mkinderwater/mk-timeclock/tools/acceptance/README.md

# Acceptance coverage

Run `python3 tests/run_current.py` from the package root. The obsolete per-employee-tab workbook fixture is replaced by the current two-tab, employee-block, precision and note-limit fixtures in the manifest. `WALKTHROUGH_CONTRACT.md` remains a broader acceptance plan, not a claim that physical-device workflows have been completed.
