mkinderwater/mk-timeclock/Timeclock-Wall-Mounting-Template.pdf

Timeclock wall mounting template | Case v8.34 · full size

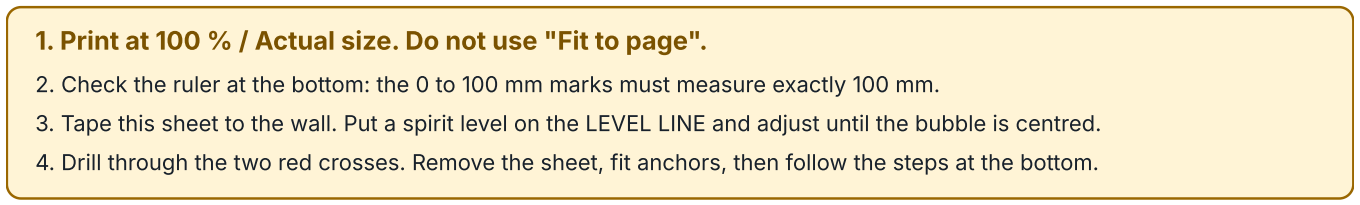
[picture p15: figure]

1. Print at 100 % / Actual size. Do not use "Fit to page".
2. Check the ruler at the bottom: the 0 to 100 mm marks must measure exactly 100 mm.
3. Tape this sheet to the wall. Put a spirit level on the LEVEL LINE and adjust until the bubble is centred.
4. Drill through the two red crosses. Remove the sheet, fit anchors, then follow the steps at the bottom.
LEVEL LINE | LEVEL LINE

Top edge of the clock

Power cable exits here

Centre

DRILL | DRILL

80 mm between screws

51 m

m

Grey shapes: keyholes on the back of the clock. The screw heads enter the round part, then the clock slides down 9 mm.

After drilling

1. Fit wall anchors in the two holes (use anchors that suit your wall).
2. Screw in two pan-head screws (head up to 8 mm wide, shank up to 4.3 mm). Leave the heads about 3 mm out from the wall.
3. Place the clock so the screw heads go into the round part
of the keyholes, then slide it down until it stops.
4. Plug in the power cable from below.

Dashed line: outline of the clock (128 × 140 mm) as it will hang

Scale check: 0 to 100 mm must measure exactly 100 mm

0 | 10 | 20 | 30 | 40 | 50 | 60 | 70 | 80 | 90 | 100
tape | tape
tape | tape

Mount away from direct sunlight and large metal surfaces, near a power socket, at a height staff can reach easily.

iCube Development (Calgary) Ltd. · mk-timeclock Lite
