mkinderwater/mk-timeclock/assembled.stl

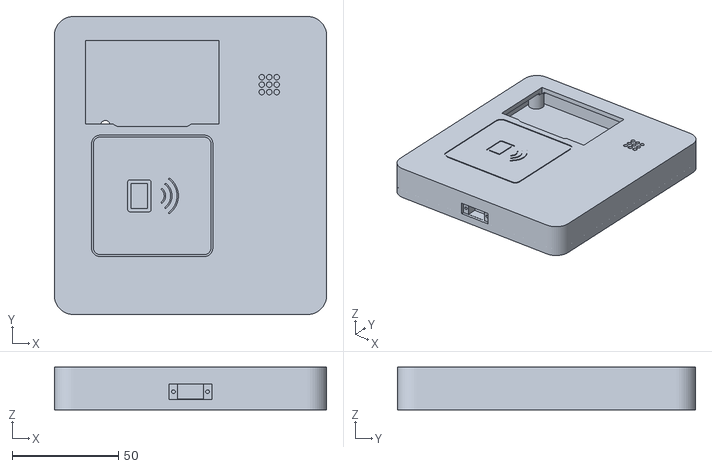
[picture p16: CAD file, 2026-10-24]
assembled.stl
128.0 x 140.0 x 20.0
