mkinderwater/mk-timeclock/front-wifi.stl

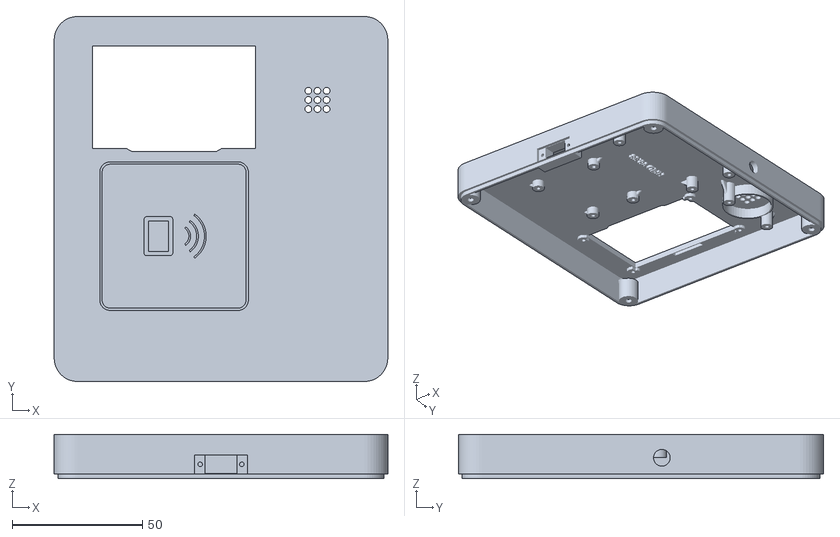
[picture p17: CAD file, 2026-10-25]
front-wifi.stl
128.0 x 140.0 x 17.0
