mkinderwater/mk-timeclock/back.stl

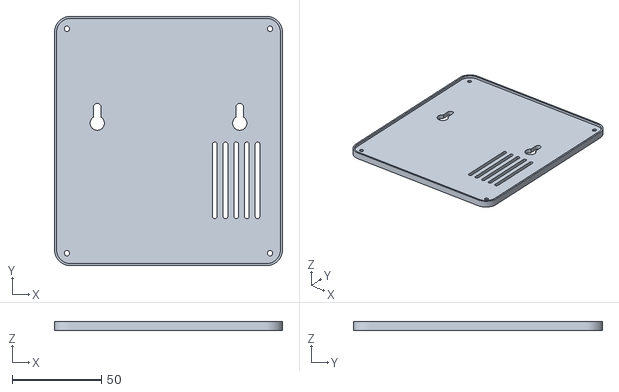
[picture p18: CAD file, 2026-10-24]
back.stl
128.0 x 140.0 x 4.80
