mkinderwater/mk-timeclock/(list of files, cad)

Other CAD files:
front.stl
