mkinderwater/mk-timeclock/validation/RC5.23-build.txt

PASS make ui all lint and Python compilation.
Six targeted checks passed. Actual setup handlers and configure function exercised with isolated files, simulated Primary API and systemctl outcomes. Source fallback and installed CSS checked. All three service failure points leave no marker. Saved credentials finish setup without re-poll after in-memory state reset. Slow Primary response leaves GET responsive and rejects concurrent setup actions. Desktop/mobile and dark/light setup checks pass. No full application suite repeated; no hardware deployment performed.
