mkinderwater/mk-timeclock/Timeclock-Employee-Guide.pdf

# Timeclock Employee Guide

I C U B E D E V E L O P M E N T ( C A L G A R Y ) LT D .

### How to tap in and out, explain a late start or early departure, check

your timesheet and request vacation.

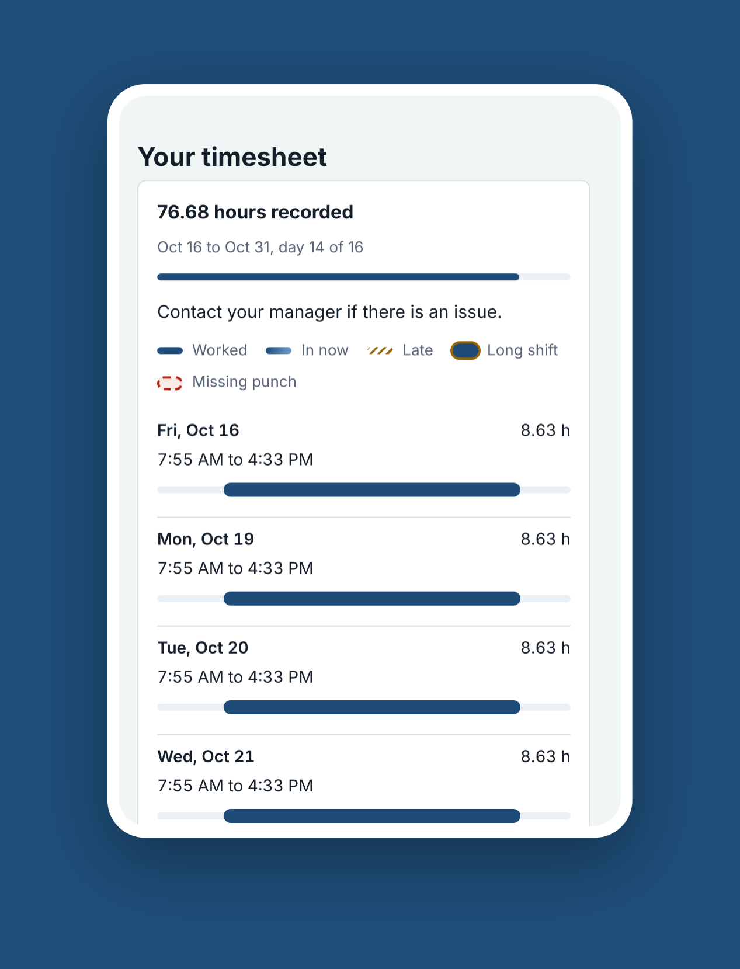
[picture p42: figure]
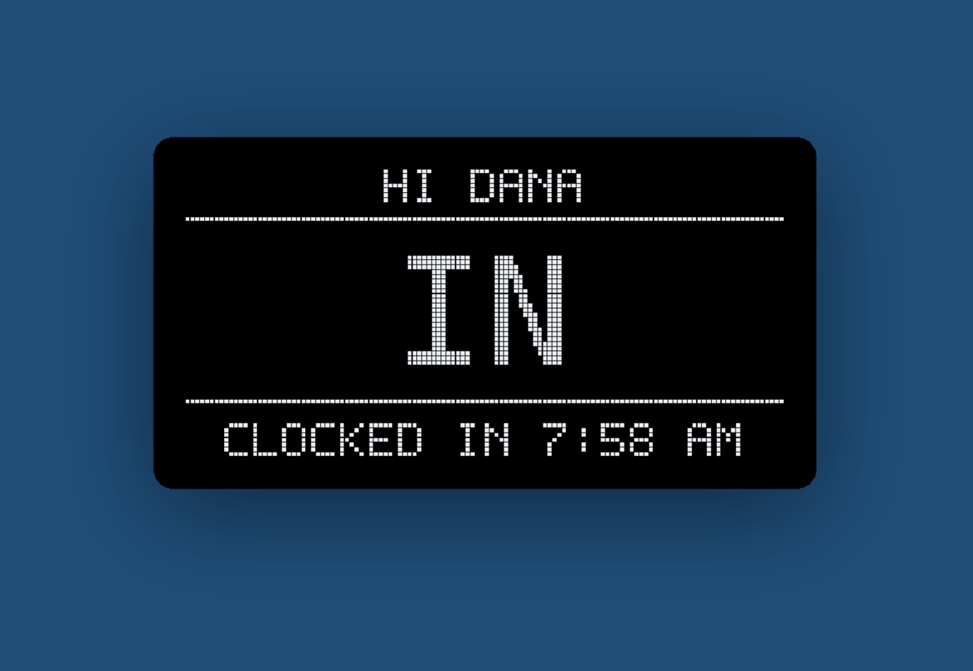
[picture p43: figure]

mk-timeclock Lite 1.9.5 | -RC6.1 | For employees

STA RT H ERE

# What you will use

You don't need a password or an account. You need your timeclock card and your work email.

ITEM | WHAT IT IS FOR
Your timeclock card | Tap it on the clock when you arrive and when you leave. The card is yours alone. Never tap for anyone else, and don't lend your card.
The clock screen | Confirms every tap. The big word tells you what was recorded.
Your work email | The clock emails you about late starts, early departures, missed punches, your timesheet and vacation. Most emails contain a private link.
Private links | Open your timesheet, your late-arrival or early-departure reason, or your vacation page. Each link belongs to you only and stops working after a set time. Don't forward them.
Your manager | Fixes anything the clock got wrong and records sick days and other time away. Only your manager can change a punch time.

### In this guide

1
Tapping in and
out
| What each clock screen means

4 Checking your
timesheet
| Your hours for each pay period

2 Emails from the
timeclock
| Which messages you can receive and what to do

5 Requesting
vacation
| Vacation requests and your vacation history

3 Late arrivals and
early departures
| When a tap is flagged, and adding a reason

6 Problems and quick
answers
| Expired links and common situations

New in this version
Your timesheet is view only. There's no Approve button and no "Something is wrong" button any more. If anything looks wrong, contact your manager (Chapter 4).
Daily attendance email. If your company turns it on, you get one email at the end of each day you work, with your taps and hours (Chapter 2).
Offline screen. When a clock can't reach the main clock, it says OFFLINE and counts the taps it's holding (Chapter 1).

It records when you tapped in and out. It doesn't calculate your pay, breaks or overtime. If something about

The screenshots come from the actual timeclock software running on sample data. The names and addresses (Dana Morales, Sam Patel, Jordan Lee, Riley Chen, timeclock.example.com) are made up. Your own screens will show your name, your company's web address and your own hours.

mk-timeclock Lite 1.9.5-RC6.1 | Timeclock Employee Guide | 2

C H A PTER 1

# Tapping in and out

When nobody is using the clock, it shows the date, the time and TAP YOUR CARD. The bars in the top corner show Wi-Fi signal strength.

You don't choose IN or OUT. The clock decides from your previous tap: your first tap starts your shift (IN) and your next tap ends it (OUT).

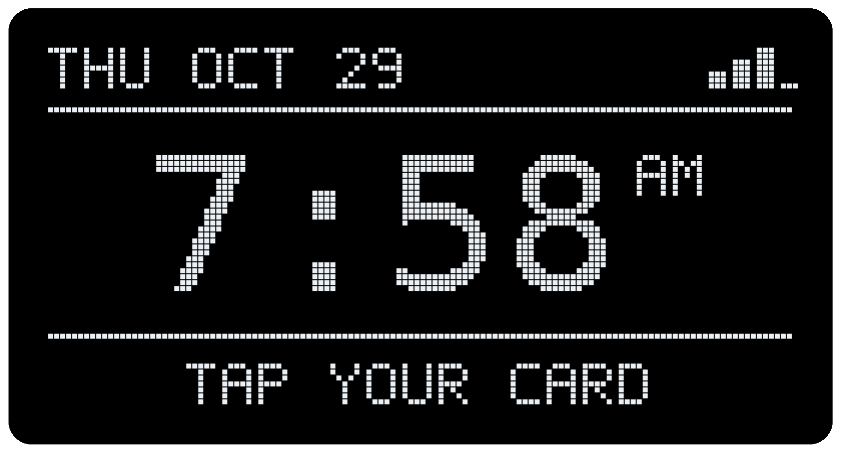
[picture p44: figure]

Waiting for a card

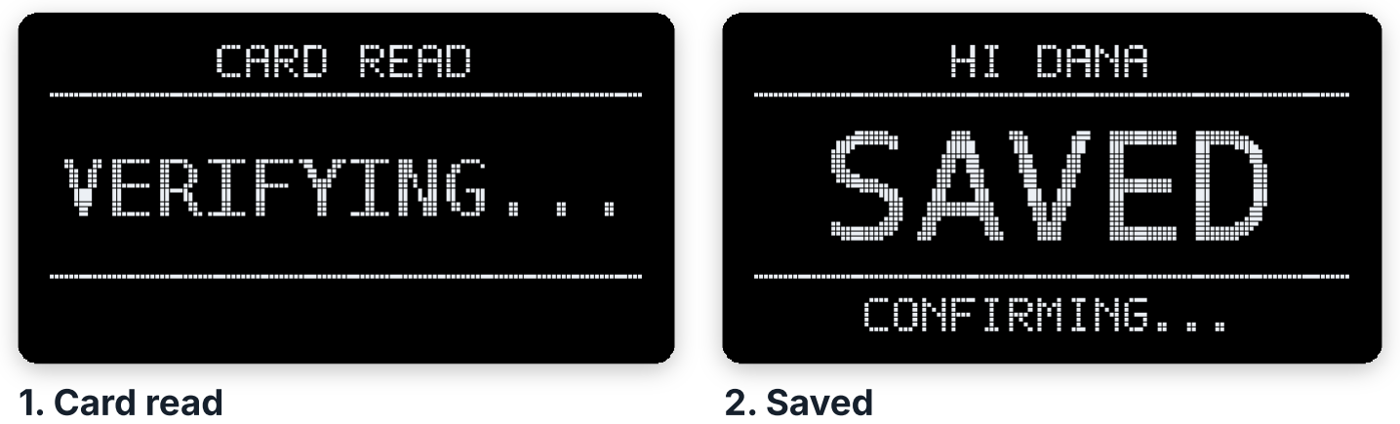
[picture p45: figure]
1. Card read; 2. Saved

The clock is checking your card.

Your tap is stored and being confirmed.
3. The result

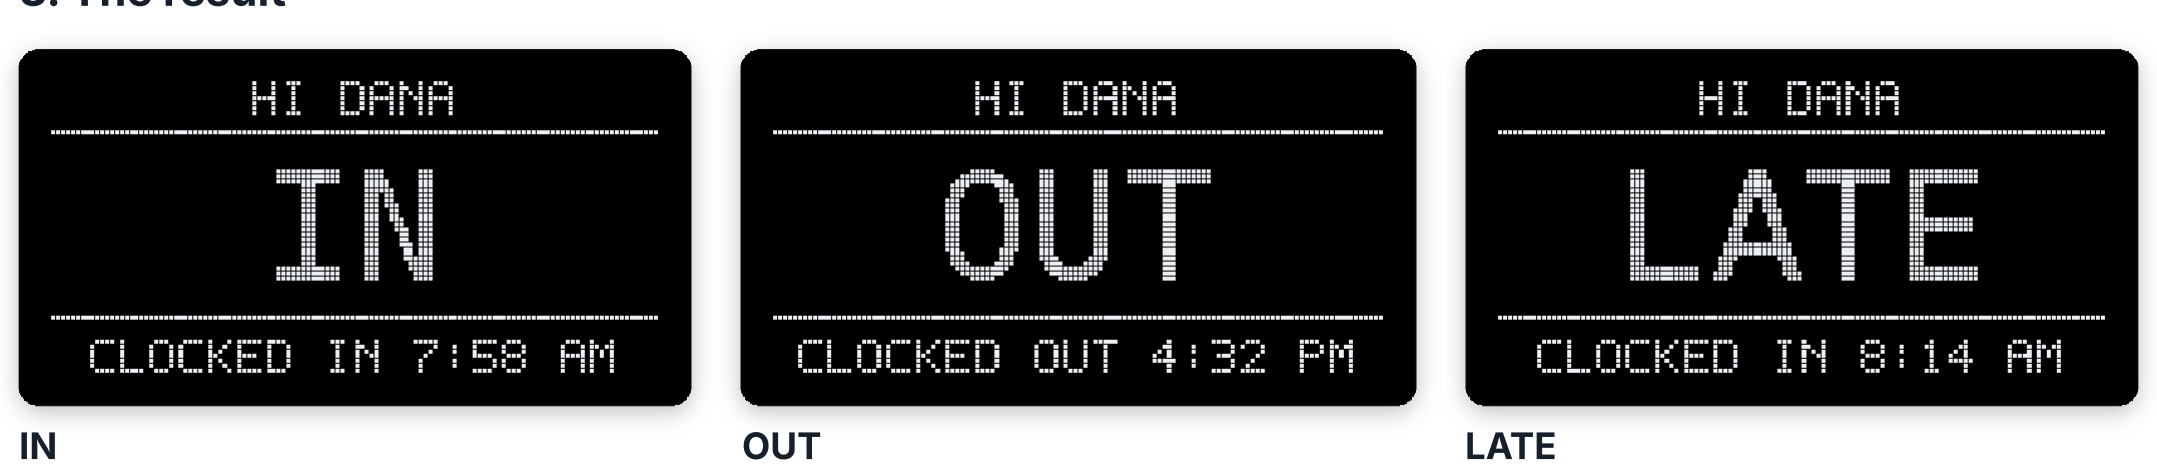
[picture p46: figure]
OUT; LATE

Your shift has started. The bottom line

Your shift has ended. Tap out every

You're clocked in, but later than your

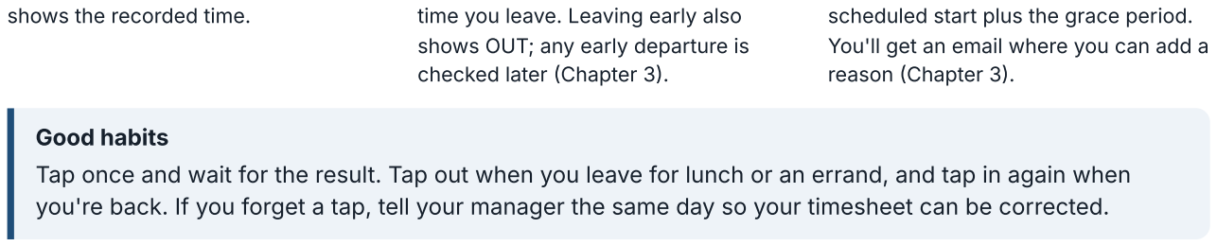
[picture p47: figure]
shows the recorded time.; time you leave. Leaving early also shows OUT; any early departure is checked later (Chapter 3).; scheduled start plus the grace period. You'll get an email where you can add a reason (Chapter 3).; Good habits

Tap once and wait for the result. Tap out when you leave for lunch or an errand, and tap in again when you're back. If you forget a tap, tell your manager the same day so your timesheet can be corrected.

1 Hold your card flat against the reader until the screen changes. The clock shows CARD READ / VERIFYING... and then SAVED / CONFIRMING.... Keep your card away from the reader while it does this.

2

Within a few seconds, a big IN, OUT or LATE appears, with your name at the top and the recorded time at the bottom. You'll also hear a short beep pattern.

3

C H A PTER 1 , C O N TI N U E D

# Other clock messages

Some taps produce a different screen. Here is what each one means and what to do.

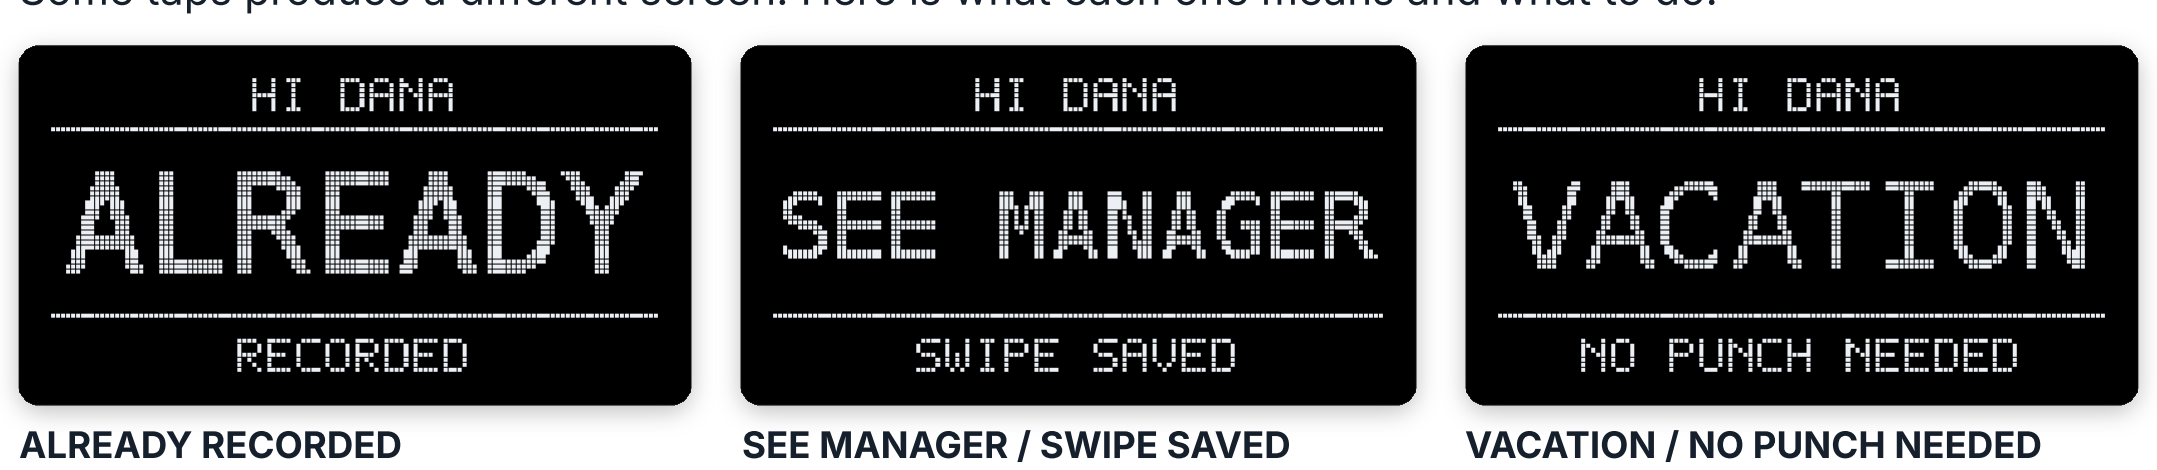
[picture p48: figure]
ALREADY RECORDED; SEE MANAGER / SWIPE SAVED; VACATION / NO PUNCH NEEDED

You tapped again right after a tap that was already counted. Nothing new is recorded. No action needed.

Your tap was saved, but it needs a manager to look at it. Let your manager know.

Your account is set up to track vacation only, so you don't need to tap in or out. Nothing is recorded.

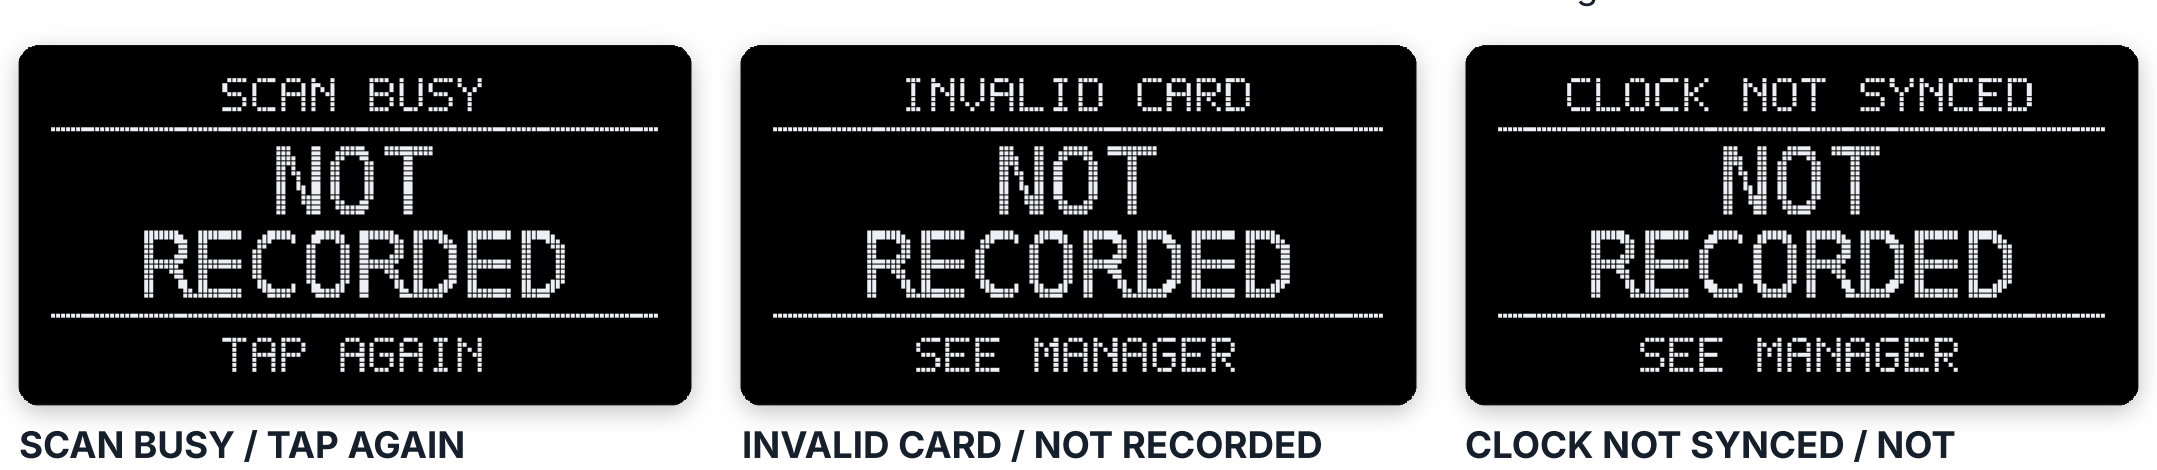
[picture p49: figure]
SCAN BUSY / TAP AGAIN; INVALID CARD / NOT RECORDED; CLOCK NOT SYNCED / NOT
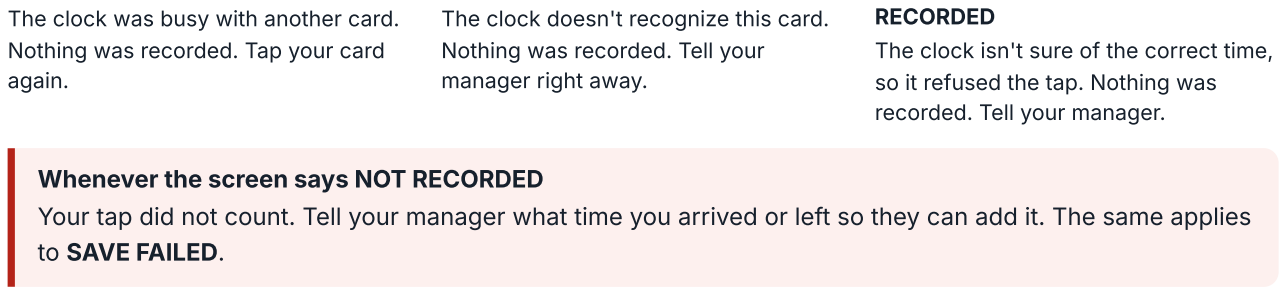
[picture p50: figure]
Nothing was recorded. Tap your card again.; Nothing was recorded. Tell your manager right away.; RECORDED; so it refused the tap. Nothing was recorded. Tell your manager.; Whenever the screen says NOT RECORDED; to SAVE FAILED.

The clock was busy with another card.

The clock doesn't recognize this card. The clock isn't sure of the correct time,

Your tap did not count. Tell your manager what time you arrived or left so they can add it. The same applies

### When the clock is offline

If a clock loses its connection, it keeps working for cards it already knows. Your tap is saved on the clock and you'll see SAVED / CONFIRMING... instead of IN or OUT. The idle screen says OFFLINE at the top and counts the waiting taps, for example 3 SWIPES SAVED. You may also hear a short chirp every few minutes. When the connection returns, it shows SENDING 2 SWIPES while it catches up. Saved taps keep their original time, so you don't need to tap again. A new card can't be used until the clock is back online.

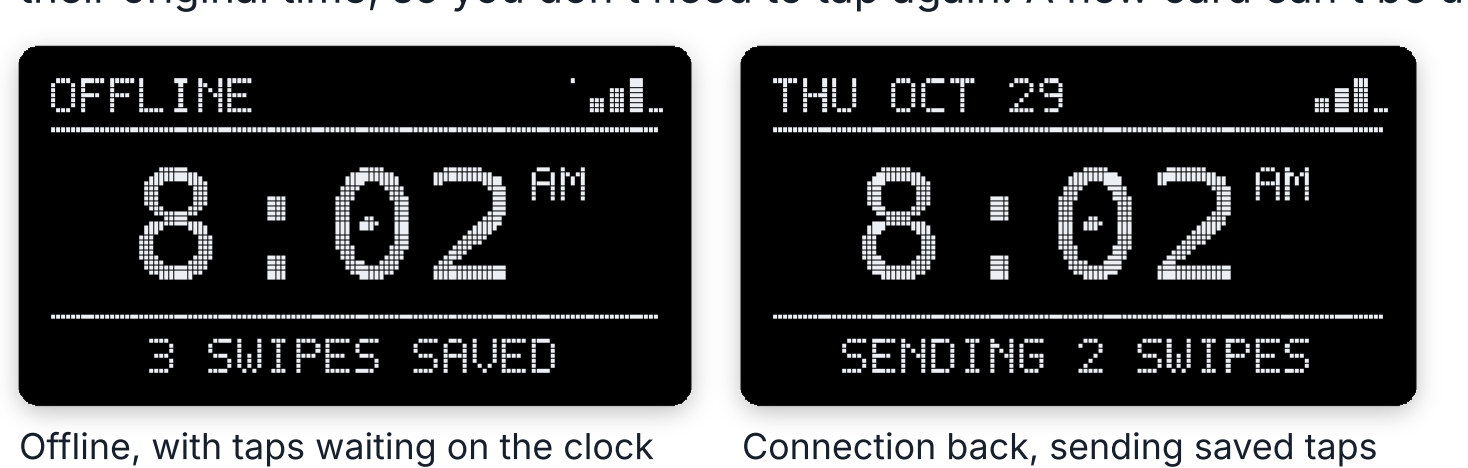
[picture p51: figure]

Offline, with taps waiting on the clock Connection back, sending saved taps

# Emails from the timeclock

Emails come from your company's timeclock address. Your company decides which ones are turned on, so you might not receive all of them.

EMAIL | WHEN IT COMES | WHAT TO DO
Welcome to the timeclock | When your manager sets you up on
the timeclock

Keep it. It contains your link for requesting vacation.

Late arrival on (date) | When you tap in later than your
scheduled start plus the grace period

Optional: add a reason with the link (Chapter 3).

Early departure on (date) Shortly after your scheduled finish, if your last tap out was earlier than the finish minus the grace period

Optional: add a reason with the link (Chapter 3).

No IN punch / No OUT punch for (date)

A few minutes after your scheduled start or finish, if you haven't tapped

Tell your manager the time you started or left. If you already tapped, or you're still working, ignore it.

Your attendance for (date)

NEW

At the end of each day you tapped, if your company turns it on

Check your taps for the day. Tell your manager if one is missing or wrong.

Your timesheet for (dates) At the end of each pay period, or when your manager sends you the link

Open the link and check your hours (Chapter 4).

Your recorded hours were
corrected

When your manager adds or changes one of your punches

Open your latest timesheet link and check the change.

Your vacation request link When you ask for one on the

Use it within 24 hours (Chapter 5).

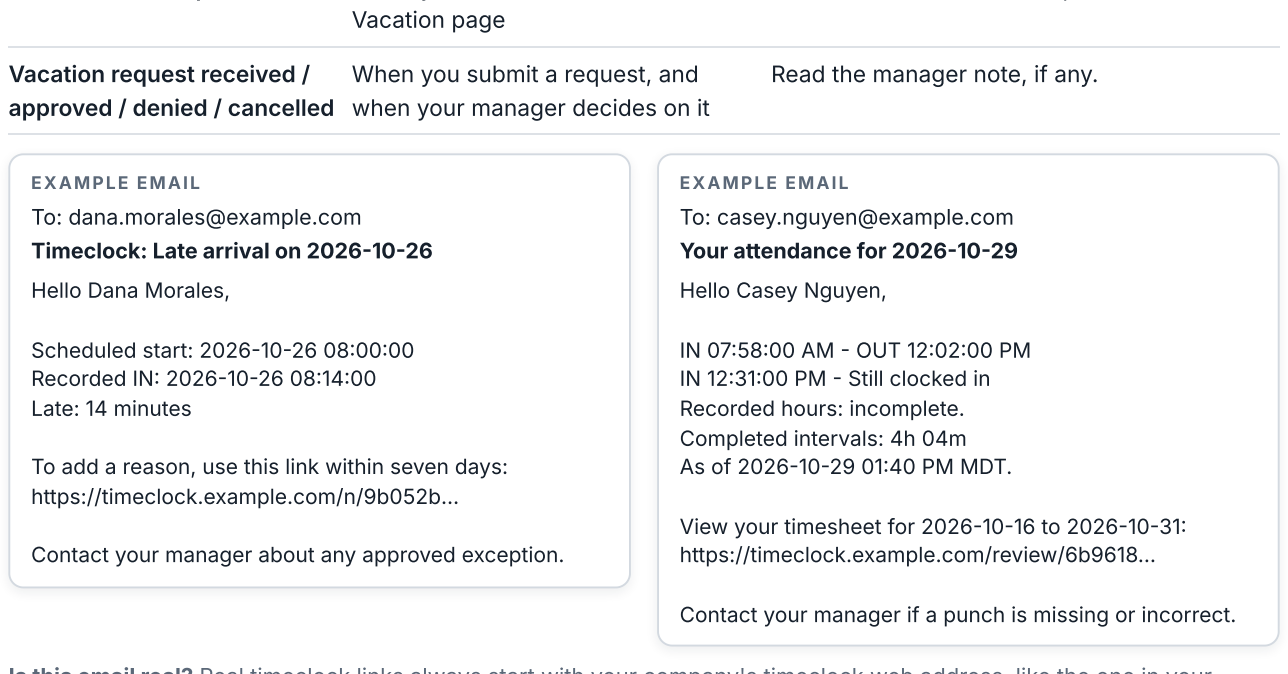
[picture p52: figure]
Vacation page; Vacation request received / approved / denied / cancelled; When you submit a request, and when your manager decides on it; Read the manager note, if any.; EXAMPLE EMAIL To: dana.morales@example.com Timeclock: Late arrival on 2026-10-26; Hello Dana Morales,; Scheduled start: 2026-10-26 08:00:00 Recorded IN: 2026-10-26 08:14:00 Late: 14 minutes; https://timeclock.example.com/n/9b052b...; EXAMPLE EMAIL To: casey.nguyen@example.com Your attendance for 2026-10-29; Hello Casey Nguyen,; OUT 12:02:00 PM; Still clocked in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

To add a reason, use this link within seven days:

Contact your manager about any approved exception.

View your timesheet for 2026-10-16 to 2026-10-31:

Contact your manager if a punch is missing or incorrect.

Is this email real? Real timeclock links always start with your company's timeclock web address, like the one in your welcome email. The timeclock never asks for a password. If you're unsure, ask your manager before you click.

# Late arrivals and early departures

Your company sets a short grace period on each clock, usually 5
minutes. Taps inside the grace period are on time. Beyond it, the
minutes count from your scheduled start or finish, rounded up to the next minute.

### Late arrival

Your first tap in for a shift is late when it's after your scheduled start plus the grace period. The clock shows LATE and emails you right away.

Coming back from lunch or an errand is never late. Only the first tap in for a shift counts.

### Early departure

Your last tap out is early when it's before your scheduled finish minus the grace period. The clock still shows OUT. The check happens shortly after your scheduled finish plus the grace period, so a tap out for lunch or an errand isn't flagged if you tap back in before then.

The late arrival page

START 8:00, GRACE 5 MIN | FINISH 4:30 PM, GRACE 5 MIN
8:05:00 | On time | 4:25:00 PM | On time
8:05:01 | Late: 6 minutes | 4:24:59 PM | Early: 6 minutes
8:14:00 | Late: 14 minutes | 3:52:00 PM | Early: 38 minutes

For an overnight shift, the finish is the next morning.

Approved full-day vacation, and absences your manager has recorded as excused, aren't flagged as late or early. Without a schedule for that day, nothing is flagged.

C H A PTER 3, C O N TI N U E D

# Adding a reason

The Late arrival and Early departure emails contain a private link. Use it to tell your manager why. Adding a reason is optional.

Your reason can be up to 500 characters.

A reason doesn't change your punch time
The tap stays at the time it was recorded. Only your manager can correct a punch time. If the clock got the time wrong, contact your manager.

### After you save

The page shows Done Reason saved to your timesheet. The reason now appears next to that punch on your timesheet.
You can change the reason using the same link for seven days, or until the pay period closes, whichever comes first. After that, the page says This link is closed. Contact your manager if a correction is needed.

Your manager can also add a note to a late or early punch. It shows on your timesheet in place of your reason.

A late arrival reason, saved

1 | Open the link in the email.
| Check the details: when you tapped, the direction (IN or OUT) and how many minutes late or early.
2

Type a reason, or tap a quick reason: Traffic, Bus or Appointment. Other just moves the cursor into the box so you can type.

3

4 Tap Save reason.

# Checking your timesheet

At the end of each pay period, you'll get an email with a private link to your timesheet. Your manager can also send you the link at any time, and the daily attendance email (if your company uses it) includes it too.

### What the page shows

Top line: your total recorded hours for the pay period, and where you are in it, for example day 14 of 16 or period ended.
One row per shift: the day, your IN and OUT times, the hours between them and a bar across the day. A shift that ends after midnight is marked (next day). A shift you're still in says Clocked in, no OUT yet.
Flags on a row: | Late: 14 min , | Left early: 38 min ,
Manager-added punch , | Manager correction , or | Missing punch .
Reason: your late-arrival or early-departure reason, your manager's note, or the reason your manager gave for a correction.
Stat holidays, vacation and absences your manager recorded. These add 0.00 h because no punches are recorded on those days. Stat holidays say Not counted as vacation.

Hours are the time between your IN and OUT taps. The timeclock doesn't deduct breaks or calculate pay.

Dana's timesheet, part way through the period

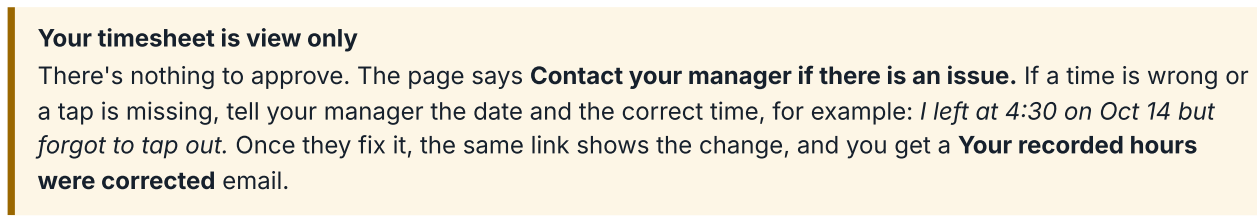
[picture p53: figure]
Your timesheet is view only; were corrected email.

There's nothing to approve. The page says Contact your manager if there is an issue. If a time is wrong or a tap is missing, tell your manager the date and the correct time, for example: I left at 4:30 on Oct 14 but forgot to tap out. Once they fix it, the same link shows the change, and you get a Your recorded hours

C H A PTER 4, C O N TI N U E D

# Flags, corrections and missing punches

### Late and early rows

A late arrival or early departure shows its flag and minutes, followed by the reason. If you added a reason with the link in your email, it appears here. If your manager added a note, you see their note instead.

### Manager corrections

When your manager adds a punch you forgot, the row is flagged Manager-added punch with their reason. A punch they moved is flagged Manager correction . The original tap is always kept in the records.

Sam's forgotten OUT, added by his manager

### Missing punches

If a shift is missing its IN or OUT, the row shows Missing punch and the top of the page counts the incomplete shifts. Tell your manager the time. The hours for that shift aren't counted until it's fixed.

### If you're set up for vacation only

Your page lists your vacation days and stat holidays. You don't need to tap the clock.

Dana's late arrival with her reason, and her early departure with her manager's note

# Requesting vacation

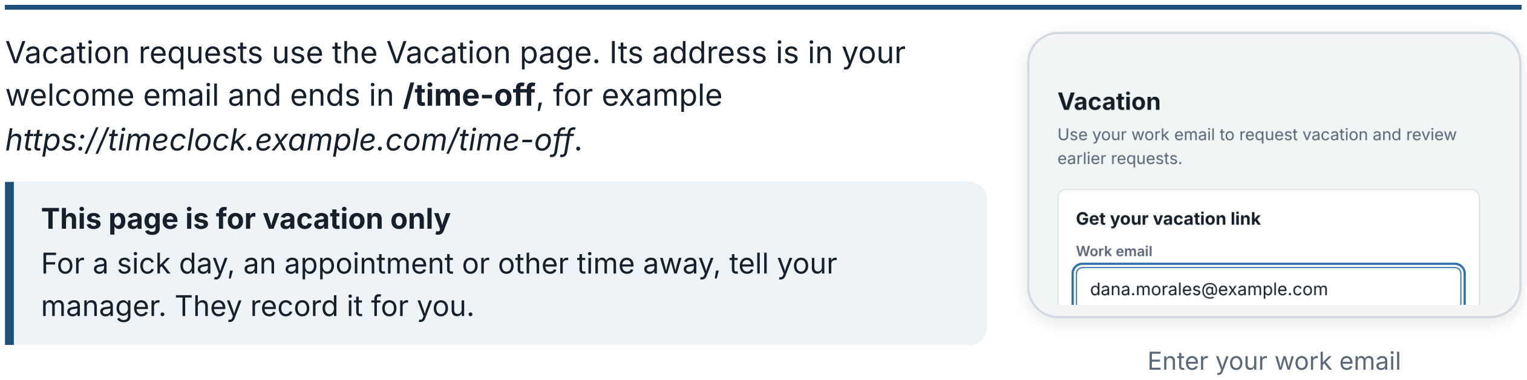
[picture p54: figure]
https://timeclock.example.com/time-off.; This page is for vacation only; manager. They record it for you.; Enter your work email

Vacation requests use the Vacation page. Its address is in your welcome email and ends in /time-off, for example

For a sick day, an appointment or other time away, tell your

### Get your private link

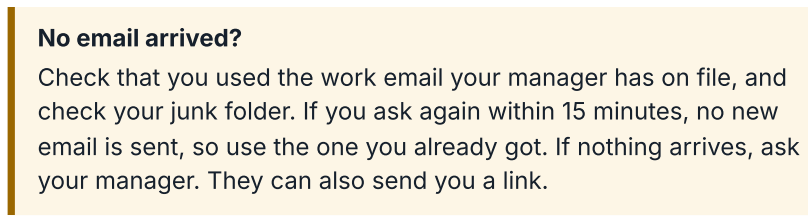
[picture p55: figure]
No email arrived?

Check that you used the work email your manager has on file, and check your junk folder. If you ask again within 15 minutes, no new email is sent, so use the one you already got. If nothing arrives, ask your manager. They can also send you a link.

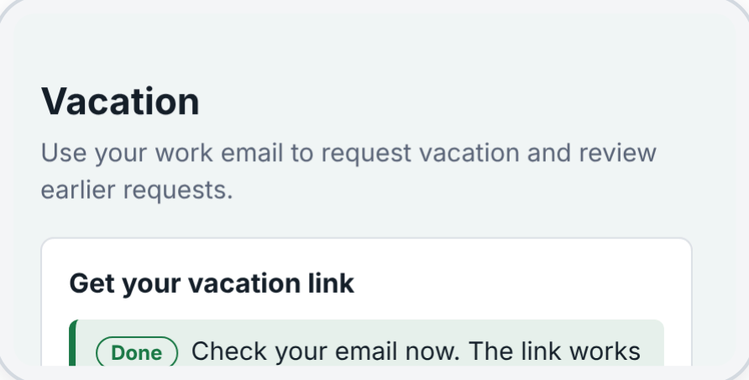
[picture p56: figure]

Link sent

1 | Open the Vacation page.
2 | Enter your work email and tap Send private link.
| The page says Check your email now. The link works for 24 hours.
3

4 Open the email Your vacation request link and tap the link.

C H A PTER 5, C O N TI N U E D

# Making a request

Your private page has two parts: Request vacation and Vacation history.

### Your vacation allowance

The grey box shows your approved vacation for the calendar year, for example 2026: Vacation: 5 of 15 days used. It counts approved vacation days, including future ones. Waiting, denied and cancelled requests aren't counted, and neither are stat holidays.
It's for your information only. You can still request more days than your allowance, and your manager decides. If your request crosses New Year, each year is shown separately. If no allowance is set for you, it says unspecified.

A completed request

Pick the Starting date. The Ending date fills in with the same date for a one-day request. Change it for a longer one. Both dates are included.

1

The page shows the working days, for example 8 vacation days + 2 stat holidays, and names each holiday. Working days follow your schedule. Stat holidays are not counted as vacation. If you don't have a fixed schedule, it counts weekdays as an estimate.

2

3 Check Return to work (suggested) and change it if needed. Add Notes for your manager if you want (up to 500 characters). For a half day, explain it here.

4

5 Tap Request vacation.

C H A PTER 5, C O N TI N U E D

# After you submit

The page shows Done Vacation request submitted. Your manager will review it. Your new request appears at the top of your vacation history as Waiting .

You'll get a confirmation email, and another email when your manager approves or denies the request. If an approval is later cancelled, you'll be told by email too.

### Request status

Waiting | Your manager hasn't decided yet.
Approved | The vacation is booked. It appears on your timesheet.
Denied | Not approved. Read the manager note for the reason.
Cancelled | An approval your manager later cancelled.

Each request shows its dates, the number of vacation days, your return date, any stat holidays inside it and any manager note. To change or cancel a request, contact your manager. You can't edit a request after you submit it.

EXAMPLE EMAIL
To: dana.morales@example.com
Vacation request received: 2026-12-21 to 2026-12-31
Hello Dana Morales,

Your vacation request for 2026-12-21 to 2026-12-31 (8 working days, returning 2027-01-04) was sent to your manager.

Status: Pending.

The private link stops working 24 hours after it was sent. To come back later, request a new link from the Vacation page.

The new request is waiting

Shown below the form after submitting

# Problems and quick answers

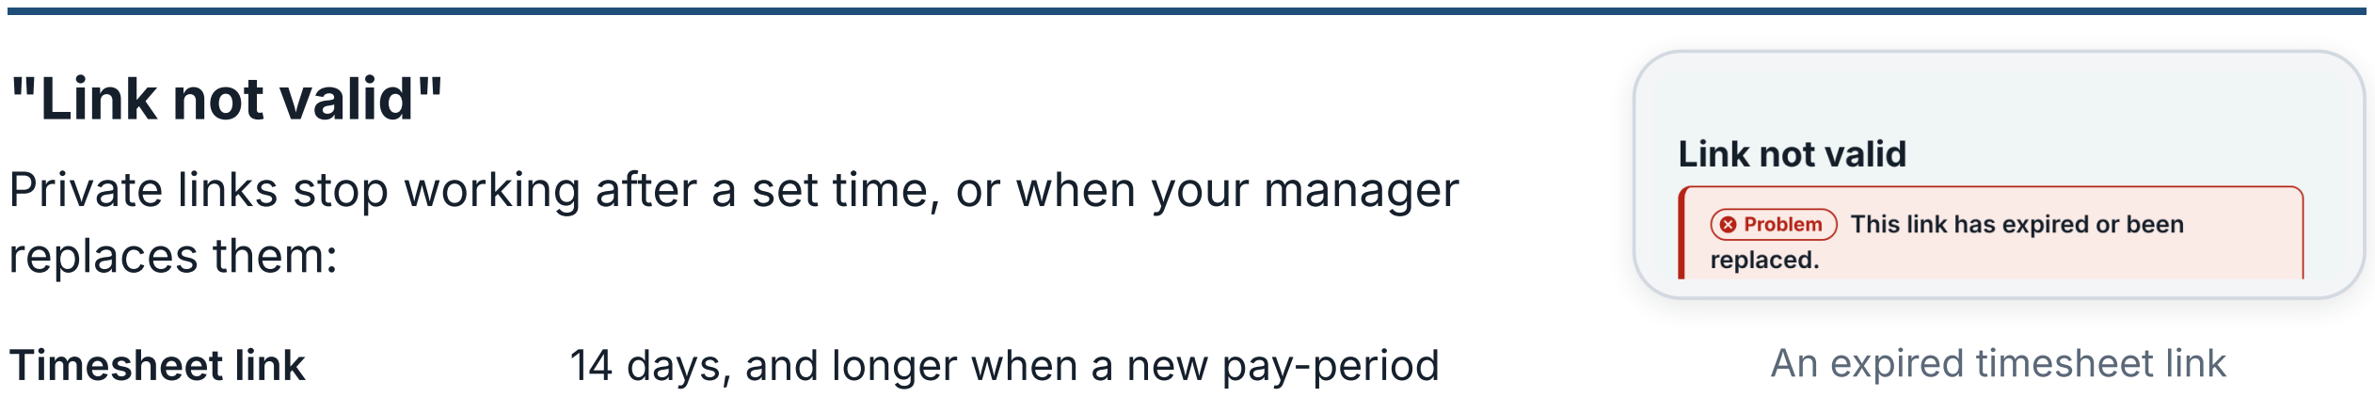
[picture p57: figure]
"Link not valid"; replaces them:; An expired timesheet link

Private links stop working after a set time, or when your manager

Timesheet link | 14 days, and longer when a new pay-period email is sent. Ask your manager for a new one.
Late or early reason | 7 days, or until the pay period closes.
Vacation link | 24 hours. Request a new one from the Vacation page.
SITUATION | WHAT TO DO
I forgot to tap in or out | Tell your manager the actual time, the same day if you can. Don't tap later to make up for it, because the clock records the time you tap.
I tapped twice by mistake | If the screen said ALREADY RECORDED, nothing extra was saved. Otherwise, tell your manager.
The screen said NOT RECORDED | Your tap didn't count. Tell your manager the time.
The screen said OFFLINE | Tap as usual. Your taps are saved on the clock and sent when it reconnects.
I got an Early departure email, but I came back | A tap out isn't flagged when you tap back in before your scheduled finish. If you came back but forgot to tap in, tell your manager your return time.
My lateness or early departure was approved | Add the reason with the link in the email. Your manager can also add a note.
My card is lost or damaged | Tell your manager. They'll give you a replacement and the old card stops working. Your past punches are kept.
My timesheet hours look wrong | Contact your manager with the date and the correct time. There's no button on the timesheet for this.
I need a sick day or other time away | Tell your manager. The Vacation page is for vacation only.
I want to cancel a vacation request | Contact your manager.
Someone asks to use my card, or to | Say no. Each card records only its owner's attendance.

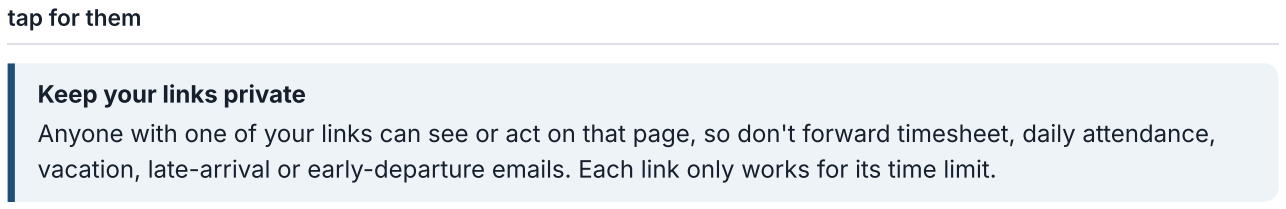
[picture p58: figure]
tap for them; Keep your links private

Anyone with one of your links can see or act on that page, so don't forward timesheet, daily attendance, vacation, late-arrival or early-departure emails. Each link only works for its time limit.
