mkinderwater/mk-timeclock/Timeclock-Manager-Guide.pdf

# Timeclock Manager Guide

I C U B E D E V E L O P M E N T ( C A L G A R Y ) LT D .

### Daily checks, employees and cards, attendance corrections, late

and early flags, vacation, pay-period review and payroll reports.

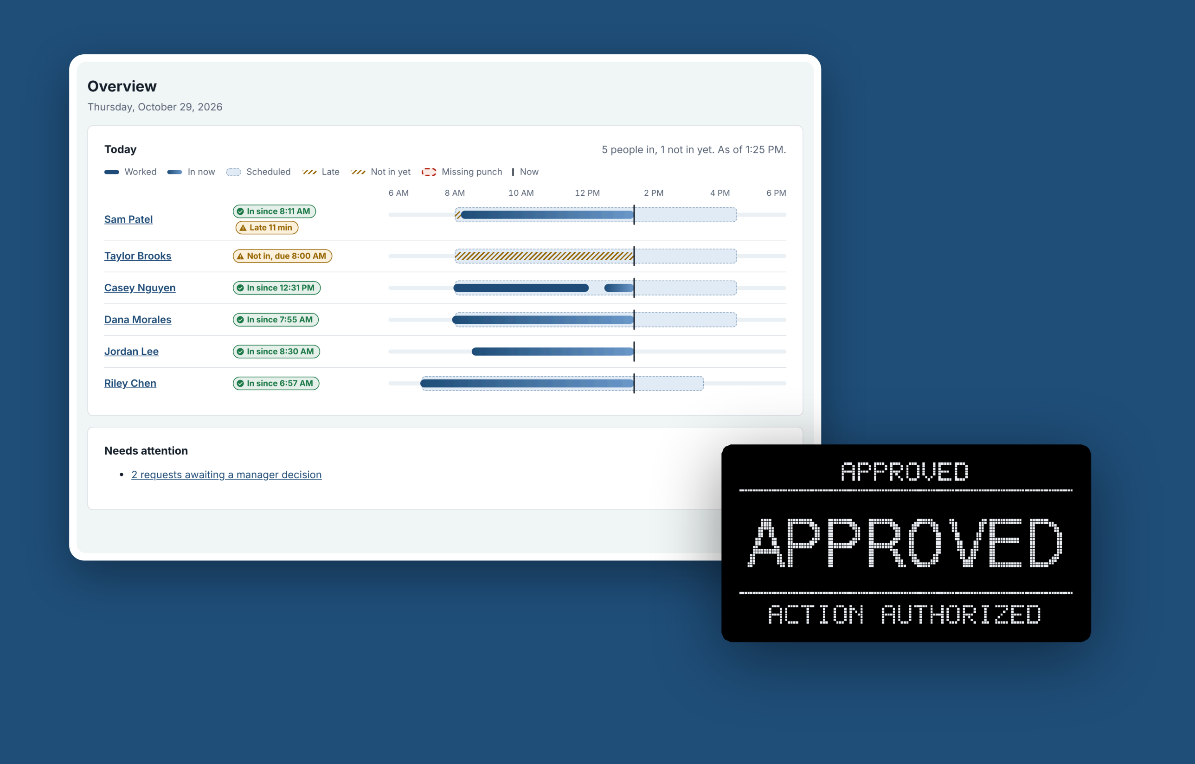
[picture p59: figure]

mk-timeclock Lite 1.9.5 | -RC6.1 | For managers

STA RT H ERE

# How the manager site works

You manage the timeclock from a web browser on the company network. Some changes also need your manager card, tapped on a clock.

### Signing in

Forgot your password? Another manager can reset it under Settings > Manager

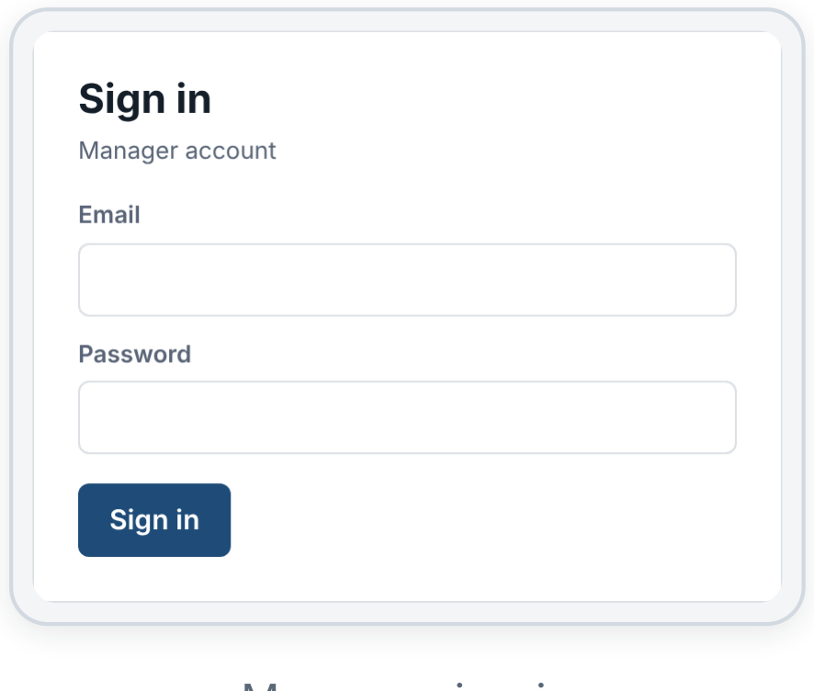
[picture p60: figure]

accounts. You can change your own password on the same page. | Manager sign-in

### The menu and red numbers

The menu has six items: Overview, Attendance, Employees, Pay periods, Vacation and Settings. A red number counts things a person needs to look at, such as a vacation request waiting for a decision. Counts for setup and device pages are added to Settings.

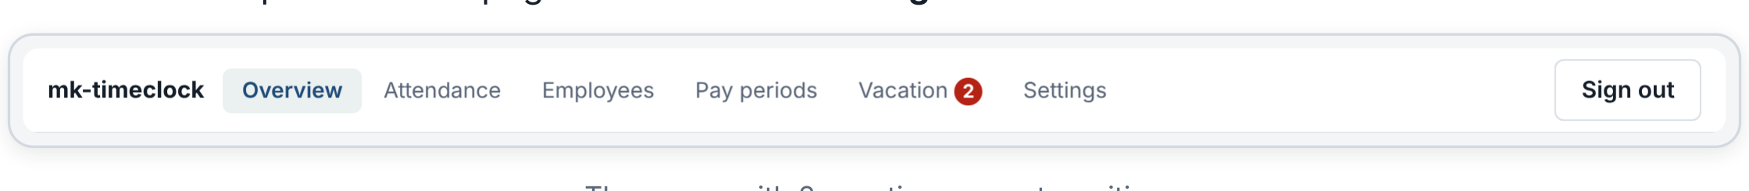
[picture p61: figure]

The menu, with 2 vacation requests waiting
The pages use the same colours:

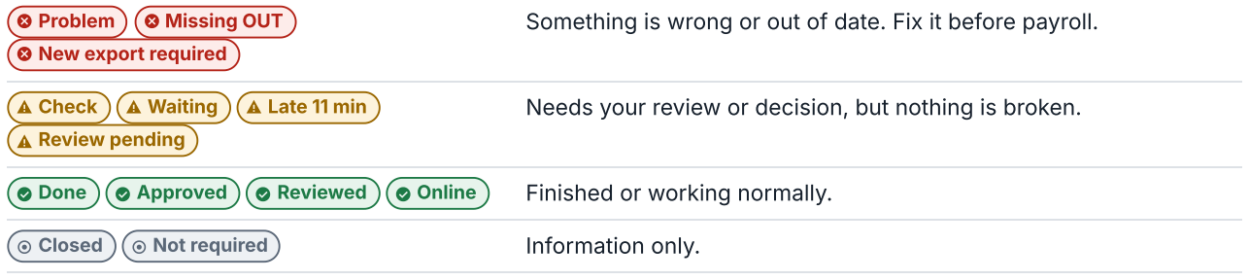
[picture p62: figure]
Problem; Missing OUT; New export required; Check; Waiting; Late 11 min; Review pending; Done; Approved; Reviewed; Online; Finished or working normally.; Closed; Not required; Information only.

Something is wrong or out of date. Fix it before payroll.

Needs your review or decision, but nothing is broken.

### Settings

Everything that isn't daily work is on the Settings page, in four groups: Company (pay schedule, bulk schedules, report delivery, stat holidays, employee emails and links, manager accounts and cards), Email (templates, outgoing email, email queue), Clock (grace, display, time sync, HTTPS, health, backups, clock management, system operations) and Audit (unknown cards, rejected uploads, raw swipe export, diagnostics, audit log). This guide writes these as, for example, Settings > Email queue.

Open the clock's web address in your browser, for example https://timeclock.example.com/login.

1

2 Enter your work email and password, then select Sign in. You stay signed in for up to 8 hours. Select Sign out (top right) when you finish on a shared computer.

3

mk-timeclock Lite 1.9.5-RC6.1 | Timeclock Manager Guide | 2

STA RT H ERE , C O N TI N U E D

# Your manager card

Your manager card is a separate card from any attendance card. It never records attendance. Its job is to prove that a manager is physically at a clock before the system makes a protected change.

### When a card tap is needed

Ticking or unticking Manager or Active on an employee Deactivating or reactivating a card
Creating, resetting, locking or unlocking a manager sign-in Saving Report delivery settings
Restoring a default email template
Changing the time zone
Downloading or restoring a backup, and every System operations action

Replacing a lost card, editing schedules, corrections, reviews and vacation decisions don't need a tap.

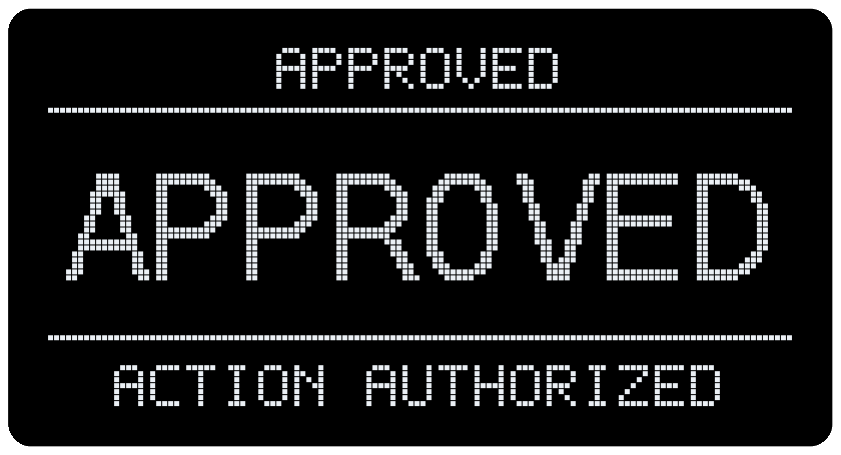
[picture p63: figure]

Approving a change

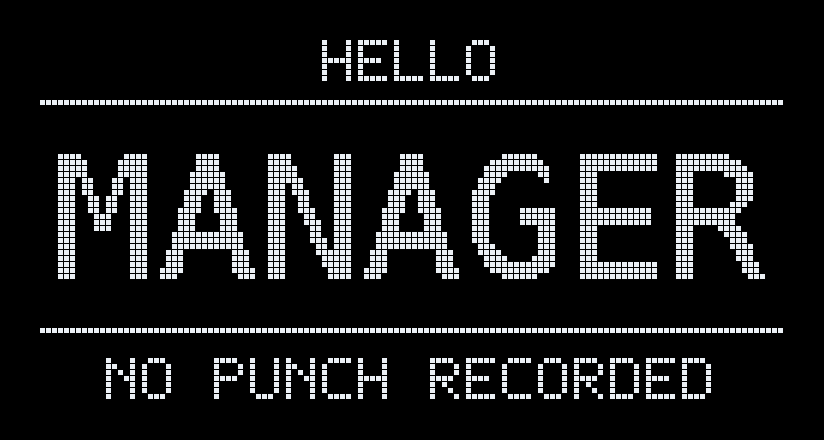
[picture p64: figure]

Manager card tapped at other times. Nothing is recorded.

### How it works

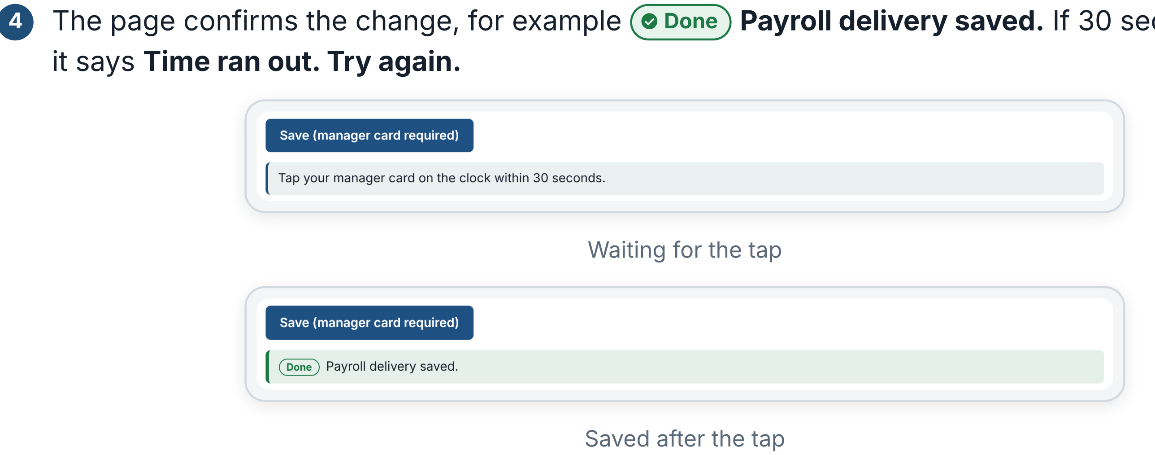
[picture p65: figure]
Waiting for the tap; Saved after the tap; it says Time ran out. Try again.

### Registering a manager card

Under Settings > Manager cards, select Scan a card (30 seconds), tap the new card on a clock, then select Register this card. The card is registered to your own account. Keep manager cards secure: anyone holding one can approve protected changes. The clock won't let you remove the last active

Use a separate attendance card for your own hours. A manager card tap never counts as attendance, and a manager card can't be added to an employee as an attendance card.

1 | Select the button on the web page. Buttons that need a card usually say (manager card required).
2 | The page shows Tap your manager card on the clock within 30 seconds.
3 | Tap your manager card on a clock. It shows APPROVED / ACTION AUTHORIZED.
The page confirms the change, for example | Done Payroll delivery saved. If 30 seconds pass first,

C H A PTER 1

# Daily checks

A quick look each morning catches most problems while they are still easy to fix.

### Overview

Today shows one row per active Punch required employee, with a bar across the day. The dashed slot is

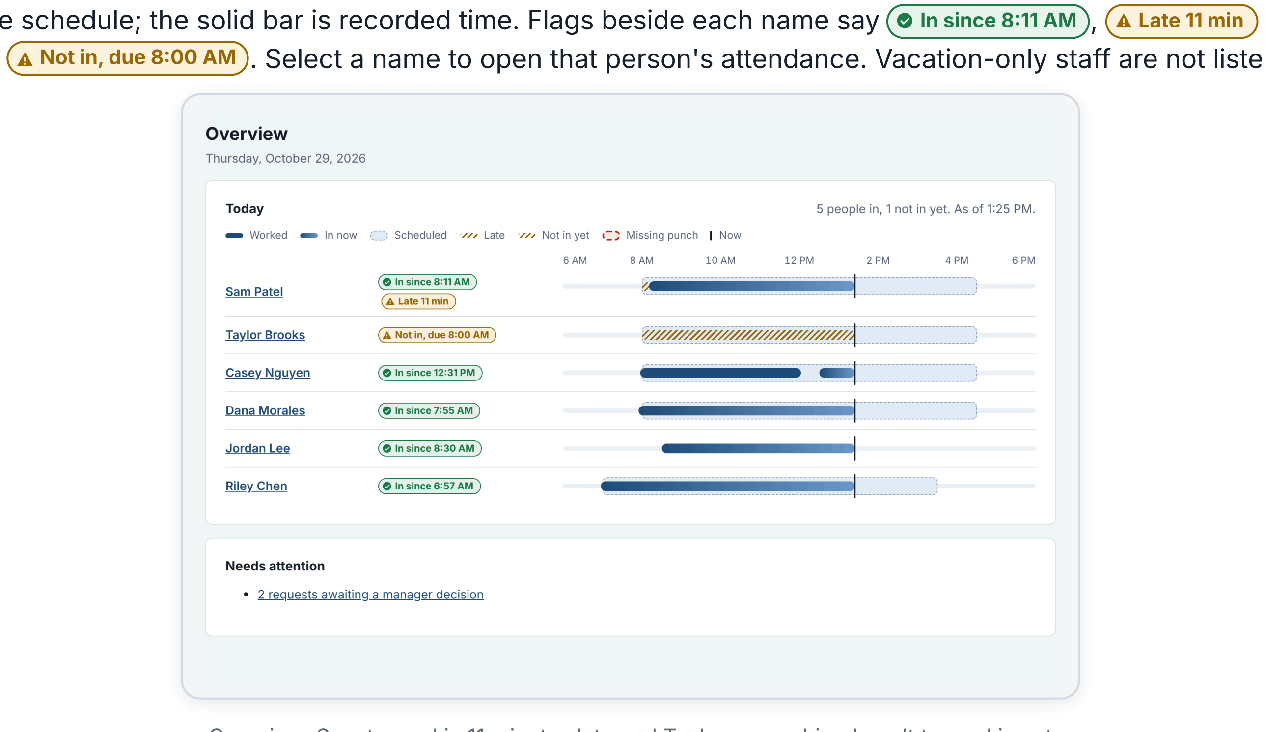
[picture p66: figure]

the schedule; the solid bar is recorded time. Flags beside each name say | In since 8:11 AM , | Late 11 min
or | Not in, due 8:00 AM . Select a name to open that person's attendance. Vacation-only staff are not listed.

Overview: Sam tapped in 11 minutes late and Taylor, a new hire, hasn't tapped in yet

Needs attention
Lists every open issue as a link, for example ended periods not yet closed, vacation requests waiting, employee records missing a schedule or email, failed emails, clocks not reporting, refused swipes, an old backup or a certificate about to expire.

Settings > Unknown cards
Cards that were tapped but don't belong to anyone, usually a new hire's card. Add the card to the employee (Chapter 2), then select Clear all unknown cards.

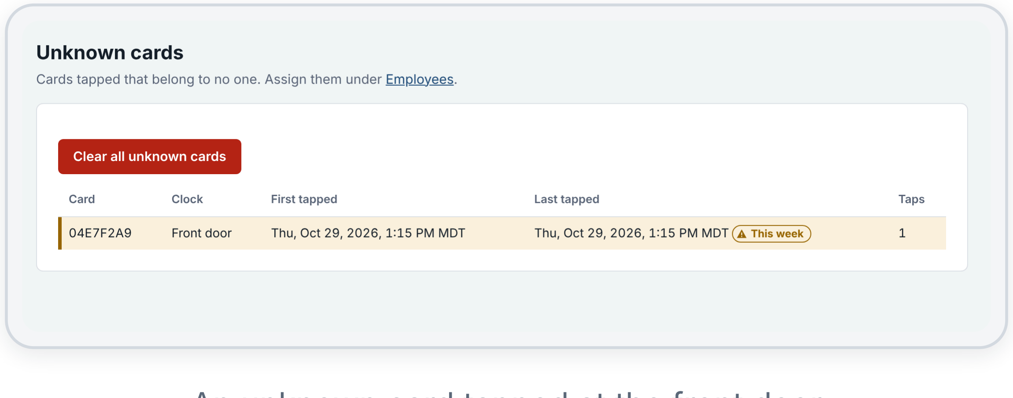
[picture p67: figure]

An unknown card tapped at the front door

Open the Overview. Read Needs attention and look for red numbers in the menu. Check that everyone expected is in. If a clock is not reporting, its taps are being saved on that clock and will arrive when it

# Employees and cards

Each employee has one record that holds their details, cards, schedule and email choices.

### Adding an employee

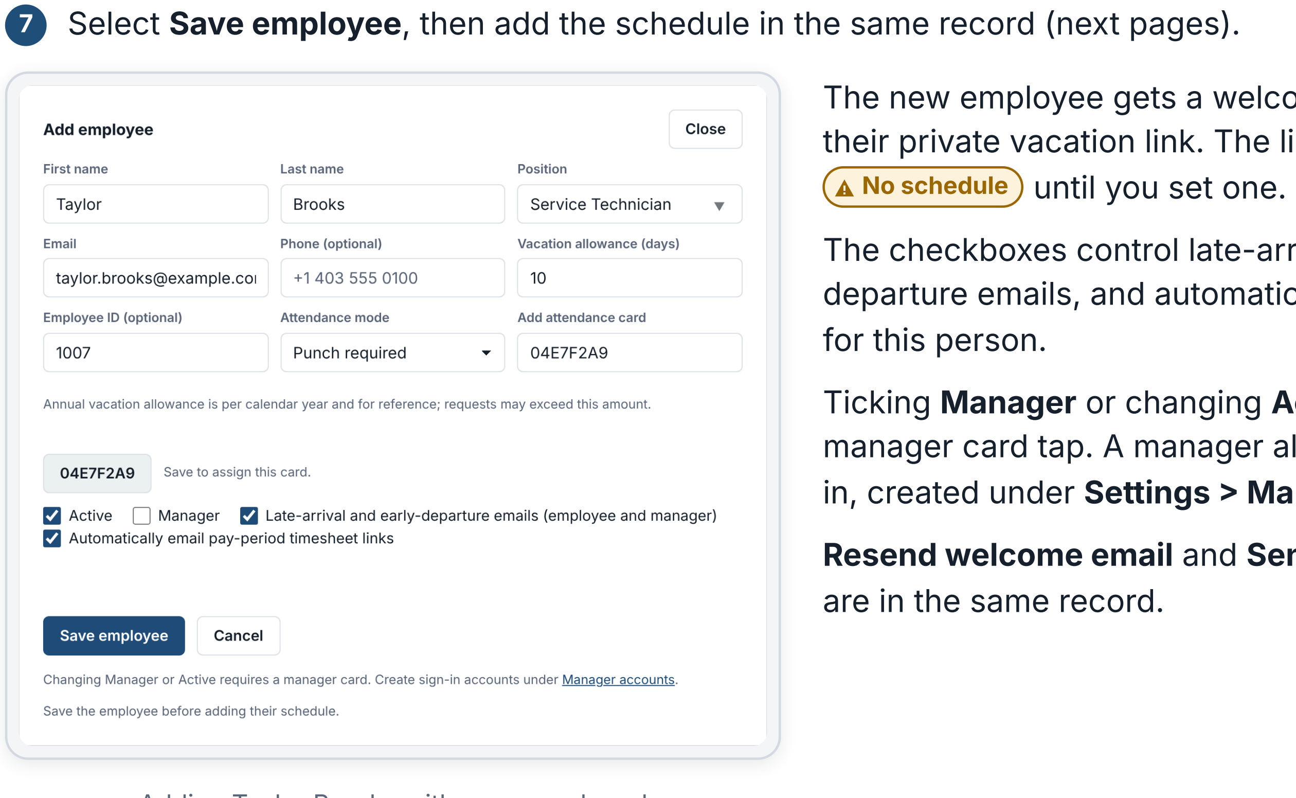
[picture p68: figure]
No schedule until you set one.; for this person.; are in the same record.

Adding Taylor Brooks with a scanned card

The new employee gets a welcome email with their private vacation link. The list flags

The checkboxes control late-arrival and early-departure emails, and automatic timesheet links,

Ticking Manager or changing Active needs a manager card tap. A manager also needs a sign-in, created under Settings > Manager accounts.

Resend welcome email and Send vacation link

1 | Go to Employees and select Add employee.
| Enter first name, last name, position and email. The email is used for welcome, timesheet, late- arrival, early-departure and vacation messages.
2

Optional: enter your company's Employee ID. Leading zeros and letters are kept. It appears on payroll reports, emails and vacation lists. If you leave it blank, the clock's own number is used. Two people can't share an ID.

3

Optional: enter a Vacation allowance (days) in whole or half days. Blank means unspecified and zero means zero. It's for reference only and doesn't limit requests.

4

Choose the Attendance mode. Punch required is normal. Vacation only is for staff who track vacation but don't tap in.

5

Select Scan card (30 seconds) and tap the new card on any clock. The card number appears on the button. You can also type a number from Unknown cards into Add attendance card.

6

7 Select Save employee, then add the schedule in the same record (next pages).

C H A PTER 2 , C O N TI N U E D

# Finding people and replacing cards

### Finding someone

Type in Search by name above the list. It matches first or last names and includes inactive employees. Select a row to open that person's record. Flags in the Status column show what's missing, such as

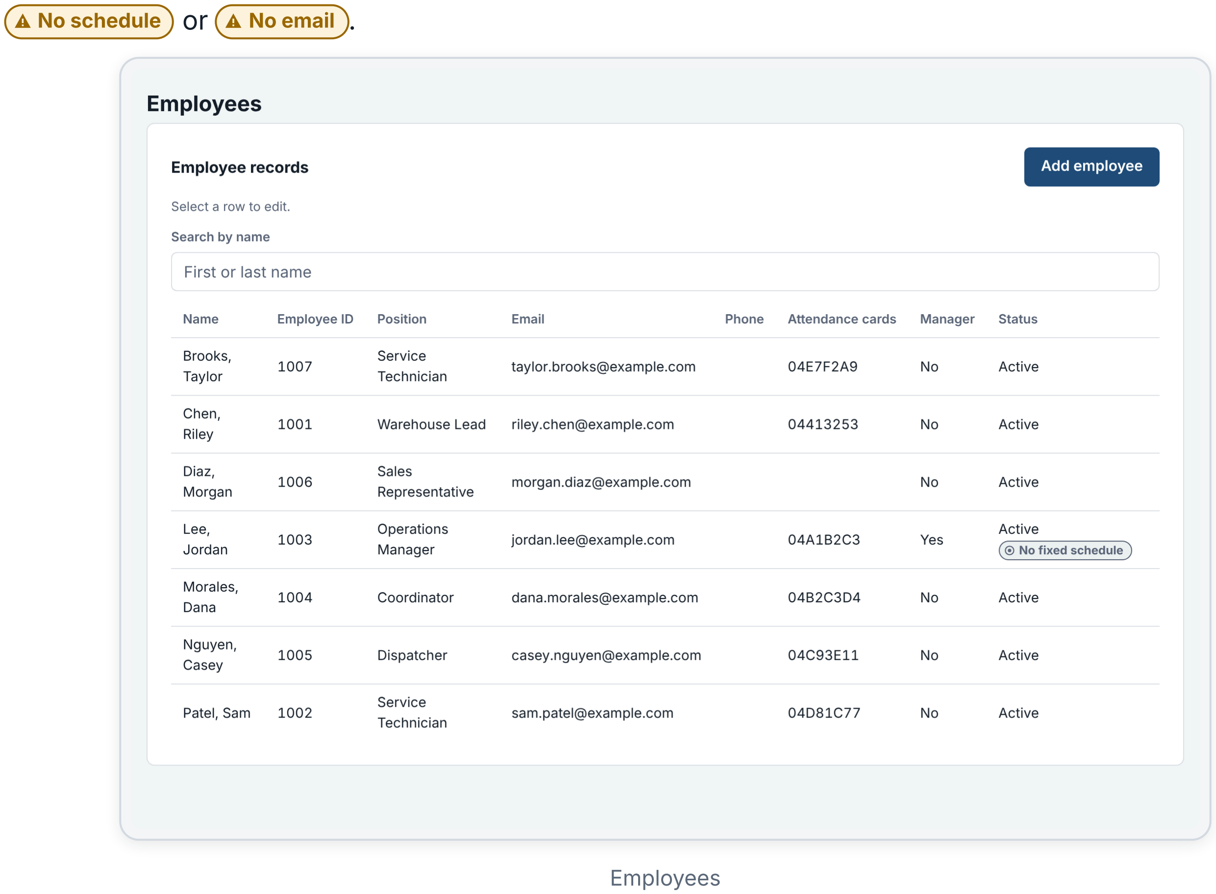
[picture p69: figure]
No schedule or; No email .; Employees
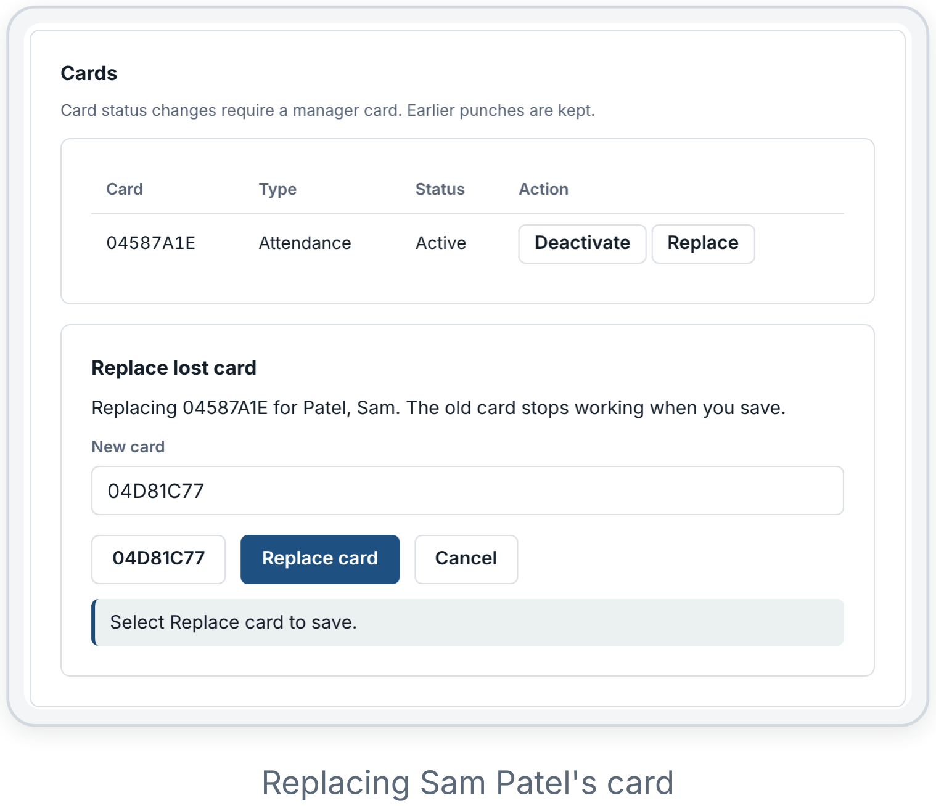
[picture p70: figure]
Replacing Sam Patel's card

### Lost or damaged cards

Open the employee and find Cards.

The page says Card replaced. The old card no longer works. Past punches are kept and the change is in the audit log. No manager card tap is needed.

Deactivate stops a card without giving a new one, for example when someone leaves. Reactivate brings a card back. Both need a manager card tap.

1 | Select Replace next to the old card.
| Select Scan new card (30 seconds) and tap the new card on a clock.
2

3 Select Replace card and confirm.

C H A PTER 2 , C O N TI N U E D

# Schedules and grace

A schedule tells the clock when each person is expected. It's used for late-arrival, early-departure and missing-punch notices, the Overview and the timesheet link timing. It doesn't change recorded hours or pay.

If the end time is earlier than the start, the shift ends the next day (overnight). Changes are logged, and punches already recorded aren't changed.

To go through several people in a row, use Settings > Bulk schedules. It's the same editor with an employee list.

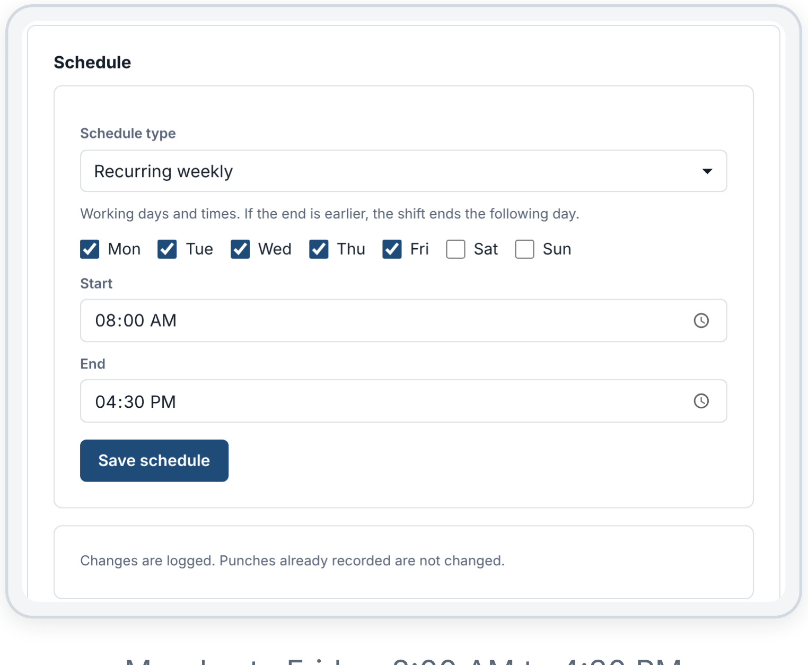
[picture p71: figure]

Monday to Friday, 8:00 AM to 4:30 PM

### Late grace and repeat taps

Under Settings > Late grace and repeat taps, each clock has two settings:

Grace (default 5 minutes, 0 to 60). It applies after the scheduled start and before the scheduled finish. With 5 minutes, an 8:00 start is late at 8:05:01, and a 4:30 PM finish is early at 4:24:59. Beyond grace, minutes count from the scheduled start or finish.
Repeat window (default 120 seconds, 0 to 300). A second tap inside this window is logged but doesn't count as a punch. The employee sees ALREADY RECORDED.

Changing the grace doesn't change punches already recorded.

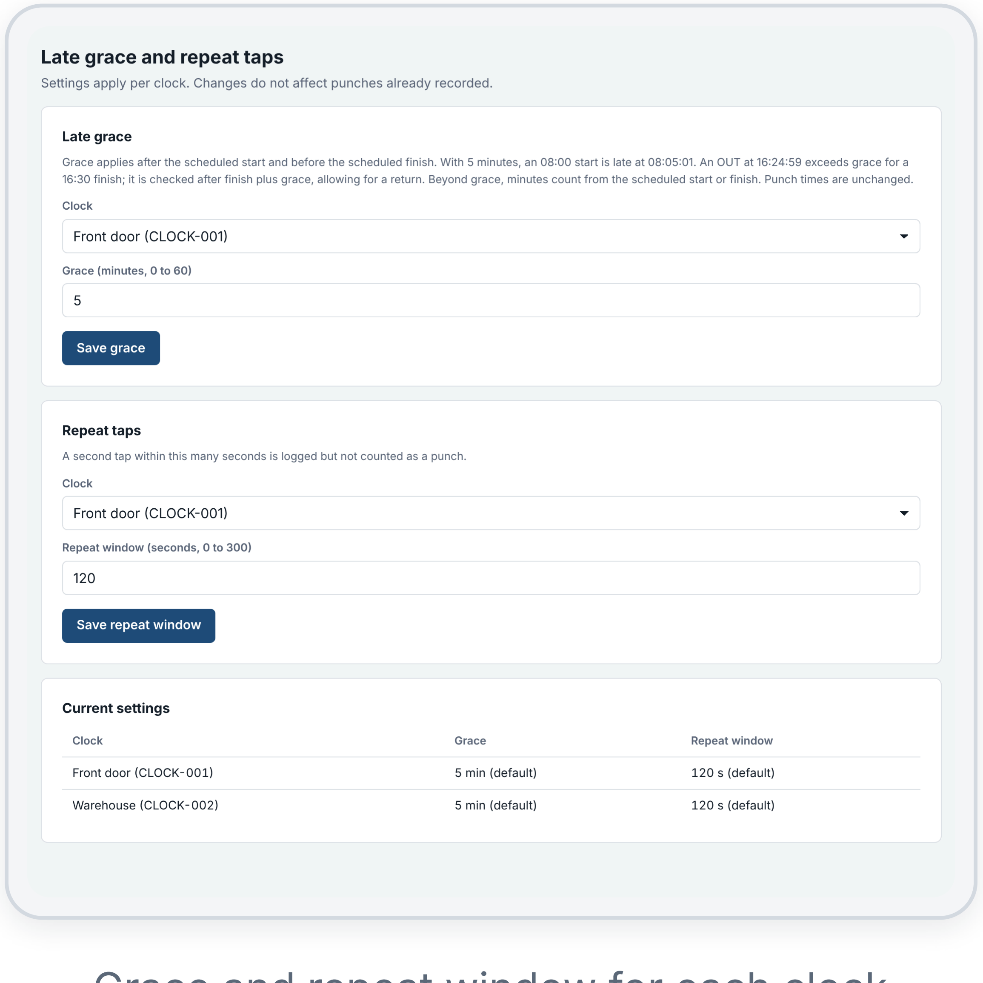
[picture p72: figure]

Grace and repeat window for each clock

1 Open the employee and find Schedule. Choose a Schedule type: Recurring weekly: tick the working days and set start and end times. Dated shifts: enter specific shifts by date, for rotating schedules. No fixed schedule: the person is never marked late or early and gets no missing-punch notices.

2

3 Select Save schedule.

# Fixing punches

When someone forgets to tap, taps at the wrong time or tells you about a problem, fix it on Attendance. The original swipe is always kept, and every correction is logged.

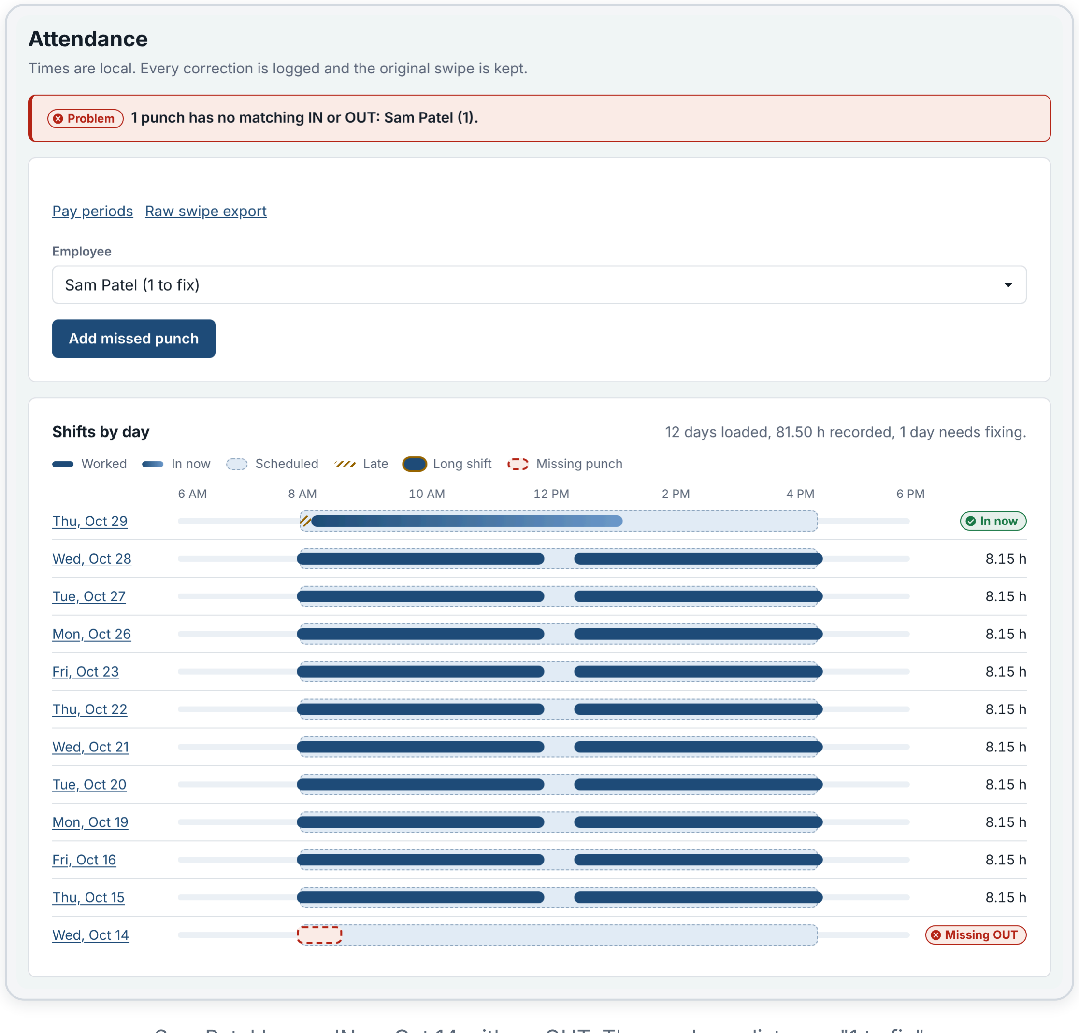
[picture p73: figure]

Sam Patel has an IN on Oct 14 with no OUT. The employee list says "1 to fix"

Find the problem
The red banner names everyone with an unmatched punch, and the Employee list shows how many each person has to fix. Shifts by day draws each day; a red dashed box and
Missing OUT mark the day to fix. In the Punches
table, rows flagged | No OUT or | No IN are the
ones to fix.

Attendance shows recent punches. The line above the chart says how many days are loaded. Older periods are in the reports under Pay periods.

Ways to correct
Add missed punch: adds an IN or OUT the person forgot.
Change: moves a punch to the correct time or direction.
Void: removes a punch from the hours, such as an accidental tap.
Manager note: on a late or early punch, records why it was approved (later in this chapter).

Every correction needs a reason of at least 5 characters and asks you to confirm.

C H A PTER 3, C O N TI N U E D

# Adding a missed punch

The added punch shows Added by manager and the source Manager, and the employee is emailed that their recorded hours were corrected. The employee sees your reason on their timesheet, so keep it factual.

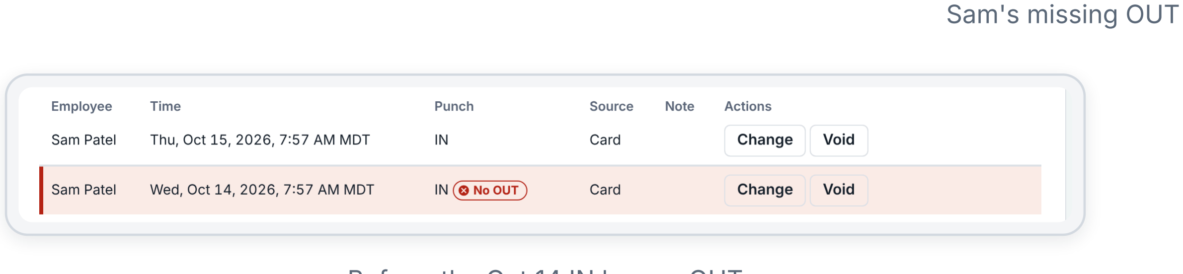
[picture p74: figure]
Sam's missing OUT

Before: the Oct 14 IN has no OUT

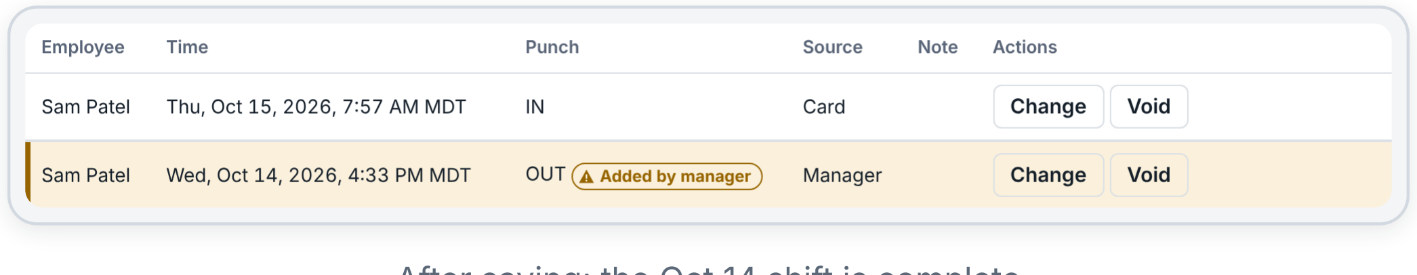
[picture p75: figure]

After saving: the Oct 14 shift is complete

Closed periods can still be corrected. The employee's review then shows | Changed since review and the
period shows | New export required . Review the employee again and create a new export revision (Chapter

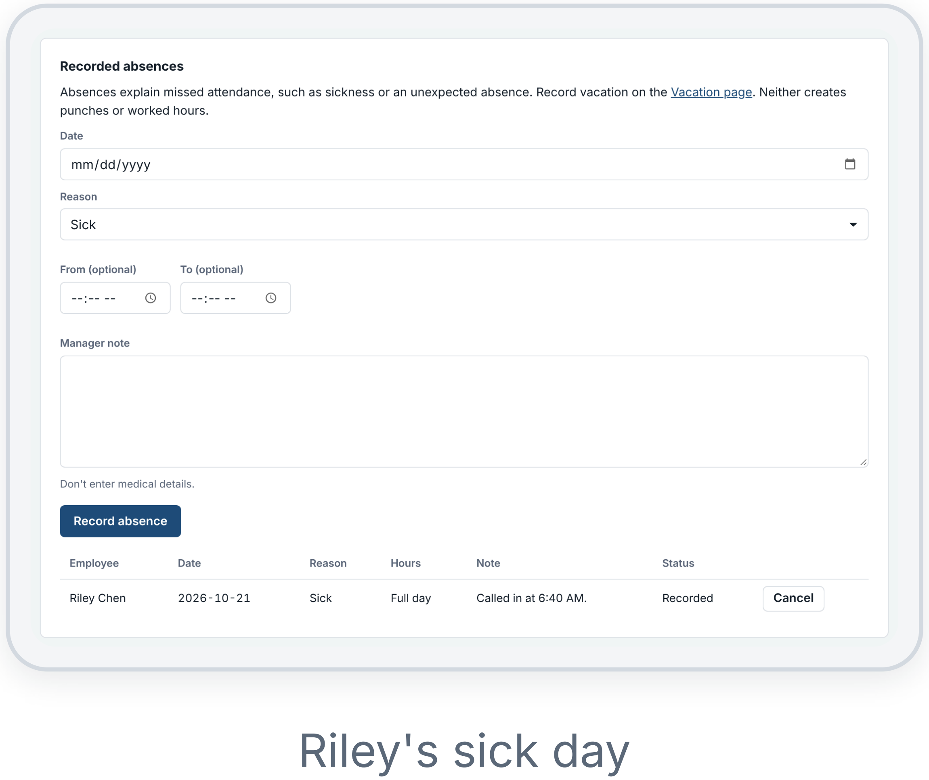
[picture p76: figure]
Riley's sick day

### Recorded absences

At the bottom of Attendance, Recorded absences explains a missed day (sick, medical appointment, personal day, family emergency, bereavement, unpaid leave, unexcused, other) without creating punches or paid hours. Leave From and To empty for a full day. Absences appear on the employee's timesheet. An excused absence also stops late and early flags for the time it covers.

Record vacation on the Vacation page instead (Chapter 4). Don't enter medical details in the note.

1 | Choose the employee and select Add missed punch.
2 | Enter the local date and time, and the direction (IN or OUT).
3 | Enter a reason, for example who confirmed the time.
4 | Select Save correction and confirm.

C H A PTER 3, C O N TI N U E D

# Late and early

The clock flags late arrivals and early departures against each person's schedule and the clock's grace (Chapter 2). Flags never change punch times or hours.

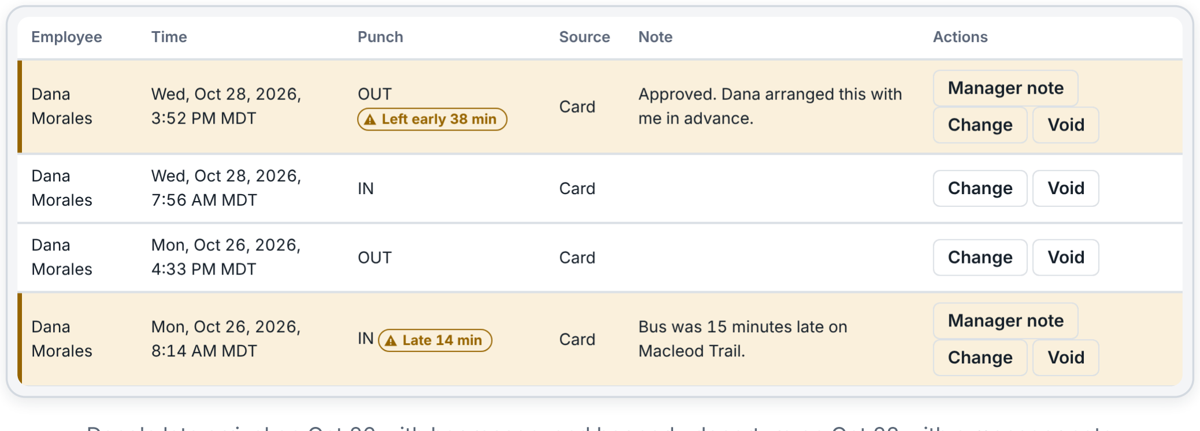
[picture p77: figure]

Dana's late arrival on Oct 26 with her reason, and her early departure on Oct 28 with a manager note

Late arrival
Only the first tap in for a shift can be late. Returning from lunch is never late. The clock shows LATE, and the employee and every active manager are emailed straight away.

Early departure
Checked shortly after the scheduled finish plus grace. If the employee tapped back in before then, the earlier tap out was a break and isn't flagged. A real early departure gets Left early 38 min and the same two emails. For an overnight shift, the finish is the next morning.

Missing punches
If no IN arrives after the scheduled start plus grace, or no OUT after the finish plus grace, the employee is emailed a No IN or No OUT notice.

Reasons and manager notes
The employee's email has a private link where they can give a reason; it appears in the Note column. To record your own explanation, select Manager note on the flagged punch, enter the note and select Save note. The Note column then shows your note. Every version is kept under Note revisions in the audit log, and the note appears in

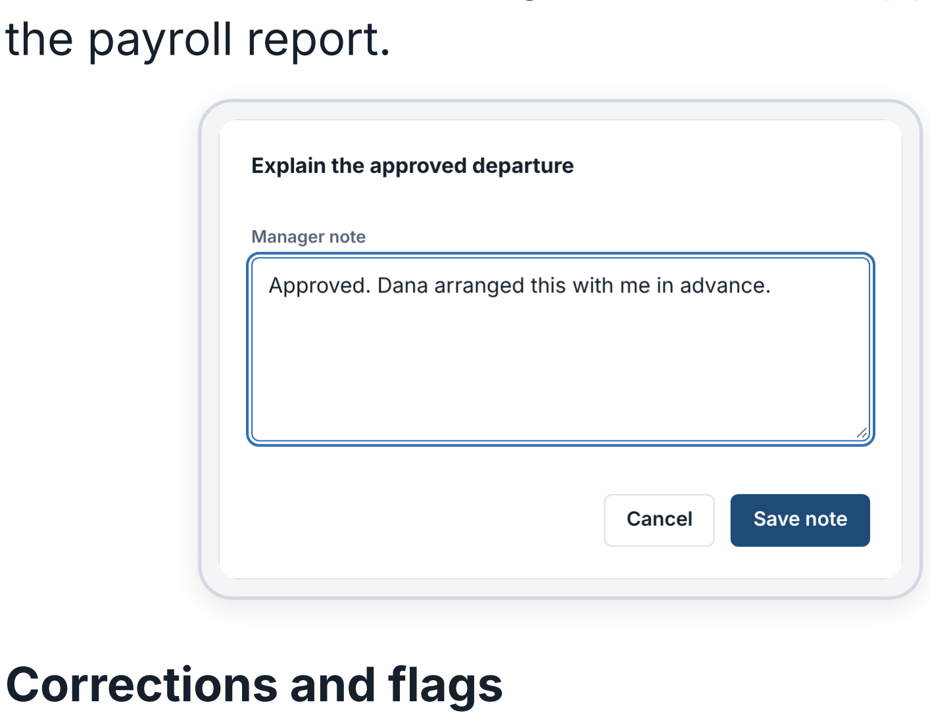
[picture p78: figure]
the payroll report.; Corrections and flags

Changing or adding an IN recalculates its lateness. Changing or adding an OUT recalculates the early departure, after the shift's finish if you correct it during the day. Corrections don't send new late or early emails. No flags on approved full-day vacation, excused absences, or days without a schedule. Untick the employee's late-arrival and early-departure emails to keep the flags but stop the emails.

# Vacation

Employees request vacation from their own private page. Requests appear on Vacation under Waiting for approval, and you also get an email.

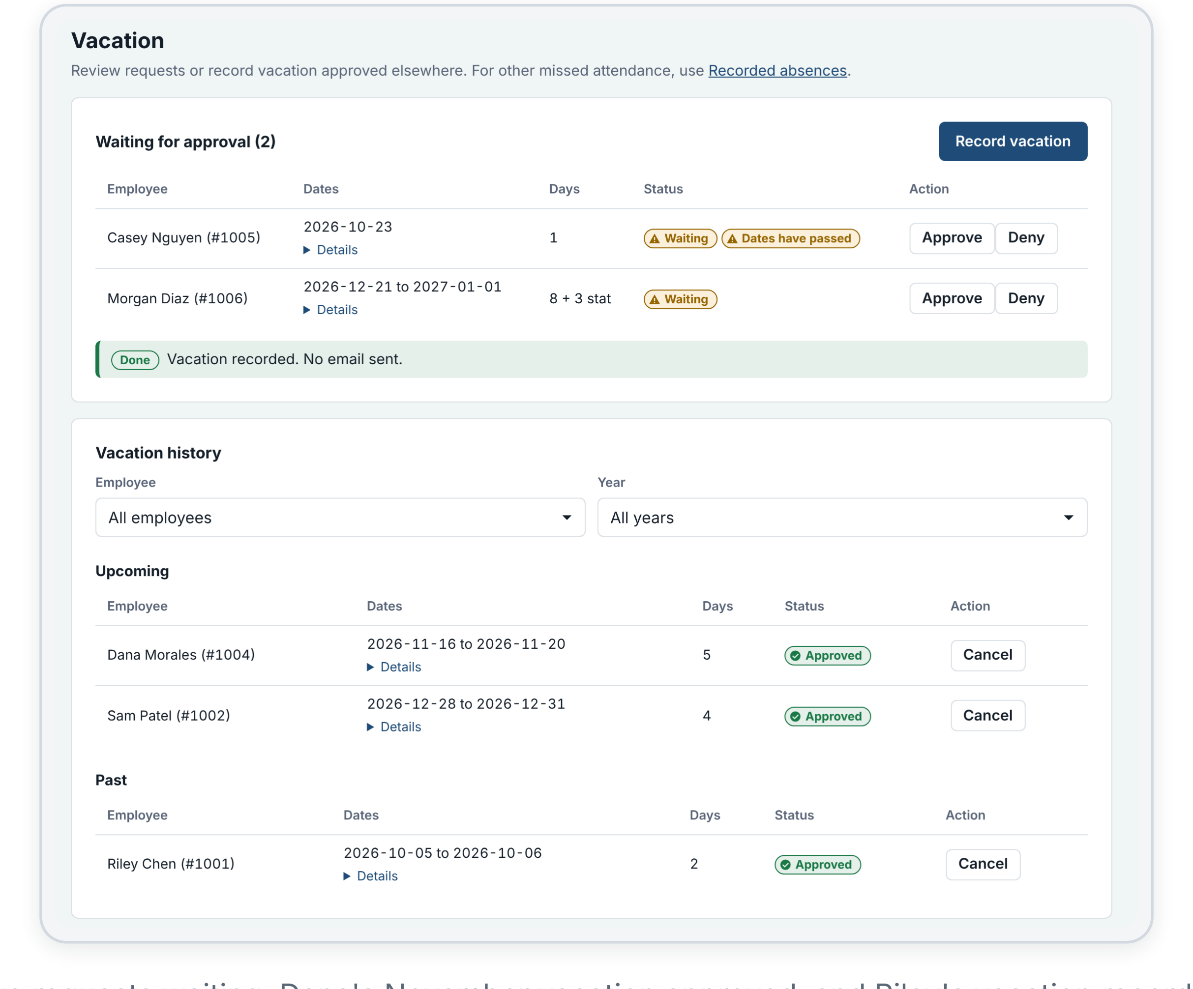
[picture p79: figure]

Two requests waiting, Dana's November vacation approved, and Riley's vacation recorded
Dates have passed marks a request still waiting after its last day. Nothing expires on its own; approve or deny it.

Days show stat holidays separately, for example 8 + 3 stat. Stat holidays aren't counted as vacation. Cancel withdraws an approval you already gave. The employee is emailed and told to contact you about their schedule.

Vacation history is split into Upcoming and Past, with Employee and Year filters. Long lists have Previous and Next pages.

Annual vacation report: choose a year and select Download Excel-compatible CSV. It starts with one summary row per employee (allowance, approved days, remaining days), then each booking with a running balance. Future approved bookings count; pending and denied requests don't.

Approved vacation appears on the timesheet and in the payroll report. It doesn't add hours. Allowances are for reference; there's no accrual and no limit.

Read the dates and number of days. Open Details for the return date, the employee's notes and any stat holidays inside the request.

1

Select Approve or Deny. A box asks for a manager note (optional). The employee sees the note in their email.

2

The page shows Done Decision saved., the request moves to Vacation history, and the employee is emailed.

3

C H A PTER 4, C O N TI N U E D

# Recording vacation

When vacation was approved by phone or email, or before the clock was installed, record it yourself.

It's saved as Approved and audited under your name. The page says Vacation recorded. No email sent.

Vacation only
The Vacation page is for vacation. Record sick days and other missed attendance under Recorded absences (Chapter 3).

Vacation recorded or cancelled inside a closed period marks that period
New export required (Chapter 5).

Recording Riley's vacation, approved by phone

### Stat holidays in a request

The Details of a request name each stat holiday inside it, even one that falls on a weekend. Changing a holiday or a schedule later updates the current count. The originally requested count is kept, and Details

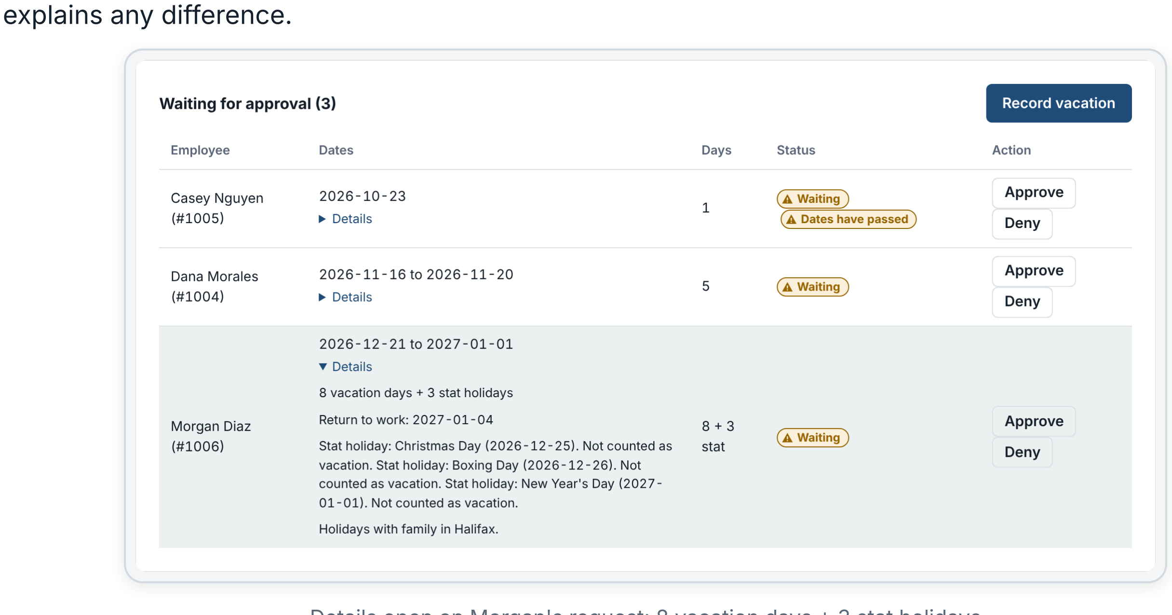
[picture p80: figure]
explains any difference.

Details open on Morgan's request: 8 vacation days + 3 stat holidays

1 | Select Record vacation.
| Choose the employee and the starting and ending dates. Inactive employees can be chosen for past dates. For one day, the ending date fills in for you.
2

Check the calculated days, for example 2 vacation days, and the suggested return date. Leave the return date blank to use the suggestion.

3

4 Add a note if you want, then select Record vacation.

# Pay periods

Each pay period closes on its own when it ends. Your job is to fix problems, review each employee, and save the report that goes to payroll.

STEP | WHERE | WHAT HAPPENS
1. The period closes | Automatic | The day after it ends, the period closes as an attendance snapshot. Closing doesn't mark anyone reviewed.
2. Timesheet links go out | Automatic | Each employee is emailed a private, read-only link to their timesheet (Chapter 7), and payroll gets a summary.
3. Fix problems | Attendance | Add missing punches and fix anything employees tell you about.
4. Review | Pay periods > Review | Select Mark reviewed for each employee once their hours are right.
5. Save the report | Pay periods | Select Create export / revision. The revision is saved and never changes.
6. Report to payroll | Automatic, or Send | The payroll report is emailed before payday at the set time

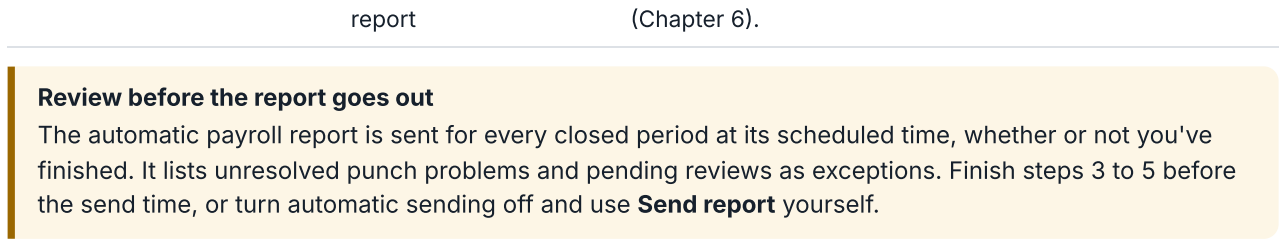
[picture p81: figure]
report; (Chapter 6).; Review before the report goes out

The automatic payroll report is sent for every closed period at its scheduled time, whether or not you've finished. It lists unresolved punch problems and pending reviews as exceptions. Finish steps 3 to 5 before the send time, or turn automatic sending off and use Send report yourself.

### Employees don't approve their timesheets

Timesheet links are read only. They say Contact your manager if there is an issue. There's no employee approval, and no manager override. Only managers correct and review attendance.

### Pay schedule

Periods are created automatically. Set the frequency (twice monthly, every two weeks, weekly or monthly) under Pay periods > Attendance period schedule, then Save pay schedule. Closed and reviewed periods are kept. A shift that crosses midnight counts in the pay period of its IN date.

### Closing early

To close an open period before it ends, select Review on it, then Close period. Any problems are listed as Exceptions to report ; closing doesn't mark them reviewed.

C H A PTER 5, C O N TI N U E D

# Reviewing a period

Go to Pay periods. A closed period that still needs work shows red flags, and the Attention column says

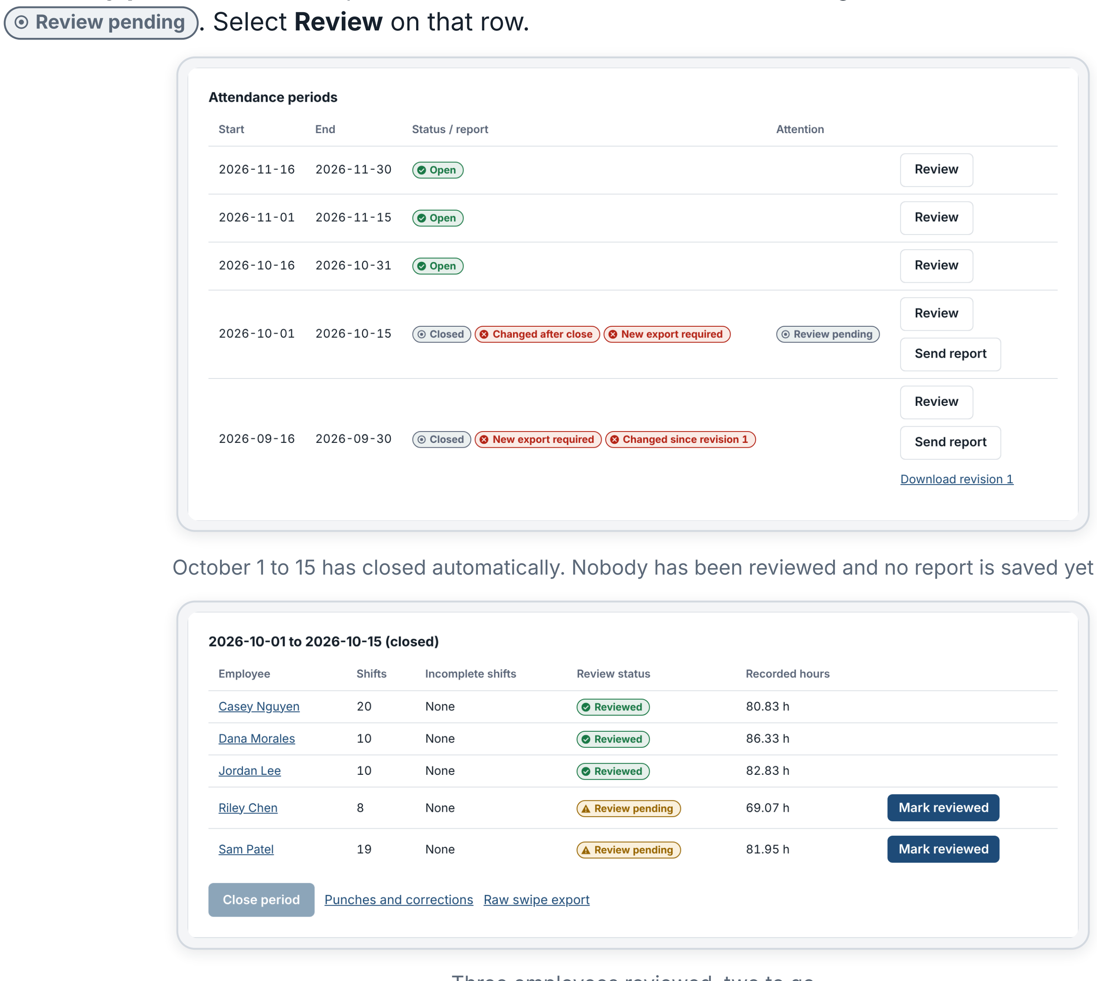
[picture p82: figure]

Review pending . Select Review on that row.

October 1 to 15 has closed automatically. Nobody has been reviewed and no report is saved yet

Three employees reviewed, two to go

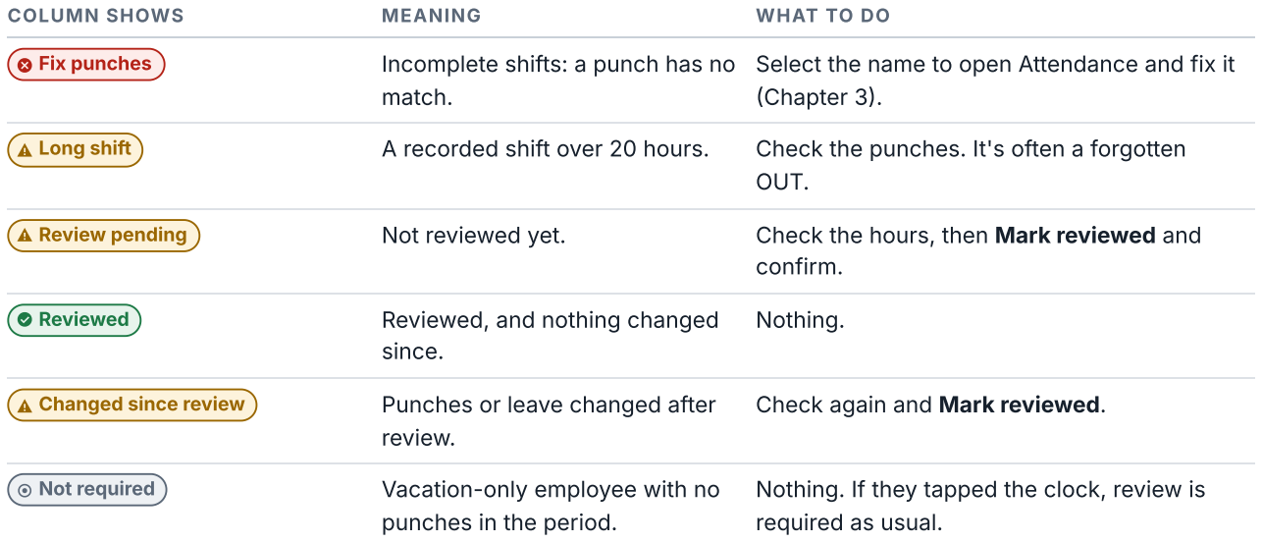
[picture p83: figure]
COLUMN SHOWS; MEANING; WHAT TO DO; match.; (Chapter 3).; OUT.; confirm.; Reviewed; Reviewed, and nothing changed; since.; Nothing.; Changed since review; Punches or leave changed after; review.; Check again and Mark reviewed.; Not required; Vacation-only employee with no; punches in the period.; required as usual.

Fix punches | Incomplete shifts: a punch has no | Select the name to open Attendance and fix it
Long shift | A recorded shift over 20 hours. | Check the punches. It's often a forgotten
Review pending | Not reviewed yet. | Check the hours, then Mark reviewed and

Nothing. If they tapped the clock, review is

C H A PTER 5, C O N TI N U E D

# Saving the report

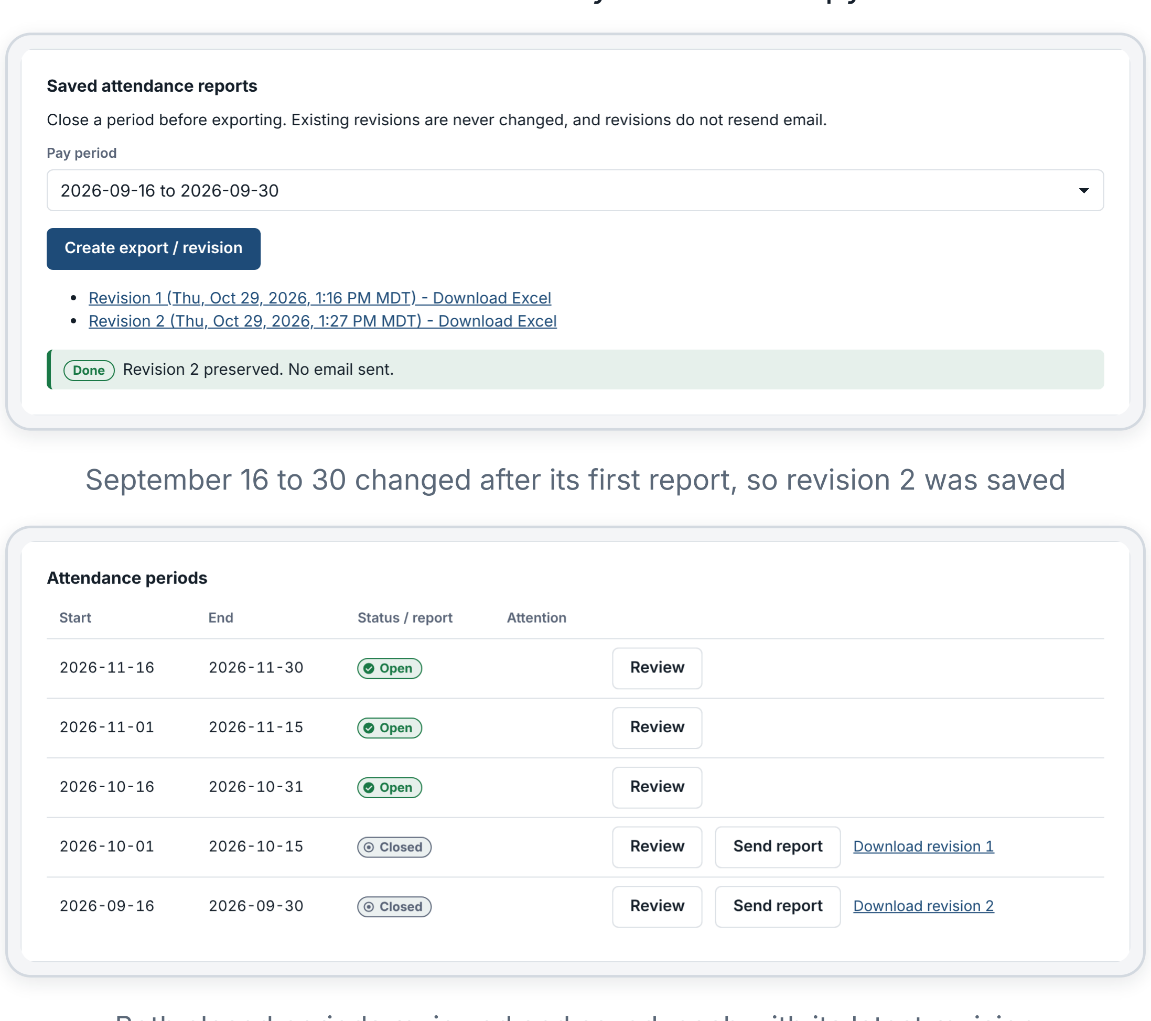
[picture p84: figure]

September 16 to 30 changed after its first report, so revision 2 was saved

Both closed periods reviewed and saved, each with its latest revision

Closing pending | The period ended with attendance but hasn't closed yet. It closes on the
Closed with no other flag | Reviewed, and the latest revision matches the records.
Changed after close | A review is pending, or something changed after an employee was
New export required | There's no saved revision, or the records no longer match it. Create the next revision.
Changed since revision 1 | The records changed after that revision was saved, for example a late upload, a correction, or vacation approved later in the year.
Report not queued | The payroll email couldn't be prepared. The reason is shown beside it.

The Excel workbook has two tabs. Payroll Summary shows hours, leave, exceptions and annual vacation used for each employee. Daily Detail has one row per punch or record, with any reason or manager note. Saved revisions never change.

The timeclock reports recorded attendance. It doesn't deduct breaks or calculate pay or overtime.

1 | Under Saved attendance reports, choose the pay period.
2 | Select Create export / revision. The page says, for example, Revision 1 preserved. No email sent.
3 | The period's row now has Download revision 1 if you need a copy.

# The payroll report

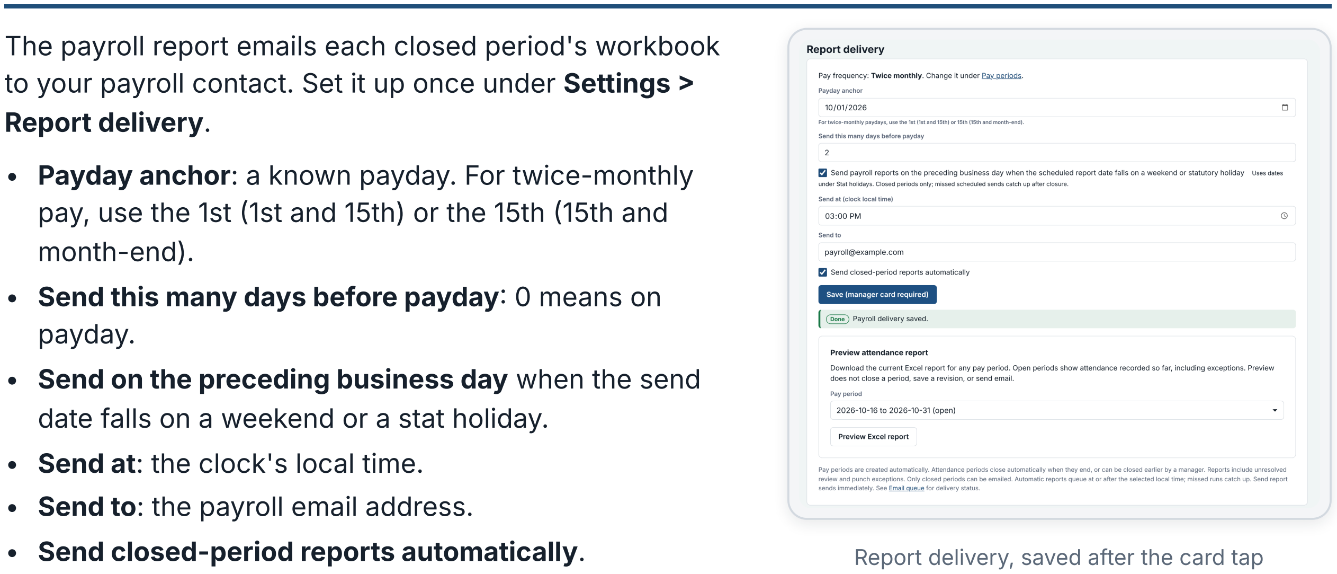
[picture p85: figure]
Report delivery.; month-end).; payday.; Send at: the clock's local time. Send to: the payroll email address.; Send closed-period reports automatically.

The payroll report emails each closed period's workbook to your payroll contact. Set it up once under Settings >

Payday anchor: a known payday. For twice-monthly pay, use the 1st (1st and 15th) or the 15th (15th and

Send this many days before payday: 0 means on

Send on the preceding business day when the send date falls on a weekend or a stat holiday.

Select Save (manager card required) and tap your manager card.

Only closed periods are sent
If a report's send time passes before its period closes, it goes out on the next check after closing. To send one straight away, select Send report on a closed period under Pay periods. A new revision doesn't send a new email by itself; select Send report to send it.

### Preview attendance report

On the same page, choose any period and select Preview Excel report. Open periods show what's recorded so far. A preview doesn't close the period, save a revision or send email.

The pay frequency is shown at the top and is changed under Pay periods (Chapter 5). Delivery status is in Settings > Email queue.

Report delivery, saved after the card tap

# Employee emails and links

Settings > Employee emails and links controls the daily snapshot and the pay-period timesheet links.

### Daily attendance emails NEW

Tick Email a daily attendance snapshot, choose a send time (default 7:00 PM) and select Save daily emails. It's off by default. Each employee with punches that day gets one email with their IN and OUT times, completed hours and their timesheet link. A shift still running says Still clocked in. Choose a time after your workplace closes.

### Pay-period timesheet emails

When to send has two choices:

After the period ends: the set number of days after the period ends, at the set time.
On each employee's last scheduled day: the set number of hours before their final scheduled shift ends. People with no scheduled day in the period, and vacation-only staff, get theirs after the period ends.

Select Save settings. This period shows when each person's link will go out and its status.

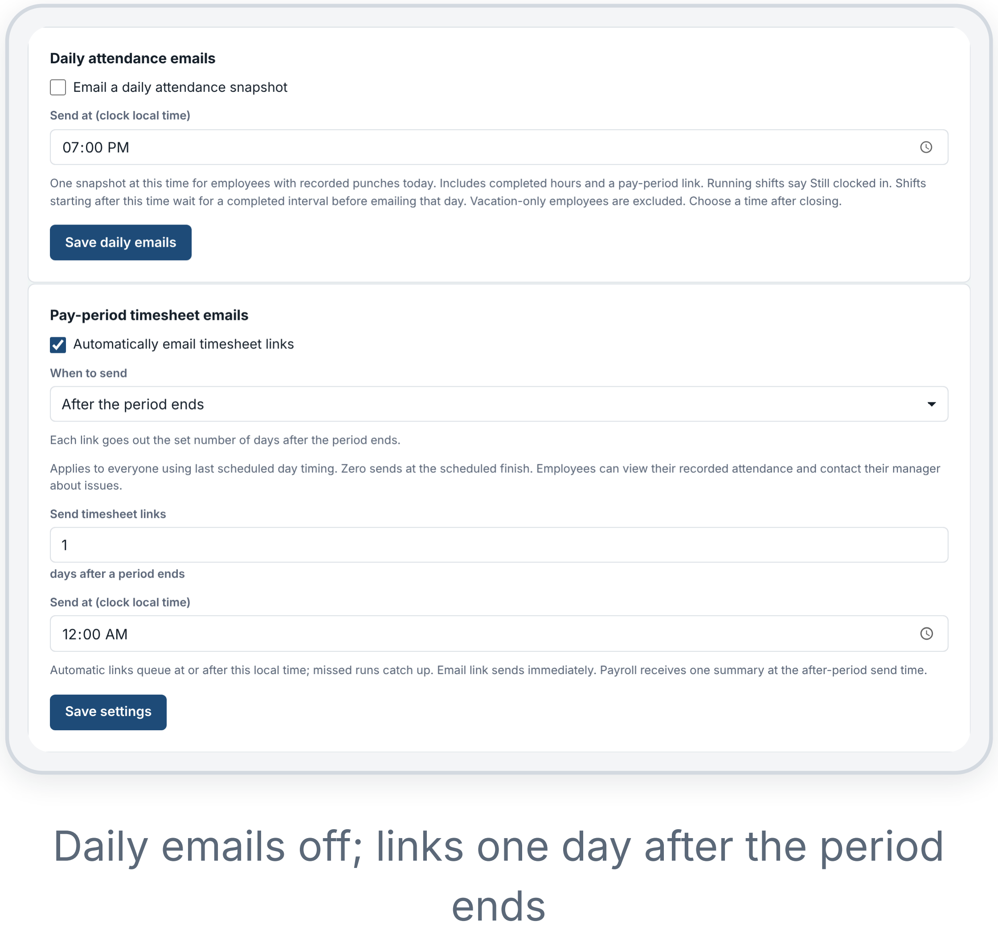
[picture p86: figure]
ends

Daily emails off; links one day after the period

### Sending a link yourself

Below the table, choose the employee and the pay period.
Copy link shows the link so you can copy it. Email link emails it straight away.
Revoke link stops the link working. The next Copy or Email creates a new one.

Copy and Email reuse the same link. Links last 14 days from issue, and a newly queued period email extends that. Anyone with the link can view the timesheet, so send it only to the employee.

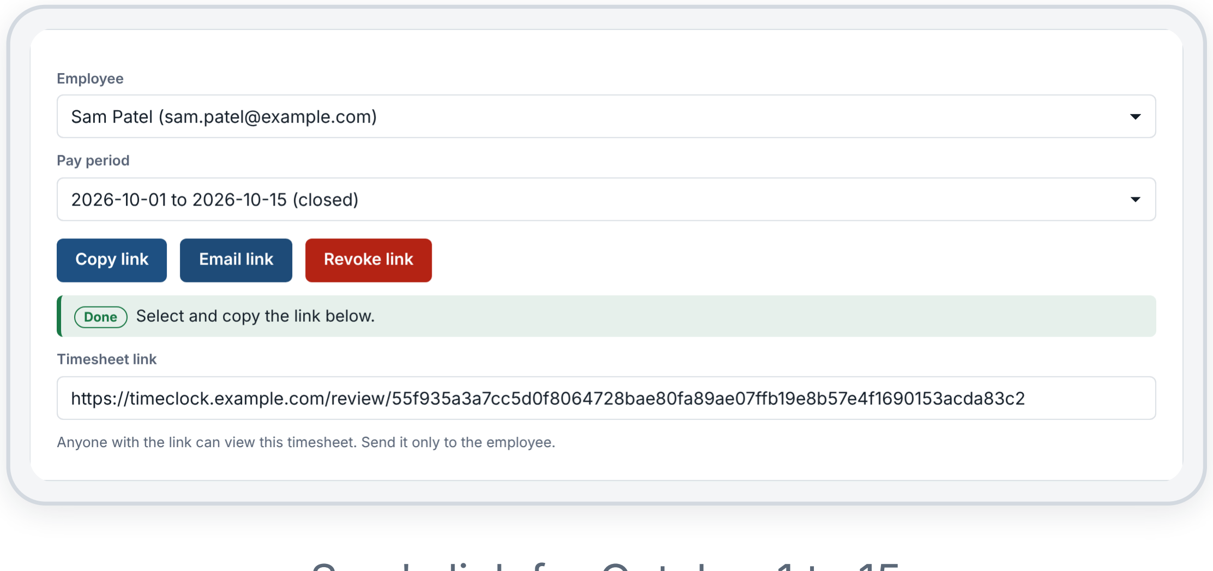
[picture p87: figure]

Sam's link for October 1 to 15

C H A PTER 7, C O N TI N U E D

# What employees see

The timesheet link opens a read-only page on the employee's phone or computer. It shows the hours recorded for the period, each shift with its times, and any late, missing-punch, holiday, vacation or absence entries.
There is nothing for the employee to approve. If something is wrong, they contact you, and you correct it on Attendance. The same link then shows the corrected record.
A link stays readable after the period closes, until it expires or you revoke it.

### Who gets what

EMAIL | GOES TO
Welcome, with vacation link | New employee
Late arrival, early departure | Employee and every active manager
No IN, no OUT | Employee
Recorded hours corrected | Employee
Daily snapshot, timesheet link | Employee
Vacation request received | Employee and managers
Vacation decision or cancellation | Employee
Clock not reporting, reconnected | Every active manager
Payroll report, links queued, delivery failure | Payroll address

Sam's timesheet link on a phone

# Email

### Settings > Email queue

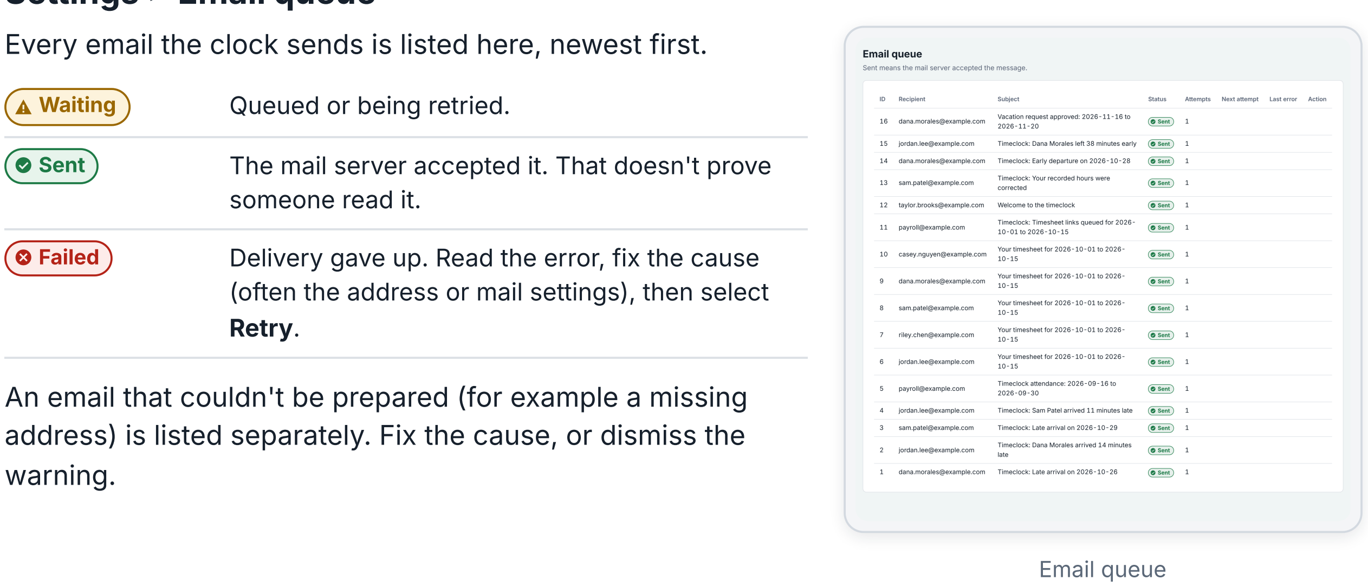
[picture p88: figure]
Waiting; Queued or being retried.; someone read it.; Retry.; warning.; Email queue

Every email the clock sends is listed here, newest first.

Sent | The mail server accepted it. That doesn't prove
Failed | Delivery gave up. Read the error, fix the cause (often the address or mail settings), then select

An email that couldn't be prepared (for example a missing address) is listed separately. Fix the cause, or dismiss the

### Settings > Email templates

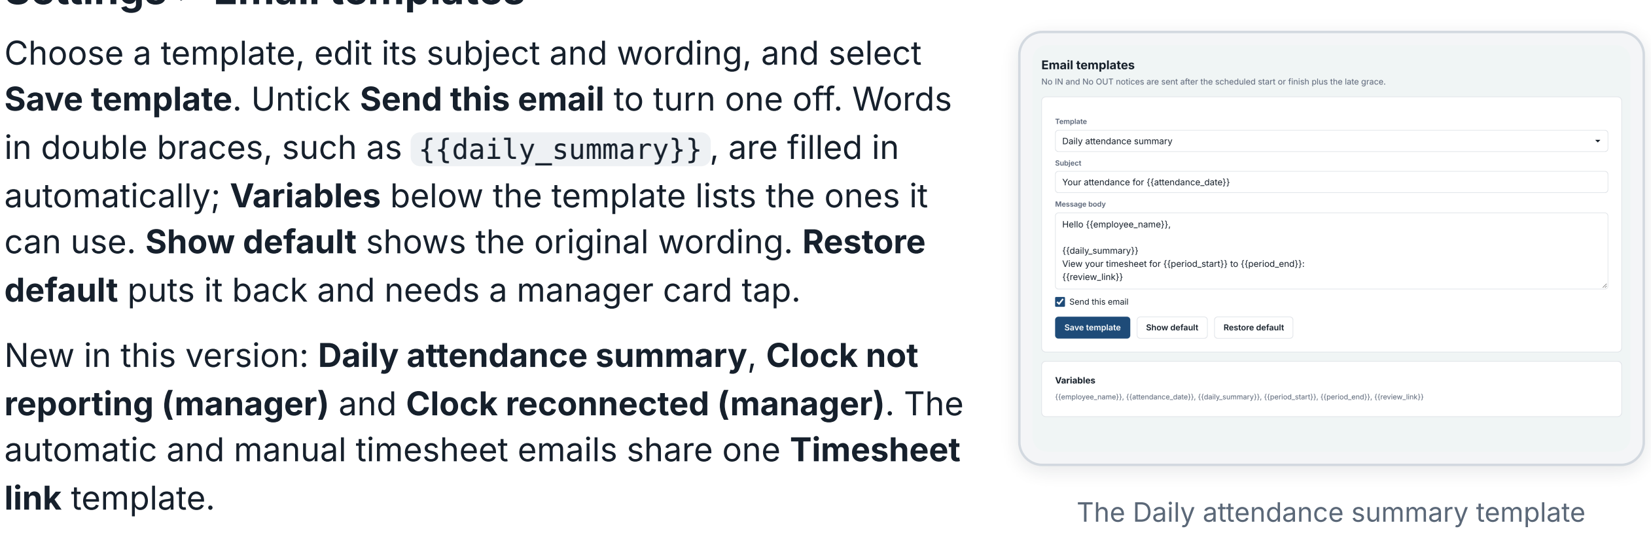
[picture p89: figure]
link template.; The Daily attendance summary template

Choose a template, edit its subject and wording, and select Save template. Untick Send this email to turn one off. Words in double braces, such as {{daily_summary}} , are filled in automatically; Variables below the template lists the ones it can use. Show default shows the original wording. Restore default puts it back and needs a manager card tap.

New in this version: Daily attendance summary, Clock not reporting (manager) and Clock reconnected (manager). The automatic and manual timesheet emails share one Timesheet

### Settings > Outgoing email

The mail server, port, connection security (STARTTLS, SSL/TLS, or None for a trusted network only), sign-in, sender name and From address used for all messages. Use Send a test email after any change and check the Email queue.

# Other settings

PAGE | WHAT IT DOES
Settings > Stat holidays | Add holidays by date and name, or import a CSV (Date,Holiday), then select Save holidays. An import is only staged until you save. Holidays appear on timesheets and are left out when counting vacation days. Tick No late-arrival or early- departure emails on these dates if needed. Holidays don't change recorded hours.
Settings > Clock display | Brightness for each clock, with optional dimming on a schedule (default 7:00 PM to 7:00 AM). Select the Primary to set the Time format (12-hour or 24-hour) and font for every clock. A live preview of the clock's screen is on this page. Cards still work while dim.
Settings > Late grace and repeat taps | Grace and repeat-tap window for each clock (Chapter 2).
Settings > Bulk schedules | The schedule editor with an employee list, for updating several people (Chapter 2).
Pay periods > Attendance period schedule | Pay frequency (Chapter 5). Also linked from Settings.
Settings > Manager accounts | Create, reset, lock or unlock manager sign-ins (manager card required). Passwords need 12 or more characters. Change your own password here.
Settings > Manager cards | Register a manager card to your account (Start here).
Settings > Raw swipe export | Card swipes for one or all employees over a date range, as CSV or JSON, with correction status and the company Employee ID. Manager-added punches aren't included. Use the payroll workbook for payroll.

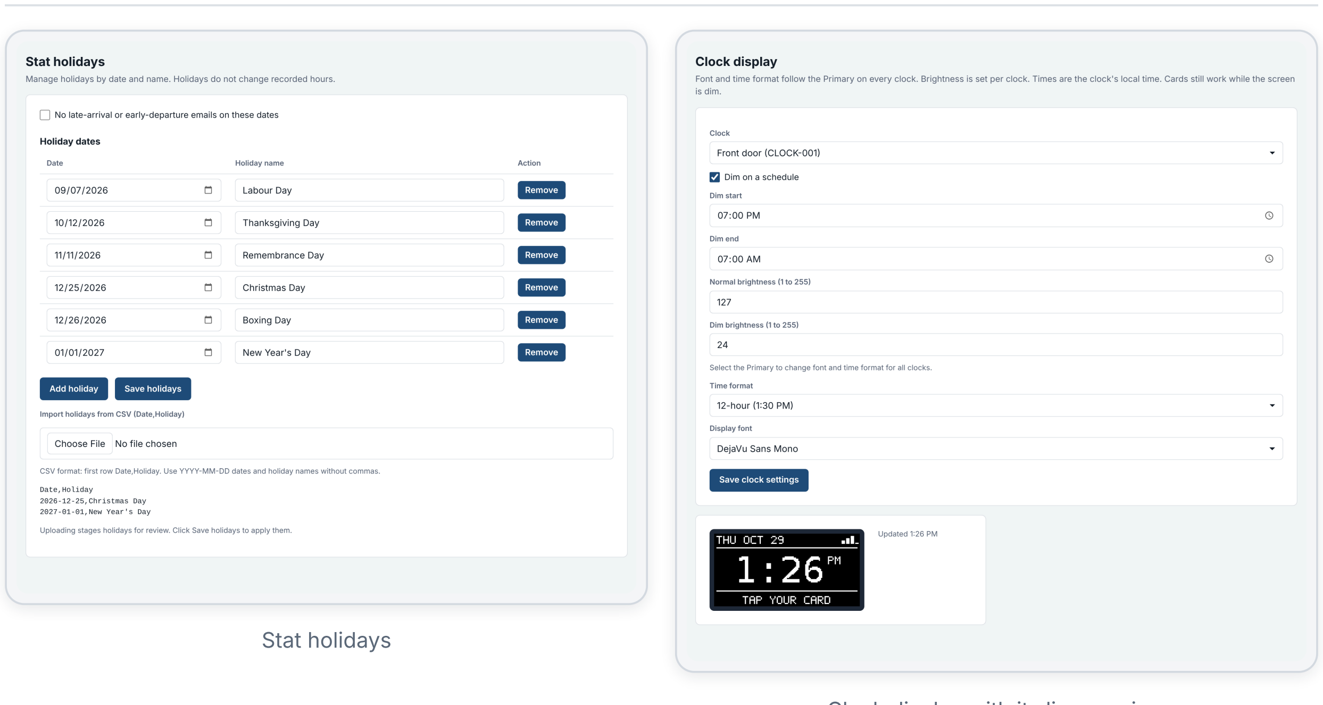
[picture p90: figure]
Stat holidays

Clock display with its live preview

# The clocks and their records

These pages are mostly for your IT contact, but it helps to know what they show.

### Settings > Clock management NEW IN RC6.1

Each clock with its name, ID, role, IP address, software Version and status. A Secondary reports its own address and version every 30 seconds; the page refreshes every 15 seconds, or select Refresh. An offline clock keeps the last address and version it reported. Not reported means the clock hasn't sent one: the Primary's own row always shows this, and so does a Secondary still running older software. Update the Primary and every Secondary together.

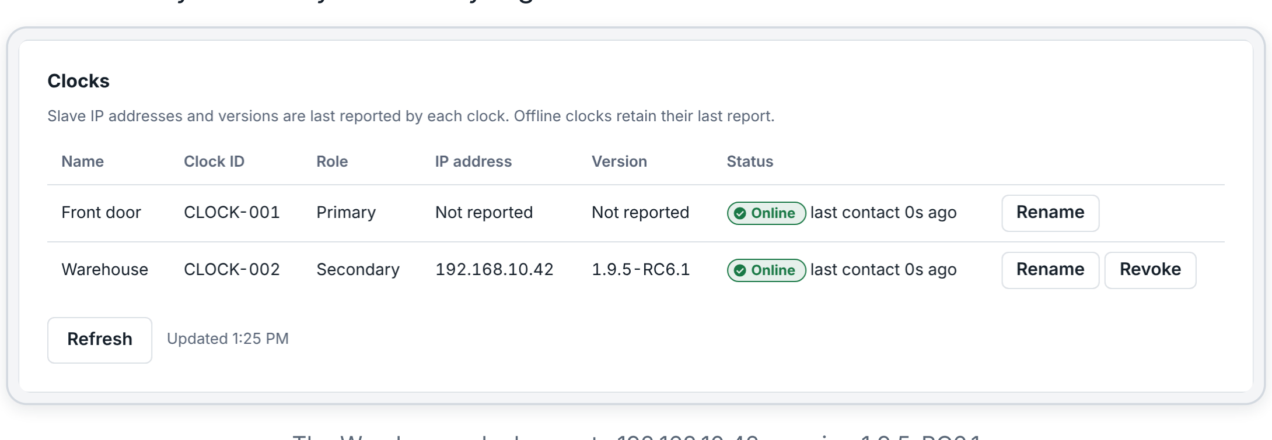
[picture p91: figure]

The Warehouse clock reports 192.168.10.42, running 1.9.5-RC6.1
Rename changes the name shown on every page and in emails. Revoke stops a Secondary from sending punches.
To add a Secondary, select Generate code, enter the code on the new clock's setup page within 10 minutes, then select Approve on its request under Waiting for approval.
If a clock stops reporting for 3 minutes, every active manager is emailed, and again when it reconnects. A Secondary that can't reach the Primary shows OFFLINE, keeps saving taps for cards it already knows, and chirps every five minutes. New cards can't be used while it's offline.

### Settings > System health

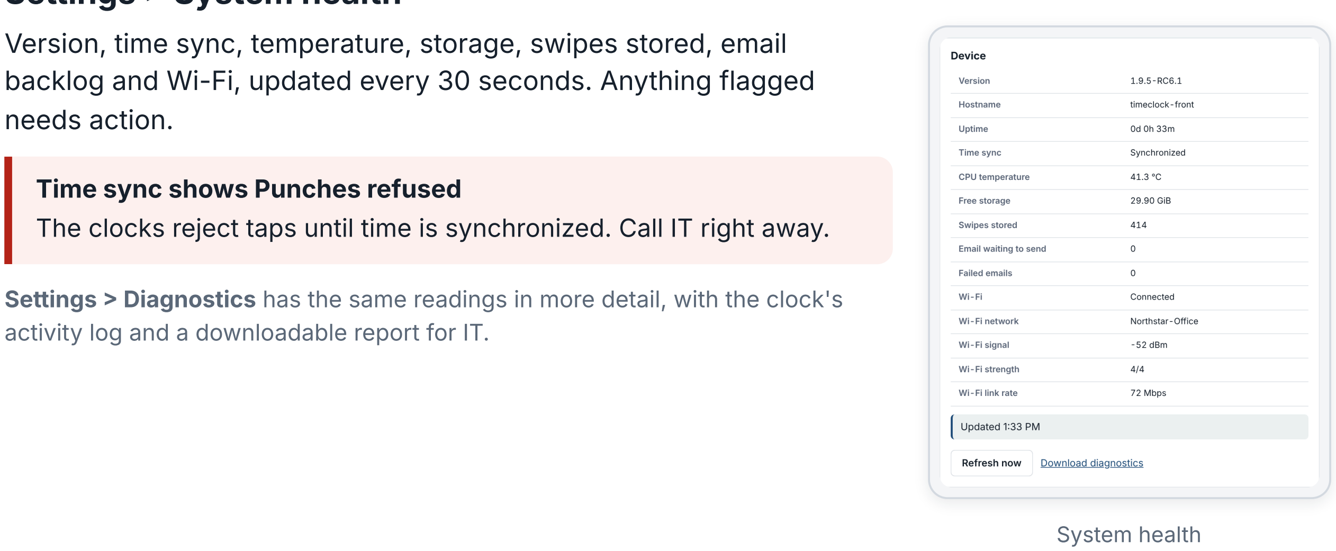
[picture p92: figure]
needs action.; Time sync shows Punches refused; System health

Version, time sync, temperature, storage, swipes stored, email
backlog and Wi-Fi, updated every 30 seconds. Anything flagged

The clocks reject taps until time is synchronized. Call IT right away.

Settings > Diagnostics has the same readings in more detail, with the clock's activity log and a downloadable report for IT.

C H A PTER 10, C O N TI N U E D

# Backups and the audit log

PAGE | WHAT TO KNOW
Settings > Backup and restore | The clock backs itself up every day at 02:15. Each clock keeps its own backups; there's no copying between clocks. You can email the daily backup to a manager (off by default), upload a backup file, or restore. Downloading needs a manager card tap and allows one download within 60 seconds. Restore needs you to type RESTORE and tap your card, and replaces everything recorded since that backup. Only do it with IT.
Settings > System operations | Restart the clock, shut it down, restart the timeclock services, or back up now. Each needs a manager card tap. The clock doesn't record punches until the action finishes.
Settings > Time sync and HTTPS certificate | Set by IT. Changing the time zone needs a manager card. The certificate's web address is the one used in employee email links.
Settings > Rejected uploads | Swipes a clock sent that the server refused, and out-of-order swipes kept for you to check. They don't count. Add a missed punch if one is needed.
Settings > Audit log | Who did what and when, in sections: vacation decisions, pay period reviews, absences, manager accounts, timesheet links, exports, backups, card replacements, email retries, employee and schedule edits, template restores, punch corrections and note revisions. The latest 50 of each are shown.

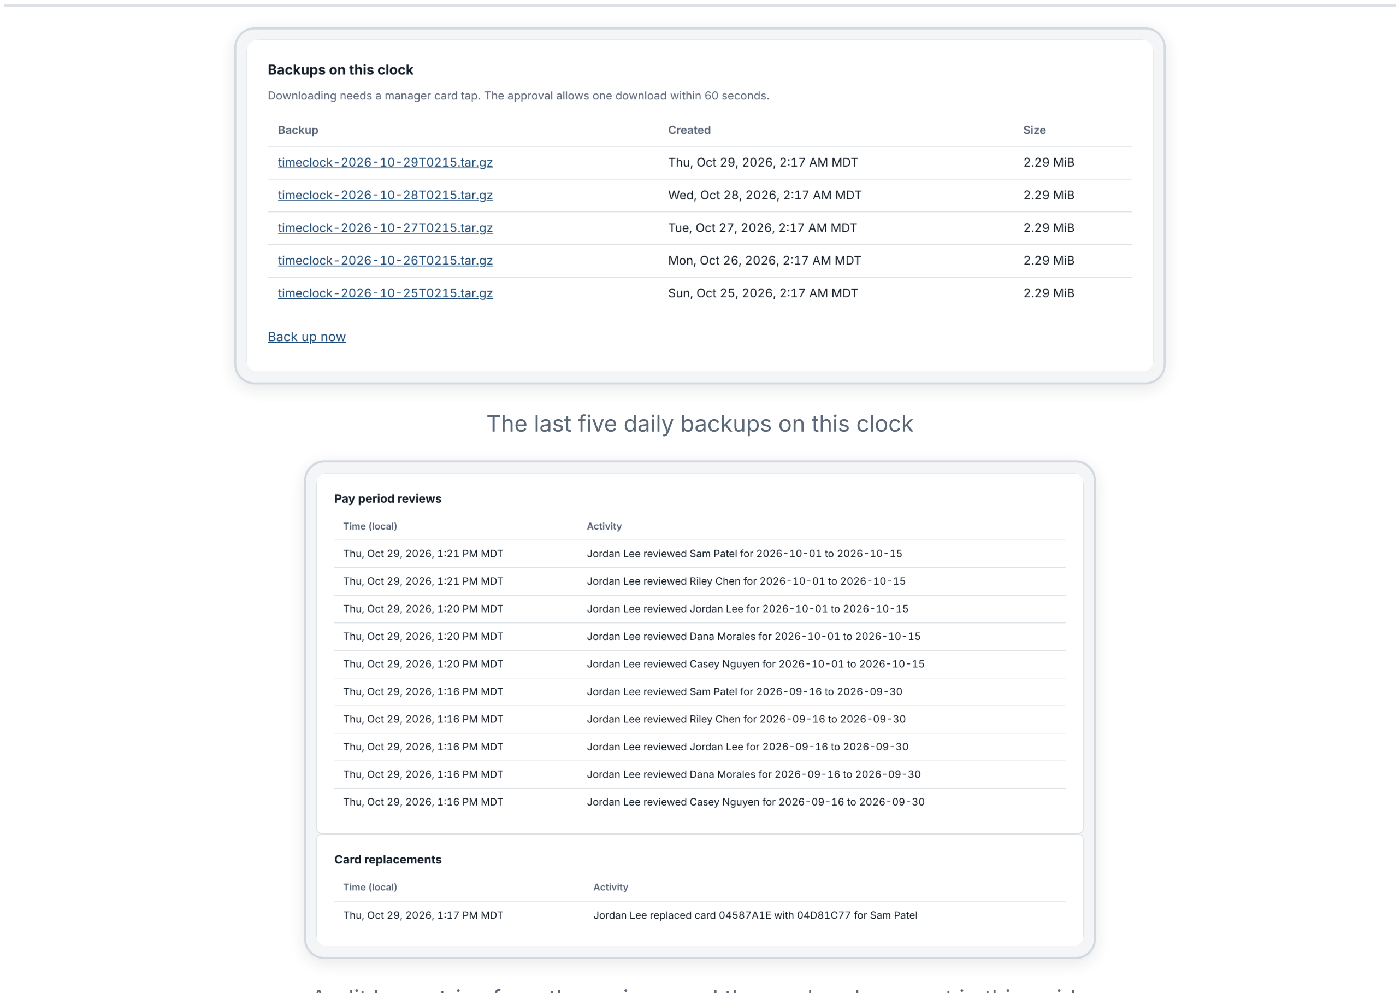
[picture p93: figure]

The last five daily backups on this clock

Audit log entries from the reviews and the card replacement in this guide

Q U I C K RE F ERE N C E

# Common tasks

I NEED TO | GO TO
Add a new hire | Employees > Add employee, then their Schedule
Find an employee | Employees > Search by name
Give someone a replacement card | Employees, open the person, Cards > Replace
Deal with someone leaving | Employees, open the person: untick Active (manager card), then Deactivate their card
Add a forgotten IN or OUT | Attendance > Add missed punch
Remove an accidental punch | Attendance > Void
Explain an approved late or early punch | Attendance > Manager note
Record a sick day | Attendance > Recorded absences
Approve or deny vacation | Vacation
Record vacation approved by phone or email | Vacation > Record vacation
Send someone their timesheet again | Settings > Employee emails and links > Email link
Send someone a vacation link | Employees, open the person, Send vacation link
Review a pay period | Pay periods > Review > Mark reviewed for each employee
Save the payroll report | Pay periods > Create export / revision
Resend the payroll report | Pay periods > Send report (closed periods only)
Change the grace period | Settings > Late grace and repeat taps
Check an email was sent | Settings > Email queue
Add a stat holiday | Settings > Stat holidays
See a clock's IP address or version | Settings > Clock management
See who changed something | Settings > Audit log

### What changed since the RC3 guide

The menu is now Overview, Attendance, Employees, Pay periods, Vacation and Settings. Device pages, timesheet links and setup pages are under Settings.
Cards, card replacement and schedules are inside each employee's record. The separate Card status and Who is in pages are gone.
Pay periods close automatically. Employees no longer approve timesheets; managers use Mark reviewed, with no override.
New: daily attendance snapshot emails, last-scheduled-day link timing, Copy and Revoke link, 12 or 24-hour clock display, clock outage emails, and in RC6.1 each Secondary's IP address and version on Clock

The screenshots come from the actual timeclock software (1.9.5-RC6.1) running on sample data. The names, card numbers and addresses are made up.
