mkinderwater/mk-timeclock/KNOWN_BUGS.md

# Previously reported email bugs

RC5.13 fixes the early-link expiry and invisible preparation-failure bugs reported October 29, 2026. See release notes and validation.
