mkinderwater/mk-timeclock/RELEASE_NOTES_cleanup7.md

# RC3 cleanup7

Fix action, helper-text and status spacing on Punches and corrections, Pay periods, Late arrival explanation, Clock management and Stat holidays. Add a holiday CSV example and explain staging before Save holidays. Refresh CSS cache version.

Source release based on cleanup6, with the updated build README. No Debian packaging added.

CSS lint, preflight, two targeted checks and JavaScript syntax checks passed. Compilation and browser/device acceptance were not completed. A legacy template source-string assertion fails; no template behavior was changed. See validation/cleanup7-ui-spacing.json.
