mkinderwater/mk-timeclock/src/server.c

#define _GNU_SOURCE
#include <sys/wait.h>
#define _POSIX_C_SOURCE 200809L
#include <arpa/inet.h>
#include <netinet/in.h>
#include <sys/socket.h>
#include <sys/types.h>
#include <signal.h>
#include <sqlite3.h>
#include <stdio.h>
#include <stdlib.h>
#include <string.h>
#include <strings.h>
#include <sys/time.h>
#include <unistd.h>
#include <errno.h>
#include <ctype.h>
#include <crypt.h>
#include <time.h>
#include <fcntl.h>
#include <poll.h>
#include <sys/stat.h>
#include <sys/statvfs.h>
#include <sys/sendfile.h>
#include <sys/file.h>
#include <sys/utsname.h>
#include <sys/sysinfo.h>
#include <sys/timex.h>
#include <dirent.h>
#include "oled.h"
#include "version.h"
#include "wifi_signal.h"
#include "common.h"
#include "payroll_config.h"
#include "email_render.h"

static sqlite3 *db;
static const char *device_key;
/* Single-threaded request context: the card that approved the current edit. */
static char approval_card_uid[48];

static volatile sig_atomic_t stop_flag;
static void stop_handler(int signum){(void)signum;stop_flag=1;}
static int sql(const char *s){char *err=NULL;int r=sqlite3_exec(db,s,NULL,NULL,&err);if(r!=SQLITE_OK){fprintf(stderr,"sqlite: %s\n",err?err:"unknown");sqlite3_free(err);}return r==SQLITE_OK;}
static int seed_templates(void);
static void approval_uid_sql(sqlite3_context *c,int argc,sqlite3_value **argv){
 (void)argc;(void)argv;
 if(approval_card_uid[0])sqlite3_result_text(c,approval_card_uid,-1,SQLITE_TRANSIENT);else sqlite3_result_null(c);
}
static int rec_schema(void);
static int note_link_schema(void);
static int timeoff_schema(void);
static const char*note_link_base(char*,size_t);
static int welcome_enqueue(long employee_id);
static void welcome_resend(int fd,int who,const char *body);
/* Only additions needed by current RC3 settings; no historical schema conversion. */
static int current_settings_schema(void){
 const char *tables[]={"smtp_settings","employees","payroll_settings","payroll_settings","review_send_settings","employees","attendance_events","attendance_events","attendance_events","attendance_events","punch_corrections","punch_corrections","punch_corrections","punch_corrections","pay_periods","review_send_settings","review_links","review_send_settings","attendance_events","clock_dim_settings","clock_health","clock_health"};
 const char *columns[]={"sender_name","vacation_days","send_time","previous_business_day","send_time","employee_number","early_minutes","departure_finish","departure_due","departure_ready","late_minutes","early_minutes","departure_finish","departure_due","closure_method","mode","token","hours_before_finish","out_of_shift","hour24","ip_address","software_version"};
 const char *definitions[]={"TEXT NOT NULL DEFAULT ''","REAL CHECK(vacation_days IS NULL OR (vacation_days BETWEEN 0 AND 366 AND vacation_days*2=CAST(vacation_days*2 AS INTEGER)))","TEXT NOT NULL DEFAULT '00:00'","INTEGER NOT NULL DEFAULT 0 CHECK(previous_business_day IN (0,1))","TEXT NOT NULL DEFAULT '00:00'","TEXT NOT NULL DEFAULT ''","INTEGER NOT NULL DEFAULT 0 CHECK(early_minutes>=0)","INTEGER NOT NULL DEFAULT 0","INTEGER NOT NULL DEFAULT 0","INTEGER NOT NULL DEFAULT 0","INTEGER NOT NULL DEFAULT 0","INTEGER","INTEGER NOT NULL DEFAULT 0","INTEGER NOT NULL DEFAULT 0","TEXT NOT NULL DEFAULT 'manual' CHECK(closure_method IN ('manual','automatic'))","TEXT NOT NULL DEFAULT 'after_period' CHECK(mode IN ('after_period','last_scheduled'))","TEXT NOT NULL DEFAULT ''","INTEGER NOT NULL DEFAULT 1 CHECK(hours_before_finish BETWEEN 0 AND 24)","INTEGER NOT NULL DEFAULT 0 CHECK(out_of_shift IN (0,1))","INTEGER NOT NULL DEFAULT 0 CHECK(hour24 IN (0,1))","TEXT NOT NULL DEFAULT ''","TEXT NOT NULL DEFAULT ''"};
 for(size_t i=0;i<sizeof tables/sizeof tables[0];i++){
  sqlite3_stmt *q=NULL;int found=0;char query[100];snprintf(query,sizeof query,"PRAGMA table_info(%s)",tables[i]);
  if(sqlite3_prepare_v2(db,query,-1,&q,NULL)!=SQLITE_OK)return 0;
  while(sqlite3_step(q)==SQLITE_ROW)if(!strcmp((const char*)sqlite3_column_text(q,1),columns[i]))found=1;
  sqlite3_finalize(q);
  if(!found){char *change=sqlite3_mprintf("ALTER TABLE %s ADD COLUMN %s %s",tables[i],columns[i],definitions[i]);int ok=change&&sql(change);sqlite3_free(change);if(!ok)return 0;}
 }
 sqlite3_stmt*obsolete=NULL;int has_timing=0;
 if(sqlite3_prepare_v2(db,"PRAGMA table_info(employees)",-1,&obsolete,NULL)!=SQLITE_OK)return 0;
 while(sqlite3_step(obsolete)==SQLITE_ROW)if(!strcmp((const char*)sqlite3_column_text(obsolete,1),"review_timing"))has_timing=1;
 sqlite3_finalize(obsolete);
 if(has_timing&&!sql("ALTER TABLE employees DROP COLUMN review_timing"))return 0;
 sqlite3_stmt*daily=NULL;int old_daily=0;
 if(sqlite3_prepare_v2(db,"PRAGMA table_info(daily_attendance_settings)",-1,&daily,NULL)!=SQLITE_OK)return 0;
 while(sqlite3_step(daily)==SQLITE_ROW)if(!strcmp((const char*)sqlite3_column_text(daily,1),"mode"))old_daily=1;
 sqlite3_finalize(daily);
 if(old_daily&&!sql("SAVEPOINT simplify_daily;ALTER TABLE daily_attendance_settings RENAME TO daily_attendance_old;CREATE TABLE daily_attendance_settings(id INTEGER PRIMARY KEY CHECK(id=1),enabled INTEGER NOT NULL DEFAULT 0 CHECK(enabled IN (0,1)),send_time TEXT NOT NULL DEFAULT '19:00');INSERT INTO daily_attendance_settings SELECT id,mode<>'off',send_time FROM daily_attendance_old;DROP TABLE daily_attendance_old;RELEASE simplify_daily;"))return 0;
 return sql("CREATE INDEX IF NOT EXISTS attendance_departure_due ON attendance_events(departure_due) WHERE departure_due>0; CREATE INDEX IF NOT EXISTS correction_departure_due ON punch_corrections(departure_due) WHERE departure_due>0");
}
static int init_db(const char *path){
 if(sqlite3_open(path,&db)!=SQLITE_OK)return 0;
 sqlite3_busy_timeout(db,3000);
 if(sqlite3_create_function(db,"approval_uid",0,SQLITE_UTF8,NULL,approval_uid_sql,NULL,NULL)!=SQLITE_OK)return 0;
 return sql("PRAGMA journal_mode=WAL; PRAGMA synchronous=NORMAL; PRAGMA foreign_keys=ON;"
 "CREATE TABLE IF NOT EXISTS employees(id INTEGER PRIMARY KEY,employee_number TEXT NOT NULL DEFAULT '',name TEXT NOT NULL,email TEXT,phone TEXT NOT NULL DEFAULT '',active INTEGER NOT NULL DEFAULT 1,late_email_enabled INTEGER NOT NULL DEFAULT 1,auto_review_enabled INTEGER NOT NULL DEFAULT 1,first_name TEXT NOT NULL DEFAULT '',last_name TEXT NOT NULL DEFAULT '',position TEXT NOT NULL DEFAULT '',schedule_exempt INTEGER NOT NULL DEFAULT 0 CHECK(schedule_exempt IN (0,1)),attendance_mode TEXT NOT NULL DEFAULT 'punch_required' CHECK(attendance_mode IN ('punch_required','vacation_only')),vacation_days REAL CHECK(vacation_days IS NULL OR (vacation_days BETWEEN 0 AND 366 AND vacation_days*2=CAST(vacation_days*2 AS INTEGER))),welcomed_at TEXT,created_at TEXT NOT NULL DEFAULT (strftime('%Y-%m-%dT%H:%M:%fZ','now')));"
 "CREATE TABLE IF NOT EXISTS employee_attendance_modes(employee_id INTEGER NOT NULL REFERENCES employees(id),effective_at TEXT NOT NULL,mode TEXT NOT NULL CHECK(mode IN ('punch_required','vacation_only')),PRIMARY KEY(employee_id,effective_at));"
 "CREATE TRIGGER IF NOT EXISTS employee_mode_initial AFTER INSERT ON employees BEGIN INSERT INTO employee_attendance_modes(employee_id,effective_at,mode) VALUES(NEW.id,NEW.created_at,NEW.attendance_mode); END;"
 "CREATE TRIGGER IF NOT EXISTS employee_mode_changed AFTER UPDATE OF attendance_mode ON employees WHEN OLD.attendance_mode<>NEW.attendance_mode BEGIN INSERT INTO employee_attendance_modes(employee_id,effective_at,mode) VALUES(NEW.id,strftime('%Y-%m-%dT%H:%M:%fZ','now'),NEW.attendance_mode) ON CONFLICT(employee_id,effective_at) DO UPDATE SET mode=excluded.mode; END;"
 "CREATE TABLE IF NOT EXISTS cards(uid TEXT PRIMARY KEY COLLATE NOCASE,employee_id INTEGER NOT NULL REFERENCES employees(id),active INTEGER NOT NULL DEFAULT 1);"
 "CREATE TABLE IF NOT EXISTS card_ownership_history(id INTEGER PRIMARY KEY,uid TEXT NOT NULL COLLATE NOCASE,employee_id INTEGER NOT NULL REFERENCES employees(id),active INTEGER NOT NULL CHECK(active IN(0,1)),effective_at TEXT NOT NULL);"
 "CREATE INDEX IF NOT EXISTS card_ownership_lookup ON card_ownership_history(uid,effective_at,id);"
 "CREATE TRIGGER IF NOT EXISTS card_history_new AFTER INSERT ON cards BEGIN INSERT INTO card_ownership_history(uid,employee_id,active,effective_at) VALUES(NEW.uid,NEW.employee_id,NEW.active,strftime('%Y-%m-%dT%H:%M:%fZ','now')); END;"
 "CREATE TRIGGER IF NOT EXISTS card_history_change AFTER UPDATE OF employee_id,active ON cards WHEN OLD.employee_id<>NEW.employee_id OR OLD.active<>NEW.active BEGIN INSERT INTO card_ownership_history(uid,employee_id,active,effective_at) VALUES(NEW.uid,NEW.employee_id,NEW.active,strftime('%Y-%m-%dT%H:%M:%fZ','now')); END;"
 "CREATE TABLE IF NOT EXISTS employee_active_history(id INTEGER PRIMARY KEY,employee_id INTEGER NOT NULL REFERENCES employees(id),active INTEGER NOT NULL CHECK(active IN(0,1)),effective_at TEXT NOT NULL);"
 "CREATE INDEX IF NOT EXISTS employee_active_lookup ON employee_active_history(employee_id,effective_at,id);"
 "CREATE TRIGGER IF NOT EXISTS employee_active_new AFTER INSERT ON employees BEGIN INSERT INTO employee_active_history(employee_id,active,effective_at) VALUES(NEW.id,NEW.active,NEW.created_at); END;"
 "CREATE TRIGGER IF NOT EXISTS employee_active_change AFTER UPDATE OF active ON employees WHEN OLD.active<>NEW.active BEGIN INSERT INTO employee_active_history(employee_id,active,effective_at) VALUES(NEW.id,NEW.active,strftime('%Y-%m-%dT%H:%M:%fZ','now')); END;"
 "CREATE TABLE IF NOT EXISTS swipes(event_id TEXT PRIMARY KEY,clock_id TEXT NOT NULL,card_uid TEXT NOT NULL,employee_id INTEGER,swiped_at TEXT NOT NULL,received_at TEXT NOT NULL DEFAULT (strftime('%Y-%m-%dT%H:%M:%fZ','now')));"
 "CREATE INDEX IF NOT EXISTS swipes_employee_time ON swipes(employee_id,swiped_at);"
 "CREATE TABLE IF NOT EXISTS lite_install_identity(id INTEGER PRIMARY KEY CHECK(id=1),value TEXT NOT NULL CHECK(length(value)=32));"
 "INSERT OR IGNORE INTO lite_install_identity(id,value) VALUES(1,lower(hex(randomblob(16))));"
 "CREATE TABLE IF NOT EXISTS smtp_settings(id INTEGER PRIMARY KEY CHECK(id=1),url TEXT NOT NULL DEFAULT '',username TEXT NOT NULL DEFAULT '',password TEXT NOT NULL DEFAULT '',tls_mode TEXT NOT NULL DEFAULT 'starttls',sender TEXT NOT NULL DEFAULT '',sender_name TEXT NOT NULL DEFAULT '');"
 "CREATE TABLE IF NOT EXISTS email_templates(id TEXT PRIMARY KEY,subject TEXT NOT NULL,body TEXT NOT NULL,enabled INTEGER NOT NULL DEFAULT 1);"
 "CREATE TABLE IF NOT EXISTS email_retry_audit(id INTEGER PRIMARY KEY,email_id INTEGER NOT NULL,manager_id INTEGER NOT NULL,retried_at TEXT NOT NULL DEFAULT (strftime('%Y-%m-%dT%H:%M:%fZ','now')));"
 "CREATE TABLE IF NOT EXISTS template_restore_audit(id INTEGER PRIMARY KEY,template_id TEXT NOT NULL,manager_id INTEGER NOT NULL,approved_uid TEXT NOT NULL,restored_at TEXT NOT NULL DEFAULT (strftime('%Y-%m-%dT%H:%M:%fZ','now')));"
 "CREATE TABLE IF NOT EXISTS clock_health(clock_id TEXT PRIMARY KEY REFERENCES registered_clocks(clock_id),last_seen INTEGER NOT NULL DEFAULT 0,monitor_since INTEGER NOT NULL,pending INTEGER NOT NULL DEFAULT 0,oldest TEXT NOT NULL DEFAULT '',rejected INTEGER NOT NULL DEFAULT 0,healthy INTEGER NOT NULL DEFAULT 1,synced INTEGER NOT NULL DEFAULT 1,outage_started INTEGER NOT NULL DEFAULT 0,ip_address TEXT NOT NULL DEFAULT '',software_version TEXT NOT NULL DEFAULT '');"
 "CREATE TABLE IF NOT EXISTS email_preparation_failures(event_id TEXT PRIMARY KEY,employee_id INTEGER NOT NULL DEFAULT 0,context TEXT NOT NULL,last_error TEXT NOT NULL,updated_at INTEGER NOT NULL,resolved_at INTEGER NOT NULL DEFAULT 0,resolved_by INTEGER NOT NULL DEFAULT 0);"
 "CREATE TABLE IF NOT EXISTS email_queue(id INTEGER PRIMARY KEY,recipient TEXT NOT NULL,subject TEXT NOT NULL,body TEXT NOT NULL,status TEXT NOT NULL DEFAULT 'pending',next_attempt TEXT,attempts INTEGER NOT NULL DEFAULT 0,event_id TEXT UNIQUE,last_error TEXT NOT NULL DEFAULT '',csv_attachment TEXT NOT NULL DEFAULT '',message_token TEXT NOT NULL DEFAULT '');"
 "CREATE TRIGGER IF NOT EXISTS lite_email_token_new AFTER INSERT ON email_queue WHEN NEW.message_token='' BEGIN UPDATE email_queue SET message_token=lower(hex(randomblob(16))) WHERE id=NEW.id; END;"
 "CREATE TABLE IF NOT EXISTS attendance_events(event_id TEXT PRIMARY KEY REFERENCES swipes(event_id),employee_id INTEGER NOT NULL REFERENCES employees(id),kind TEXT NOT NULL CHECK(kind IN ('IN','OUT')),late_minutes INTEGER NOT NULL DEFAULT 0,early_minutes INTEGER NOT NULL DEFAULT 0 CHECK(early_minutes>=0),departure_finish INTEGER NOT NULL DEFAULT 0,departure_due INTEGER NOT NULL DEFAULT 0,departure_ready INTEGER NOT NULL DEFAULT 0,exception TEXT NOT NULL DEFAULT '',paired_in_event TEXT,out_of_shift INTEGER NOT NULL DEFAULT 0 CHECK(out_of_shift IN (0,1)));"
 "CREATE INDEX IF NOT EXISTS attendance_events_employee ON attendance_events(employee_id);"
 "CREATE TABLE IF NOT EXISTS schedule_profiles(employee_id INTEGER PRIMARY KEY REFERENCES employees(id),pay_type TEXT NOT NULL CHECK(pay_type IN ('salary','hourly')),start_time TEXT NOT NULL DEFAULT '09:00',end_time TEXT NOT NULL DEFAULT '17:00',weekday_mask INTEGER NOT NULL DEFAULT 31,schedule_mode TEXT NOT NULL DEFAULT 'dated_shifts' CHECK(schedule_mode IN ('recurring_weekly','dated_shifts','none')));"
 "CREATE TABLE IF NOT EXISTS payroll_settings(id INTEGER PRIMARY KEY CHECK(id=1),anchor_payday TEXT NOT NULL DEFAULT '',lead_days INTEGER NOT NULL DEFAULT 3,recipient TEXT NOT NULL DEFAULT '',enabled INTEGER NOT NULL DEFAULT 0,enabled_since TEXT NOT NULL DEFAULT '',send_time TEXT NOT NULL DEFAULT '00:00',previous_business_day INTEGER NOT NULL DEFAULT 0 CHECK(previous_business_day IN (0,1)));"
 "CREATE TABLE IF NOT EXISTS payroll_manual_requests(period_id INTEGER PRIMARY KEY,requested_at TEXT NOT NULL DEFAULT (strftime('%Y-%m-%dT%H:%M:%fZ','now')));"
 "CREATE TABLE IF NOT EXISTS lite_payroll_queue_failures(period_id INTEGER PRIMARY KEY,reason TEXT NOT NULL,failed_at TEXT NOT NULL DEFAULT (strftime('%Y-%m-%dT%H:%M:%fZ','now')));"
 "CREATE TABLE IF NOT EXISTS payroll_authorization(id INTEGER PRIMARY KEY CHECK(id=1),requested_by INTEGER NOT NULL,change_body TEXT NOT NULL,armed_at INTEGER NOT NULL);"
 "CREATE TABLE IF NOT EXISTS schedule_shifts(id INTEGER PRIMARY KEY,employee_id INTEGER NOT NULL REFERENCES employees(id),work_date TEXT NOT NULL,start_time TEXT NOT NULL,end_time TEXT NOT NULL,UNIQUE(employee_id,work_date,start_time));"
 "CREATE TABLE IF NOT EXISTS schedule_authorization(id INTEGER PRIMARY KEY CHECK(id=1),requested_by INTEGER NOT NULL,change_body TEXT NOT NULL,armed_at INTEGER NOT NULL);"
 "CREATE TABLE IF NOT EXISTS schedule_change_audit(id INTEGER PRIMARY KEY,manager_id INTEGER NOT NULL REFERENCES employees(id),change_body TEXT NOT NULL,recorded_at TEXT NOT NULL DEFAULT (strftime('%Y-%m-%dT%H:%M:%fZ','now')));"
 "CREATE TABLE IF NOT EXISTS employee_change_audit(id INTEGER PRIMARY KEY,manager_id INTEGER NOT NULL REFERENCES employees(id),employee_id INTEGER,change_body TEXT NOT NULL,recorded_at TEXT NOT NULL DEFAULT (strftime('%Y-%m-%dT%H:%M:%fZ','now')));"
 "CREATE TABLE IF NOT EXISTS user_accounts(id INTEGER PRIMARY KEY,employee_id INTEGER UNIQUE REFERENCES employees(id),password_hash TEXT,disabled INTEGER NOT NULL DEFAULT 0);"
 "CREATE TABLE IF NOT EXISTS login_sessions(token TEXT PRIMARY KEY,employee_id INTEGER NOT NULL REFERENCES employees(id),expires_at INTEGER NOT NULL);"
 "CREATE TABLE IF NOT EXISTS review_send_settings(id INTEGER PRIMARY KEY CHECK(id=1),enabled INTEGER NOT NULL DEFAULT 1,days_after INTEGER NOT NULL DEFAULT 1 CHECK(days_after BETWEEN 0 AND 7),send_time TEXT NOT NULL DEFAULT '00:00',mode TEXT NOT NULL DEFAULT 'after_period' CHECK(mode IN ('after_period','last_scheduled')),hours_before_finish INTEGER NOT NULL DEFAULT 1 CHECK(hours_before_finish BETWEEN 0 AND 24));"
 "INSERT OR IGNORE INTO review_send_settings(id) VALUES(1);"
 "CREATE TABLE IF NOT EXISTS daily_attendance_settings(id INTEGER PRIMARY KEY CHECK(id=1),enabled INTEGER NOT NULL DEFAULT 0 CHECK(enabled IN (0,1)),send_time TEXT NOT NULL DEFAULT '19:00');"
 "INSERT OR IGNORE INTO daily_attendance_settings(id) VALUES(1);"
 "CREATE TABLE IF NOT EXISTS review_links(employee_id INTEGER NOT NULL REFERENCES employees(id),period_id INTEGER NOT NULL REFERENCES pay_periods(id),token_hash TEXT NOT NULL,token TEXT NOT NULL DEFAULT '',expires_at INTEGER NOT NULL,created_by INTEGER NOT NULL REFERENCES employees(id),created_at INTEGER NOT NULL,revoked INTEGER NOT NULL DEFAULT 0,PRIMARY KEY(employee_id,period_id));"
 "CREATE TABLE IF NOT EXISTS account_authorization(id INTEGER PRIMARY KEY CHECK(id=1),requested_by INTEGER NOT NULL,employee_id INTEGER NOT NULL,action TEXT NOT NULL,proposed_hash TEXT,armed_at INTEGER NOT NULL);"
 "CREATE TABLE IF NOT EXISTS account_change_audit(id INTEGER PRIMARY KEY,manager_id INTEGER NOT NULL,target_id INTEGER NOT NULL,action TEXT NOT NULL,at TEXT NOT NULL DEFAULT (strftime('%Y-%m-%dT%H:%M:%fZ','now')));"
 "CREATE TABLE IF NOT EXISTS review_link_audit(id INTEGER PRIMARY KEY,manager_id INTEGER NOT NULL,employee_id INTEGER NOT NULL,period_id INTEGER NOT NULL,action TEXT NOT NULL,at TEXT NOT NULL DEFAULT (strftime('%Y-%m-%dT%H:%M:%fZ','now')));"
 "CREATE TABLE IF NOT EXISTS oled_previews(clock_id TEXT PRIMARY KEY,frame TEXT NOT NULL,updated_at TEXT NOT NULL DEFAULT (strftime('%Y-%m-%dT%H:%M:%fZ','now')));"
 "CREATE TABLE IF NOT EXISTS swipe_notes(event_id TEXT PRIMARY KEY REFERENCES swipes(event_id),note TEXT NOT NULL DEFAULT '',updated_by INTEGER REFERENCES employees(id),updated_at TEXT NOT NULL DEFAULT (strftime('%Y-%m-%dT%H:%M:%fZ','now')));"
 "CREATE TABLE IF NOT EXISTS swipe_note_history(id INTEGER PRIMARY KEY,event_id TEXT NOT NULL,note TEXT NOT NULL,updated_by INTEGER,updated_at TEXT NOT NULL,approved_card_uid TEXT);"
 "CREATE TRIGGER IF NOT EXISTS swipe_note_history_insert AFTER INSERT ON swipe_notes BEGIN INSERT INTO swipe_note_history(event_id,note,updated_by,updated_at,approved_card_uid) VALUES(NEW.event_id,NEW.note,NEW.updated_by,NEW.updated_at,approval_uid()); END;"
 "CREATE TRIGGER IF NOT EXISTS swipe_note_history_update AFTER UPDATE ON swipe_notes BEGIN INSERT INTO swipe_note_history(event_id,note,updated_by,updated_at,approved_card_uid) VALUES(NEW.event_id,NEW.note,NEW.updated_by,NEW.updated_at,approval_uid()); END;"
 "CREATE TABLE IF NOT EXISTS lite_period_snapshots(period_id INTEGER NOT NULL REFERENCES pay_periods(id),revision INTEGER NOT NULL CHECK(revision>=1),starts TEXT NOT NULL,ends TEXT NOT NULL,csv TEXT NOT NULL,created_at TEXT NOT NULL DEFAULT (strftime('%Y-%m-%dT%H:%M:%fZ','now')),PRIMARY KEY(period_id,revision));"
 "CREATE TRIGGER IF NOT EXISTS lite_snapshot_no_replace BEFORE INSERT ON lite_period_snapshots WHEN EXISTS(SELECT 1 FROM lite_period_snapshots WHERE period_id=NEW.period_id AND revision=NEW.revision) BEGIN SELECT RAISE(IGNORE); END;"
 "CREATE TRIGGER IF NOT EXISTS lite_snapshot_no_update BEFORE UPDATE ON lite_period_snapshots BEGIN SELECT RAISE(ABORT,'payroll snapshot immutable'); END;"
 "CREATE TRIGGER IF NOT EXISTS lite_snapshot_no_delete BEFORE DELETE ON lite_period_snapshots BEGIN SELECT RAISE(ABORT,'payroll snapshot immutable'); END;"
 "CREATE TABLE IF NOT EXISTS admin_export_audit(id INTEGER PRIMARY KEY,manager_id INTEGER NOT NULL,scope TEXT NOT NULL,format TEXT NOT NULL,from_date TEXT NOT NULL,to_date TEXT NOT NULL,created_at TEXT NOT NULL DEFAULT (strftime('%Y-%m-%dT%H:%M:%fZ','now')));"
 "CREATE TABLE IF NOT EXISTS rejected_uploads(event_id TEXT PRIMARY KEY,clock_id TEXT NOT NULL,card_uid TEXT NOT NULL,swiped_at TEXT NOT NULL,http_status INTEGER NOT NULL,reason TEXT NOT NULL,rejected_at TEXT NOT NULL,received_at TEXT NOT NULL DEFAULT (strftime('%Y-%m-%dT%H:%M:%fZ','now')));"
 "CREATE TABLE IF NOT EXISTS unknown_cards(uid TEXT PRIMARY KEY COLLATE NOCASE,clock_id TEXT NOT NULL,first_seen TEXT NOT NULL,last_seen TEXT NOT NULL,seen_count INTEGER NOT NULL DEFAULT 1);"
 "CREATE TABLE IF NOT EXISTS employee_roles(employee_id INTEGER REFERENCES employees(id),role TEXT NOT NULL,PRIMARY KEY(employee_id,role));"
 "CREATE TABLE IF NOT EXISTS manager_cards(uid TEXT PRIMARY KEY COLLATE NOCASE,manager_id INTEGER NOT NULL REFERENCES employees(id),active INTEGER NOT NULL DEFAULT 1);"
 "CREATE TRIGGER IF NOT EXISTS guard_employee_card_insert BEFORE INSERT ON cards WHEN EXISTS(SELECT 1 FROM manager_cards WHERE uid=NEW.uid COLLATE NOCASE) BEGIN SELECT RAISE(ABORT,'UID reserved for manager card'); END;"
 "CREATE TRIGGER IF NOT EXISTS guard_employee_card_update BEFORE UPDATE OF uid ON cards WHEN EXISTS(SELECT 1 FROM manager_cards WHERE uid=NEW.uid COLLATE NOCASE) BEGIN SELECT RAISE(ABORT,'UID reserved for manager card'); END;"
 "CREATE TRIGGER IF NOT EXISTS guard_manager_card_insert BEFORE INSERT ON manager_cards WHEN EXISTS(SELECT 1 FROM cards WHERE uid=NEW.uid COLLATE NOCASE) BEGIN SELECT RAISE(ABORT,'UID reserved for employee card'); END;"
 "CREATE TRIGGER IF NOT EXISTS guard_manager_card_update BEFORE UPDATE OF uid ON manager_cards WHEN EXISTS(SELECT 1 FROM cards WHERE uid=NEW.uid COLLATE NOCASE) BEGIN SELECT RAISE(ABORT,'UID reserved for employee card'); END;"
 "CREATE TABLE IF NOT EXISTS manager_scan(id INTEGER PRIMARY KEY CHECK(id=1),armed_at INTEGER NOT NULL DEFAULT 0,uid TEXT NOT NULL DEFAULT '',scanned_at INTEGER NOT NULL DEFAULT 0,request_token TEXT NOT NULL DEFAULT '',scan_mode TEXT NOT NULL DEFAULT 'enrollment');"
 "CREATE TABLE IF NOT EXISTS first_manager_setup(id INTEGER PRIMARY KEY CHECK(id=1),name TEXT NOT NULL,email TEXT NOT NULL,position TEXT NOT NULL,password_hash TEXT NOT NULL,request_token TEXT NOT NULL,armed_at INTEGER NOT NULL);"
 "INSERT OR IGNORE INTO manager_scan(id) VALUES(1);"
 "CREATE TABLE IF NOT EXISTS manager_authorization(id INTEGER PRIMARY KEY CHECK(id=1),requested_by INTEGER NOT NULL,change_body TEXT NOT NULL,armed_at INTEGER NOT NULL);"
 "CREATE TABLE IF NOT EXISTS statutory_holidays(day TEXT PRIMARY KEY,name TEXT NOT NULL);"
 "CREATE TABLE IF NOT EXISTS holiday_settings(id INTEGER PRIMARY KEY CHECK(id=1),skip_alerts INTEGER NOT NULL DEFAULT 0);"
 "CREATE TABLE IF NOT EXISTS registered_clocks(clock_id TEXT PRIMARY KEY,device_key TEXT NOT NULL UNIQUE,active INTEGER NOT NULL DEFAULT 1 CHECK(active IN(0,1)));"
 "CREATE TABLE IF NOT EXISTS clock_names(clock_id TEXT PRIMARY KEY REFERENCES registered_clocks(clock_id),name TEXT NOT NULL CHECK(length(name) BETWEEN 1 AND 60));"
 "CREATE TABLE IF NOT EXISTS adoption_codes(code TEXT PRIMARY KEY,created_by INTEGER NOT NULL,expires_at INTEGER NOT NULL,used INTEGER NOT NULL DEFAULT 0);"
 "CREATE TABLE IF NOT EXISTS adoption_requests(id TEXT PRIMARY KEY,code TEXT NOT NULL,clock_id TEXT NOT NULL,status TEXT NOT NULL DEFAULT 'pending',device_key TEXT NOT NULL DEFAULT '',created_at INTEGER NOT NULL,UNIQUE(code,clock_id));"
 "CREATE TABLE IF NOT EXISTS clock_dim_settings(clock_id TEXT PRIMARY KEY REFERENCES registered_clocks(clock_id),enabled INTEGER NOT NULL DEFAULT 1 CHECK(enabled IN(0,1)),start_min INTEGER NOT NULL DEFAULT 1140 CHECK(start_min BETWEEN 0 AND 1439),end_min INTEGER NOT NULL DEFAULT 420 CHECK(end_min BETWEEN 0 AND 1439),normal_contrast INTEGER NOT NULL DEFAULT 127 CHECK(normal_contrast BETWEEN 1 AND 255),dim_contrast INTEGER NOT NULL DEFAULT 24 CHECK(dim_contrast BETWEEN 1 AND 255),font TEXT NOT NULL DEFAULT 'DejaVuSansMono.ttf',hour24 INTEGER NOT NULL DEFAULT 0 CHECK(hour24 IN(0,1)));"
 "CREATE TABLE IF NOT EXISTS clock_late_settings(clock_id TEXT PRIMARY KEY,grace_minutes INTEGER NOT NULL DEFAULT 5 CHECK(grace_minutes BETWEEN 0 AND 60));"
 "CREATE TABLE IF NOT EXISTS clock_duplicate_settings(clock_id TEXT PRIMARY KEY,duplicate_seconds INTEGER NOT NULL DEFAULT 120 CHECK(duplicate_seconds BETWEEN 0 AND 300));"
 "INSERT OR IGNORE INTO holiday_settings(id,skip_alerts) VALUES(1,0);"
 "CREATE TABLE IF NOT EXISTS system_actions(id INTEGER PRIMARY KEY CHECK(id=1),requested_by INTEGER,action TEXT,armed_at INTEGER);"
 "CREATE TABLE IF NOT EXISTS backup_settings(id INTEGER PRIMARY KEY CHECK(id=1),email_enabled INTEGER NOT NULL DEFAULT 0,manager_id INTEGER NOT NULL DEFAULT 0);"
 "INSERT OR IGNORE INTO backup_settings(id,email_enabled,manager_id) VALUES(1,0,0);"
 "CREATE TABLE IF NOT EXISTS backup_download(id INTEGER PRIMARY KEY CHECK(id=1),requested_by INTEGER NOT NULL,filename TEXT NOT NULL,token TEXT NOT NULL DEFAULT '',approved_at INTEGER NOT NULL DEFAULT 0);"
 "CREATE TABLE IF NOT EXISTS backup_restore(id INTEGER PRIMARY KEY CHECK(id=1),requested_by INTEGER NOT NULL,filename TEXT NOT NULL);"
 "CREATE TABLE IF NOT EXISTS backup_restore_audit(id INTEGER PRIMARY KEY,manager_id INTEGER NOT NULL,filename TEXT NOT NULL,requested_at TEXT NOT NULL DEFAULT (strftime('%Y-%m-%dT%H:%M:%fZ','now')));"
 "CREATE TABLE IF NOT EXISTS backup_download_audit(id INTEGER PRIMARY KEY,manager_id INTEGER NOT NULL,filename TEXT NOT NULL,downloaded_at TEXT NOT NULL DEFAULT (strftime('%Y-%m-%dT%H:%M:%fZ','now')));"
 "CREATE TABLE IF NOT EXISTS card_replacement_audit(id INTEGER PRIMARY KEY,manager_id INTEGER NOT NULL REFERENCES employees(id),employee_id INTEGER NOT NULL REFERENCES employees(id),old_uid TEXT NOT NULL,new_uid TEXT NOT NULL,replaced_at TEXT NOT NULL DEFAULT (strftime('%Y-%m-%dT%H:%M:%fZ','now')));"
) && seed_templates() && rec_schema() && current_settings_schema() && note_link_schema() && timeoff_schema();
}
typedef struct {const char *id,*subject,*body;} email_template_default;
static const email_template_default template_defaults[]={
 {"clock_offline_manager","Timeclock: {{clock_name}} is not reporting","Clock {{clock_name}} ({{clock_id}}) has not reported for at least three minutes.\nLast contact: {{last_contact}}\n{{backlog}}\n\nAttendance may be incomplete. Check power, network and the clock before finalizing reports. Cached cards may still record locally, but this cannot be confirmed remotely."},
 {"clock_recovered_manager","Timeclock: {{clock_name}} reconnected","Clock {{clock_name}} ({{clock_id}}) is reporting again.\nLast contact: {{last_contact}}\n{{backlog}}\n\nCheck rejected uploads and out-of-order punches before treating attendance as complete."},
  {"early_departure_employee","Timeclock: Early departure on {{attendance_date}}","Hello {{employee_name}},\n\nScheduled finish: {{scheduled_end}}\nRecorded OUT: {{actual_end}}\nEarly: {{early_minutes}} minutes\n\nTo add a reason, use this link within seven days:\n{{note_link}}\n\nContact your manager about any approved exception."},
  {"early_departure_manager","Timeclock: {{employee_name}} left {{early_minutes}} minutes early","Employee: {{employee_name}}\nDate: {{attendance_date}}\nScheduled finish: {{scheduled_end}}\nRecorded OUT: {{actual_end}}\nEarly: {{early_minutes}} minutes"},
  {"late_arrival_employee","Timeclock: Late arrival on {{attendance_date}}","Hello {{employee_name}},\n\nScheduled start: {{scheduled_start}}\nRecorded IN: {{actual_start}}\nLate: {{late_minutes}} minutes\n\nTo add a reason, use this link within seven days:\n{{note_link}}\n\nContact your manager about any approved exception."},
  {"late_arrival_manager","Timeclock: {{employee_name}} arrived {{late_minutes}} minutes late","Employee: {{employee_name}}\nDate: {{attendance_date}}\nScheduled start: {{scheduled_start}}\nRecorded IN: {{actual_start}}\nLate: {{late_minutes}} minutes"},
  {"attendance_report","Timeclock attendance: {{period_start}} to {{period_end}}","{{attendance_summary}}"},
  {"welcome_employee","Welcome to the timeclock","Hello {{employee_name}},\n\nYou can request vacation at {{timeoff_link}}.\n\nFor help with vacation or your recorded timesheet, contact your manager."},
  {"missing_out_employee","Timeclock: No OUT punch for {{attendance_date}}","Hello {{employee_name}},\n\nNo OUT punch has been recorded after your {{scheduled_end}} finish on {{attendance_date}}.\n\nIf you left without tapping out, contact your manager to record your departure time. If you are still working, ignore this message."},
  {"daily_attendance_employee","Your attendance for {{attendance_date}}","Hello {{employee_name}},\n\n{{daily_summary}}\nView your timesheet for {{period_start}} to {{period_end}}:\n{{review_link}}\n\nContact your manager if a punch is missing or incorrect."},
  {"auto_review_employee","Your timesheet for {{period_start}} to {{period_end}}","{{review_link}}\n\nHello {{employee_name}},\n\nYour timesheet for {{period_start}} to {{period_end}} is available at the link above.\n{{missing_punch_note}}\nContact your manager if there is an issue."},
  {"review_dispatch_payroll","Timeclock: Timesheet links queued for {{period_start}} to {{period_end}}","Timesheet links were queued for period {{period_start}} to {{period_end}}.\nEmployees emailed: {{sent_count}}\n\nThis confirms queuing, not delivery. Check the email queue for failures or employees without addresses."},
  {"timeoff_received_employee","Vacation request received: {{period_start}} to {{period_end}}","Hello {{employee_name}},\n\nYour {{request_type}} request for {{period_start}} to {{period_end}} ({{days_label}}, returning {{return_date}}) was sent to your manager.\n\nStatus: Pending."},
  {"timeoff_received_manager","Vacation request: {{employee_name}}","{{employee_name}} requested {{request_type}} from {{period_start}} to {{period_end}}.\nWorking days: {{days}}\nReturns: {{return_date}}\nNotes: {{note}}\n\nReview under Vacation."},
  {"timeoff_decision_employee","{{request_type}} request {{decision}}: {{period_start}} to {{period_end}}","Hello {{employee_name}},\n\nYour {{request_type}} request for {{period_start}} to {{period_end}} was {{decision}} by {{manager_name}}.\nManager note: {{note}}\n\nYou can view your history in Vacation."},
  {"timeoff_cancelled_employee","{{request_type}} approval cancelled: {{period_start}} to {{period_end}}","Hello {{employee_name}},\n\nYour previously approved {{request_type}} from {{period_start}} to {{period_end}} has been cancelled by {{manager_name}}.\nManager note: {{note}}\n\nPlease contact your manager about your work schedule."},
  {"email_failure_payroll","Timeclock: Email delivery failed","Hello,\n\nThe timeclock could not deliver an email after repeated attempts.\nRecipient: {{recipient}}\nSubject: {{failed_subject}}\n\nCheck the Email queue and contact the recipient if needed."},
  {"missing_in_employee","Timeclock: No IN punch for {{attendance_date}}","Hello {{employee_name}},\n\nNo IN punch has been recorded for your {{scheduled_start}} start on {{attendance_date}}.\n\nIf you are working, contact your manager to record your start time. If you are away or your schedule changed, let your manager know. If you already tapped in, ignore this message."},
 };


static const email_template_default *find_template_default(const char *id){
 for(size_t i=0;i<sizeof(template_defaults)/sizeof(template_defaults[0]);i++)if(!strcmp(template_defaults[i].id,id))return &template_defaults[i];
 return NULL;
}
static int seed_templates(void){
 sqlite3_stmt*q=NULL;
 if(sqlite3_prepare_v2(db,"INSERT OR IGNORE INTO email_templates(id,subject,body,enabled) VALUES(?1,?2,?3,1)",-1,&q,NULL)!=SQLITE_OK)return 0;
 int ok=1;
 for(size_t i=0;i<sizeof(template_defaults)/sizeof(template_defaults[0]);i++){
  sqlite3_reset(q);sqlite3_clear_bindings(q);
  sqlite3_bind_text(q,1,template_defaults[i].id,-1,SQLITE_STATIC);
  sqlite3_bind_text(q,2,template_defaults[i].subject,-1,SQLITE_STATIC);
  sqlite3_bind_text(q,3,template_defaults[i].body,-1,SQLITE_STATIC);
  if(sqlite3_step(q)!=SQLITE_DONE){ok=0;break;}
 }
 sqlite3_finalize(q);q=NULL;
 if(ok)ok=sql("DELETE FROM email_templates WHERE id IN ('review_reminder_employee','override_employee','swipe_employee')");
 return ok;
}
static int valid_id(const char *s,size_t max){size_t n=strlen(s);if(!n||n>max)return 0;for(;*s;s++)if(!isalnum((unsigned char)*s)&&!strchr("-_:.+",*s))return 0;return 1;}
static int json_string(const char *body,const char *key,char *out,size_t cap){
 char needle[80];snprintf(needle,sizeof needle,"\"%s\"",key);const char *p=strstr(body,needle);if(!p)return 0;p+=strlen(needle);while(isspace((unsigned char)*p))p++;if(*p++!=':')return 0;while(isspace((unsigned char)*p))p++;if(*p++!='"')return 0;
 size_t n=0;while(*p&&*p!='"'){if(*p=='\\'||(unsigned char)*p<32||n+1>=cap)return 0;out[n++]=*p++;}if(*p!='"')return 0;out[n]=0;return 1;
}
static const char *reason_phrase(int code){switch(code){case 200:return "OK";case 201:return "Created";case 202:return "Accepted";case 413:return "Payload Too Large";case 303:return "See Other";case 400:return "Bad Request";case 401:return "Unauthorized";case 403:return "Forbidden";case 404:return "Not Found";case 409:return "Conflict";case 422:return "Unprocessable Content";case 429:return "Too Many Requests";case 500:return "Internal Server Error";default:return "Error";}}
static int send_response(int fd,int code,const char *type,const char *body){char header[512];size_t n=strlen(body);int k=snprintf(header,sizeof header,"HTTP/1.1 %d %s\r\nContent-Type: %s\r\nContent-Length: %zu\r\nConnection: close\r\nCache-Control: no-store\r\nReferrer-Policy: no-referrer\r\nX-Content-Type-Options: nosniff\r\n\r\n",code,reason_phrase(code),type,n);if(k<=0||(size_t)k>=sizeof header)return 0;return send(fd,header,(size_t)k,0)==k&&send(fd,body,n,0)==(ssize_t)n;}

/* Standard JSON replies. Keep endpoint-specific status codes and messages separate. */
static void reply_incomplete(int fd){send_response(fd,400,"application/json","{\"error\":\"Request incomplete. Reload the page and try again.\"}");}
static void reply_busy(int fd){send_response(fd,503,"application/json","{\"error\":\"The clock is busy. Try again.\"}");}
static void reply_failed(int fd){send_response(fd,500,"application/json","{\"error\":\"The clock could not complete this. Try again.\"}");}
/* A failed BEGIN is only a contention response for BUSY/LOCKED. */
static int begin_change(int fd){
 int rc=sqlite3_exec(db,"BEGIN IMMEDIATE",NULL,NULL,NULL);
 if(rc==SQLITE_OK)return 1;
 if((rc&0xff)==SQLITE_BUSY||(rc&0xff)==SQLITE_LOCKED)reply_busy(fd);
 else{fprintf(stderr,"begin_change: %s\n",sqlite3_errmsg(db));reply_failed(fd);}
 return 0;
}
#include "ui.inc"
#include "clock_preview.h"
#include "employee_schedule.h"
#include "employee_cards.h"
static int clock_synced(void);
static long long tls_not_after(void);
static int tls_temporary(void);
static int form_value(const char*,const char*,char*,size_t);
static void diag_escape(const char*,char*,size_t);
static int random_hex(char*out,size_t bytes){
 unsigned char b[48];if(bytes>sizeof b)return 0;
 int f=open("/dev/urandom",O_RDONLY);if(f<0)return 0;
 size_t got=0;while(got<bytes){ssize_t n=read(f,b+got,bytes-got);if(n<=0){close(f);return 0;}got+=(size_t)n;}close(f);
 static const char hex[]="0123456789abcdef";
 for(size_t i=0;i<bytes;i++){out[2*i]=hex[b[i]>>4];out[2*i+1]=hex[b[i]&15];}out[2*bytes]=0;return 1;
}
/* Emailed link tokens: exactly 64 lowercase hex characters (random_hex(32)). */
static int token_valid(const char *t){
 if(!t||strlen(t)!=64)return 0;
 for(;*t;t++)if(!isdigit((unsigned char)*t)&&(*t<'a'||*t>'f'))return 0;
 return 1;
}
/* Stored form of a link token. Each link type keeps its own salt so stored
   hashes stay valid; the result must use the salt's algorithm. */
#define REVIEW_LINK_SALT "$6$rounds=5000$payreview2026$"
static int token_hash(const char *token,const char *salt,char *out,size_t cap){
 if(!token_valid(token))return 0;
 const char *h=crypt(token,salt);
 if(!h||strncmp(h,salt,3)||strlen(h)>=cap)return 0;
 snprintf(out,cap,"%s",h);return 1;
}
static int session_user(const char *req){
 const char *head=strstr(req,"\r\n\r\n");if(!head)return 0;
 const char *line=req;char token[65]="";
 while(line<head){const char*end=strstr(line,"\r\n");if(!end||end>head)break;
 if((size_t)(end-line)>7&&!strncasecmp(line,"Cookie:",7)){
  const char*c=line+7;while(c<end){while(c<end&&(*c==' '||*c==';'))c++;
   if(end-c>=13&&!strncmp(c,"tc_session=",11)){c+=11;size_t k=0;while(c<end&&*c!=';'&&k<64)token[k++]=*c++;token[k]=0;break;}
   while(c<end&&*c!=';')c++;
  }
 }line=end+2;}
 if(strlen(token)!=64)return 0;
 sqlite3_stmt*q=NULL;int id=0;
 const char*sqltext="SELECT e.id FROM login_sessions s JOIN employees e ON e.id=s.employee_id JOIN user_accounts u ON u.employee_id=e.id JOIN employee_roles r ON r.employee_id=e.id AND r.role='manager' WHERE s.token=?1 AND s.expires_at>CAST(strftime('%s','now') AS INTEGER) AND e.active=1 AND u.disabled=0";
 if(sqlite3_prepare_v2(db,sqltext,-1,&q,NULL)==SQLITE_OK){sqlite3_bind_text(q,1,token,-1,SQLITE_TRANSIENT);if(sqlite3_step(q)==SQLITE_ROW)id=sqlite3_column_int(q,0);}sqlite3_finalize(q);return id;
}
static void send_cookie_response(int fd,int code,const char*cookie,const char*location){
 char h[768];int n=snprintf(h,sizeof h,"HTTP/1.1 %d See Other\r\nLocation: %s\r\nSet-Cookie: tc_session=%s; HttpOnly; SameSite=Strict; Path=/; Max-Age=%d; Secure\r\nContent-Length: 0\r\nCache-Control: no-store\r\nConnection: close\r\n\r\n",code,location,cookie,*cookie?28800:0);
 if(n>0&&(size_t)n<sizeof h)(void)send(fd,h,(size_t)n,0);
}
/* 303 redirect that leaves the session cookie alone. location must be a fixed, trusted path. */
static void send_redirect(int fd,const char*location){
 char h[512];int n=snprintf(h,sizeof h,"HTTP/1.1 303 See Other\r\nLocation: %s\r\nContent-Length: 0\r\nCache-Control: no-store\r\nConnection: close\r\n\r\n",location);
 if(n>0&&(size_t)n<sizeof h)(void)send(fd,h,(size_t)n,0);
}
static int bootstrap_available(void);
/* Sign-in form. A failed attempt returns the same form with the reason in an error banner. */
static void login_page_msg(int fd,int code,const char*error){
 sqlite3_str*o=sqlite3_str_new(db);
 sqlite3_str_appendall(o,UI_HEAD_LOGIN("Sign in")"<form method='post' action='/login'><h1>Sign in</h1><p class='muted'>Manager account</p>");
 if(error&&*error){sqlite3_str_appendall(o,"<p class='banner banner-problem' role='alert'><span class='flag flag-problem'>Problem</span><span>");sqlite3_str_appendall(o,error);sqlite3_str_appendall(o,"</span></p>");}
 sqlite3_str_appendall(o,"<label>Email<input name='email' type='email' autocomplete='username' required></label><label>Password<input name='password' type='password' autocomplete='current-password' required></label><div class='actions'><button>Sign in</button></div></form>" UI_FOOT);
 char*page=sqlite3_str_finish(o);send_response(fd,code,"text/html; charset=utf-8",page?page:"");sqlite3_free(page);
}
static void login_page(int fd){
 if(bootstrap_available()){send_redirect(fd,"/setup");return;}
 login_page_msg(fd,200,NULL);
}
/* Login throttling. Each failed attempt costs a SHA-512 (100k rounds) computation on a
   single-threaded server, so unlimited guessing would also starve swipe ingestion.
   Per-IP: 5 failures per 5 minutes. Global: 20 failures per minute across all IPs. */
#define THROTTLE_SLOTS 64
static struct {uint32_t ip;time_t window_start;int failures;} throttle[THROTTLE_SLOTS];
static time_t global_window;static int global_failures;
static uint32_t current_peer;
static int login_blocked(uint32_t ip){
 time_t now=time(NULL);
 if(now-global_window>=60){global_window=now;global_failures=0;}
 if(global_failures>=20)return 1;
 for(int i=0;i<THROTTLE_SLOTS;i++)if(throttle[i].ip==ip&&throttle[i].failures){
  if(now-throttle[i].window_start>=300){throttle[i].failures=0;return 0;}
  return throttle[i].failures>=5;
 }
 return 0;
}
static void login_failed(uint32_t ip){
 time_t now=time(NULL);int slot=-1,oldest=0;
 global_failures++;
 for(int i=0;i<THROTTLE_SLOTS;i++){
  if(throttle[i].ip==ip&&throttle[i].failures){slot=i;break;}
  if(throttle[i].window_start<throttle[oldest].window_start)oldest=i;
 }
 if(slot<0||now-throttle[slot].window_start>=300){if(slot<0)slot=oldest;throttle[slot].ip=ip;throttle[slot].window_start=now;throttle[slot].failures=0;}
 throttle[slot].failures++;
}
static void login_succeeded(uint32_t ip){for(int i=0;i<THROTTLE_SLOTS;i++)if(throttle[i].ip==ip)throttle[i].failures=0;}
/* Enrollment is mandatory only when no usable manager RFID credential exists.
   No bootstrap bypass is exposed: a signed-in manager must scan a physical card. */
static int manager_card_setup_needed(void){
 sqlite3_stmt *q=NULL;int needed=1;
 const char *query="SELECT 1 FROM manager_cards mc JOIN employees e ON e.id=mc.manager_id JOIN employee_roles r ON r.employee_id=e.id AND r.role='manager' JOIN user_accounts ua ON ua.employee_id=e.id WHERE mc.active=1 AND e.active=1 AND ua.disabled=0 LIMIT 1";
 if(sqlite3_prepare_v2(db,query,-1,&q,NULL)==SQLITE_OK){int rc=sqlite3_step(q);needed=rc!=SQLITE_ROW;}
 sqlite3_finalize(q);return needed;
}
static void login_post_role(int fd,const char*body){
 if(login_blocked(current_peer)){login_page_msg(fd,429,"Too many failed attempts. Wait 5 minutes and try again.");return;}
 char email[220]="",password[256]="";
 if(!form_value(body,"email",email,sizeof email)||!form_value(body,"password",password,sizeof password)||strlen(password)<1){login_page_msg(fd,401,"Email or password is incorrect.");return;}
 sqlite3_stmt*q=NULL;int employee=0;char hash[256]="";
 const char*query="SELECT e.id,u.password_hash FROM employees e JOIN user_accounts u ON u.employee_id=e.id JOIN employee_roles r ON r.employee_id=e.id AND r.role='manager' WHERE e.email=?1 COLLATE NOCASE AND e.active=1 AND u.disabled=0";
 if(sqlite3_prepare_v2(db,query,-1,&q,NULL)==SQLITE_OK){sqlite3_bind_text(q,1,email,-1,SQLITE_TRANSIENT);if(sqlite3_step(q)==SQLITE_ROW){employee=sqlite3_column_int(q,0);const unsigned char*p=sqlite3_column_text(q,1);if(p)snprintf(hash,sizeof hash,"%s",p);}}sqlite3_finalize(q);
 const char*computed=*hash?crypt(password,hash):NULL;
 if(!employee||!computed||strcmp(computed,hash)){login_failed(current_peer);login_page_msg(fd,401,"Email or password is incorrect.");return;}
 login_succeeded(current_peer);
 sql("DELETE FROM login_sessions WHERE expires_at<=CAST(strftime('%s','now') AS INTEGER)");
 char token[65];if(!random_hex(token,32)){login_page_msg(fd,500,"Sign-in failed on the clock. Try again.");return;}
 if(sqlite3_prepare_v2(db,"INSERT INTO login_sessions(token,employee_id,expires_at) VALUES(?1,?2,CAST(strftime('%s','now') AS INTEGER)+28800)",-1,&q,NULL)!=SQLITE_OK){login_page_msg(fd,500,"Sign-in failed on the clock. Try again.");return;}
 sqlite3_bind_text(q,1,token,-1,SQLITE_TRANSIENT);sqlite3_bind_int(q,2,employee);int ok=sqlite3_step(q)==SQLITE_DONE;sqlite3_finalize(q);
 if(!ok){login_page_msg(fd,500,"Sign-in failed on the clock. Try again.");return;}send_cookie_response(fd,303,token,manager_card_setup_needed()?"/manager-cards":"/");
}

static int form_value(const char *body,const char *name,char *dest,size_t cap){
 size_t keylen=strlen(name);
 for(const char *p=body;*p;){
  const char *eq=strchr(p,'=');if(!eq)return 0;
  const char *amp=strchr(eq+1,'&');if(!amp)amp=p+strlen(p);
  if((size_t)(eq-p)==keylen&&!strncmp(p,name,keylen)){
   size_t n=0;
   for(const char *v=eq+1;v<amp;v++){
    unsigned char ch=(unsigned char)*v;
    if(ch=='%'&&v+2<amp&&isxdigit((unsigned char)v[1])&&isxdigit((unsigned char)v[2])){
     char h[3]={v[1],v[2],0};ch=(unsigned char)strtoul(h,NULL,16);v+=2;
    }else if(ch=='+')ch=' ';
    if(ch<32||ch==127||n+1>=cap)return 0;
    dest[n++]=(char)ch;
   }dest[n]=0;return 1;
  }
  p=*amp?amp+1:amp;
 }return 0;
}
static int form_has(const char *body,const char *name){
 size_t n=strlen(name);for(const char *p=body;p&&*p;p=strchr(p,'&')){if(*p=='&')p++;if(!strncmp(p,name,n)&&p[n]=='=')return 1;}return 0;
}
/* Manager-facing configuration and email templates. */
static int form_value_multiline(const char *body,const char *name,char *dest,size_t cap){
 size_t keylen=strlen(name);
 for(const char *p=body;*p;){
  const char *eq=strchr(p,'=');if(!eq)return 0;
  const char *amp=strchr(eq+1,'&');if(!amp)amp=p+strlen(p);
  if((size_t)(eq-p)==keylen&&!strncmp(p,name,keylen)){
   size_t n=0;
   for(const char *v=eq+1;v<amp;v++){
    unsigned char ch=(unsigned char)*v;
    if(ch=='%'&&v+2<amp&&isxdigit((unsigned char)v[1])&&isxdigit((unsigned char)v[2])){
     char h[3]={v[1],v[2],0};ch=(unsigned char)strtoul(h,NULL,16);v+=2;
    }else if(ch=='+')ch=' ';
    if(ch==0||ch==127||(ch<32&&ch!='\n'&&ch!='\r'&&ch!='\t')||n+1>=cap)return 0;
    if(ch=='\r')continue;
    dest[n++]=(char)ch;
   }dest[n]=0;return 1;
  }p=*amp?amp+1:amp;
 }return 0;
}
/* Finish a dynamically built body and send it; 500 on allocation failure. */
static void send_str(int fd,const char *type,sqlite3_str *o){
 int err=sqlite3_str_errcode(o);char *body=sqlite3_str_finish(o);
 /* sqlite3_str_finish returns NULL for an empty string, which is a valid empty body. */
 if(err!=SQLITE_OK)send_response(fd,500,"application/json","{\"error\":\"out of memory\"}");
 else send_response(fd,200,type,body?body:"");
 sqlite3_free(body);
}

/* SMTP configuration is server-side only. Manager GET never returns stored password. */

/* NTP requests are applied by a root-owned systemd helper, never by this server. */
static int ntp_host_valid(const char *s){
 size_t n=strlen(s);if(n<1||n>200||s[0]=='.'||s[n-1]=='.'||s[0]=='-'||s[n-1]=='-')return 0;
 for(size_t i=0;i<n;i++)if(!(isalnum((unsigned char)s[i])||s[i]=='.'||s[i]=='-'||s[i]==':'))return 0;
 return 1;
}
static void ntp_get(int fd){
 char host[220]="",status[250]="";FILE*f=fopen("/var/lib/timeclock/ntp-server.txt","r");
 if(f){if(fgets(host,sizeof host,f))host[strcspn(host,"\r\n")]=0;fclose(f);}
 f=fopen("/var/lib/timeclock/ntp-status.txt","r");if(f){if(fgets(status,sizeof status,f))status[strcspn(status,"\r\n")]=0;fclose(f);}
 /* Both files are written outside this process; str_json escapes whatever they contain. */
 sqlite3_str *j=sqlite3_str_new(db);sqlite3_str_appendall(j,"{\"server\":");json_text(j,host);
 sqlite3_str_appendall(j,",\"status\":");json_text(j,status);
 sqlite3_str_appendf(j,",\"synchronized\":%s}",clock_synced()?"true":"false");send_str(fd,"application/json",j);
}
static void ntp_save(int fd,const char *body){
 char host[220];if(!form_value(body,"server",host,sizeof host)||!ntp_host_valid(host)){
  send_response(fd,400,"application/json","{\"error\":\"Enter one valid NTP hostname or IP address\"}");return;
 }
 const char *tmp="/var/lib/timeclock/ntp-server.tmp",*dst="/var/lib/timeclock/ntp.request";
 int f=open(tmp,O_CREAT|O_TRUNC|O_WRONLY|O_NOFOLLOW,0600);
 if(f<0){send_response(fd,500,"application/json","{\"error\":\"Could not apply the NTP server. Try again.\"}");return;}
 int ok=write(f,host,strlen(host))==(ssize_t)strlen(host)&&write(f,"\n",1)==1&&fsync(f)==0;
 if(close(f)!=0)ok=0;
 if(ok)ok=rename(tmp,dst)==0;else unlink(tmp);
 if(!ok){send_response(fd,500,"application/json","{\"error\":\"Could not apply the NTP server. Try again.\"}");return;}
 send_response(fd,202,"application/json","{\"status\":\"Requested. Applying now.\"}");
}
/* Timezone is separate from NTP. The privileged helper validates and applies it. */
static int timezone_valid(const char *s){
 size_t n=strlen(s);if(n<3||n>95||s[0]=='/'||strstr(s,"..")||!strchr(s,'/'))return 0;
 for(size_t i=0;i<n;i++)if(!(isalnum((unsigned char)s[i])||s[i]=='/'||s[i]=='_'||s[i]=='-'||s[i]=='+'))return 0;
 char path[160];snprintf(path,sizeof path,"/usr/share/zoneinfo/%s",s);
 struct stat st;return lstat(path,&st)==0&&(S_ISREG(st.st_mode)||S_ISLNK(st.st_mode));
}
static void timezone_get(int fd){
 char tz[110]="",status[250]="";
 char link[512];ssize_t n=readlink("/etc/localtime",link,sizeof link-1);
 if(n>0){link[n]=0;const char *prefix="/usr/share/zoneinfo/";char *z=strstr(link,prefix);
  if(z&&z[0]=='/'&&z[strlen(prefix)])snprintf(tz,sizeof tz,"%s",z+strlen(prefix));}
 FILE*f=fopen("/var/lib/timeclock/timezone-status.txt","r");if(f){if(fgets(status,sizeof status,f))status[strcspn(status,"\r\n")]=0;fclose(f);}
 sqlite3_str*j=sqlite3_str_new(db);sqlite3_str_appendall(j,"{\"timezone\":");json_text(j,tz);
 sqlite3_str_appendall(j,",\"status\":");json_text(j,status);sqlite3_str_appendall(j,"}");send_str(fd,"application/json",j);
}
static void ntp_page(int fd){
 send_response(fd,200,"text/html; charset=utf-8",UI_HEAD("Time sync","ntp")
 "<h1>Time sync</h1><p id='syncbanner' role='alert' hidden></p><section><p>The clock refuses punches until its time is synchronized.</p>"
 "<form id='ntp'><label>NTP server hostname or IP<input id='server' maxlength='200' placeholder='time.example.com' required></label><div class='actions'><button>Apply NTP server</button></div>"
 "<p id='state' role='status'>Loading...</p></form><hr><h2>Local timezone</h2><p class='muted'>Used for shift times and daylight saving. Requires a manager card. The clock restarts briefly after approval.</p><form id='tzform'><label>Timezone<select id='timezone' required><option value='America/Edmonton'>Calgary / Edmonton (Mountain Time)</option><option value='America/Vancouver'>Vancouver (Pacific Time)</option><option value='America/Regina'>Regina (Central Time, no daylight saving)</option><option value='America/Winnipeg'>Winnipeg (Central Time)</option><option value='America/Toronto'>Toronto / Ottawa (Eastern Time)</option><option value='America/Halifax'>Halifax (Atlantic Time)</option><option value='America/St_Johns'>St. John’s (Newfoundland Time)</option><option value='America/Whitehorse'>Whitehorse (Yukon Time)</option><option value='America/New_York'>New York (Eastern Time)</option><option value='America/Chicago'>Chicago (Central Time)</option><option value='America/Denver'>Denver (Mountain Time)</option><option value='America/Phoenix'>Phoenix (Mountain Time, no daylight saving)</option><option value='America/Los_Angeles'>Los Angeles (Pacific Time)</option><option value='Europe/London'>London (UK Time)</option><option value='Etc/UTC'>UTC</option></select></label><div class='actions'><button>Apply timezone</button></div><p id='tzstate' role='status'>Loading...</p></form></section>"
 "<script>const ntp=document.getElementById('ntp'),server=document.getElementById('server'),state=document.getElementById('state'),syncbanner=document.getElementById('syncbanner'),timezone=document.getElementById('timezone'),tzform=document.getElementById('tzform'),tzstate=document.getElementById('tzstate');async function load(){try{let r=await tc.request('/api/v1/admin/ntp');let j=await tc.json(r);if(r.ok){if(document.activeElement!==server)server.value=j.server||'';state.textContent=j.status||'Not configured';tc.banner(syncbanner,'problem','Problem',j.synchronized?'':'Clock time is not synchronized. Punches are refused until it is.');}else tc.err(state,j.error);}catch(e){tc.err(state,e)}}"
 "ntp.onsubmit=async e=>{e.preventDefault();state.textContent='Requesting change...';try{let r=await tc.request('/api/v1/admin/ntp',{method:'POST',headers:{'Content-Type':'application/x-www-form-urlencoded'},body:new URLSearchParams({server:server.value})});let j=await tc.json(r);if(r.ok)state.textContent=j.status;else tc.err(state,j.error||'Request failed');}catch(e){tc.err(state,e)}};async function loadTz(){try{let r=await tc.request('/api/v1/admin/timezone');let j=await tc.json(r);if(r.ok){if(document.activeElement!==timezone){let zone=j.timezone||'';if(zone&&!Array.from(timezone.options).some(o=>o.value===zone))timezone.add(new Option(zone,zone));timezone.value=zone;}tzstate.textContent=j.status||'';}else tc.err(tzstate,j.error);}catch(e){tc.err(tzstate,e)}}tzform.onsubmit=async e=>{e.preventDefault();tzstate.textContent=tc.CARD;try{let r=await tc.request('/api/v1/admin/system/arm',{method:'POST',headers:{'Content-Type':'application/x-www-form-urlencoded'},body:new URLSearchParams({action:'timezone',timezone:timezone.value})});let j=await tc.json(r);if(!r.ok)throw Error(j.error||'Approval failed');let x=await tc.card('/api/v1/admin/system/status',j.token);tc.ok(tzstate,x.status||'Requested');}catch(e){tc.err(tzstate,e)}};load();loadTz();setInterval(()=>{if(!document.hidden){load();loadTz()}},5000)</script>"UI_FOOT);
}

static void smtp_config_get(int fd){
 sqlite3_stmt*q=NULL;sqlite3_str*j=sqlite3_str_new(db);sqlite3_str_appendall(j,"{");
 const char *a[]={"url","username","tls_mode","sender","sender_name"};
 int ok=sqlite3_prepare_v2(db,"SELECT url,username,tls_mode,sender,sender_name,length(password)>0 FROM smtp_settings WHERE id=1",-1,&q,NULL)==SQLITE_OK;
 if(ok&&sqlite3_step(q)==SQLITE_ROW){
  for(int i=0;i<5;i++){if(i)sqlite3_str_appendall(j,",");sqlite3_str_appendf(j,"\"%s\":",a[i]);json_text(j,(const char*)sqlite3_column_text(q,i));}
  sqlite3_str_appendf(j,",\"has_password\":%s",sqlite3_column_int(q,5)?"true":"false");
 }else sqlite3_str_appendall(j,"\"url\":\"\",\"username\":\"\",\"tls_mode\":\"starttls\",\"sender\":\"\",\"sender_name\":\"\",\"has_password\":false");
 sqlite3_finalize(q);
 sqlite3_str_appendall(j,"}");send_str(fd,"application/json",j);
}
static int smtp_clean(const char*s,size_t max){
 if(strlen(s)>max)return 0;
 for(;*s;s++)if((unsigned char)*s<32||(unsigned char)*s==127)return 0;
 return 1;
}
static void smtp_config_save(int fd,const char*b){
 char url[260]="",user[260]="",password[260]="",tls[20]="",sender[260]="",sender_name[260]="",clear[8]="";
 if(!form_value(b,"url",url,sizeof url)||!form_value(b,"username",user,sizeof user)||
    !form_value(b,"password",password,sizeof password)||!form_value(b,"tls_mode",tls,sizeof tls)||
    (form_has(b,"sender_name")&&!form_value(b,"sender_name",sender_name,sizeof sender_name))||!form_value(b,"sender",sender,sizeof sender)||!form_value(b,"clear_password",clear,sizeof clear)){
  send_response(fd,400,"application/json","{\"error\":\"Fill in all required fields.\"}");return;
 }
 int scheme=!strncmp(url,"smtp://",7)?1:!strncmp(url,"smtps://",8)?2:0;
 if(!smtp_clean(url,250)||!smtp_clean(user,200)||!smtp_clean(password,240)||!smtp_clean(sender,200)||!smtp_clean(sender_name,200)||
    (url[0]&&!scheme)||(sender[0]&&!email_address_ok(sender))||
    (strcmp(tls,"none")&&strcmp(tls,"starttls")&&strcmp(tls,"implicit"))||
    (scheme==2&&strcmp(tls,"implicit"))||(scheme==1&&!strcmp(tls,"implicit"))||
    (!strcmp(tls,"none")&&user[0])||strchr(url,'@')||strchr(url,'?')||strchr(url,'#')){
   send_response(fd,400,"application/json","{\"error\":\"Check the server name, port and sender address.\"}");return;
 }
 sqlite3_stmt*q=NULL;const char*query=
 "INSERT INTO smtp_settings(id,url,username,password,tls_mode,sender,sender_name) VALUES(1,?1,?2,?3,?4,?5,?7) "
 "ON CONFLICT(id) DO UPDATE SET url=excluded.url,username=excluded.username,"
 "password=CASE WHEN ?6='1' THEN '' WHEN ?3<>'' THEN ?3 ELSE smtp_settings.password END,"
 "tls_mode=excluded.tls_mode,sender=excluded.sender,sender_name=excluded.sender_name";
 int ok=sqlite3_prepare_v2(db,query,-1,&q,NULL)==SQLITE_OK;
 if(ok){sqlite3_bind_text(q,1,url,-1,SQLITE_TRANSIENT);sqlite3_bind_text(q,2,user,-1,SQLITE_TRANSIENT);
 sqlite3_bind_text(q,3,password,-1,SQLITE_TRANSIENT);sqlite3_bind_text(q,4,tls,-1,SQLITE_TRANSIENT);
 sqlite3_bind_text(q,5,sender,-1,SQLITE_TRANSIENT);sqlite3_bind_text(q,6,clear,-1,SQLITE_TRANSIENT);sqlite3_bind_text(q,7,sender_name,-1,SQLITE_TRANSIENT);
 ok=sqlite3_step(q)==SQLITE_DONE;}
 sqlite3_finalize(q);send_response(fd,ok?200:500,"application/json",ok?"{\"status\":\"saved\"}":"{\"error\":\"save failed\"}");
}
static void smtp_test_enqueue(int fd,const char *body){
 char recipient[260]="";
 if(!form_value(body,"recipient",recipient,sizeof recipient)||!email_address_ok(recipient)){
  send_response(fd,400,"application/json","{\"error\":\"Enter a valid email address.\"}");return;
 }
 int ok=email_enqueue(db,recipient,"Timeclock: Test email","Test message from mk-timeclock. Outgoing email works.",NULL,NULL)>0;
 send_response(fd,ok?200:500,"application/json",ok?"{\"status\":\"queued\"}":"{\"error\":\"queue failed\"}");
}
static void smtp_config_page(int fd){
 send_response(fd,200,"text/html; charset=utf-8",
 UI_HEAD("Outgoing email","smtp")"<h1>Outgoing email</h1><p>Mail server for notices, timesheet links, payroll reports and backups.</p><p id='smtpbanner' role='alert' hidden></p><section><form id='settings'>"
 "<h2>Outgoing server</h2>"
 "<label>SMTP server<input id='host' placeholder='smtp.example.com' required></label>"
 "<label>Port<input id='port' type='number' min='1' max='65535' value='587' required></label>"
 "<label>Connection security<select id='tls_mode'><option value='starttls'>STARTTLS (port 587)</option><option value='implicit'>SSL/TLS (port 465)</option><option value='none'>None (trusted network or VPN)</option></select></label>"
 "<h2>Account</h2><label>Username (blank if the server needs no sign-in)<input id='username' autocomplete='username'></label>"
 "<label>Password (blank keeps saved password)<input id='password' type='password' autocomplete='new-password'></label>"
 "<p class='muted' id='stored'></p><label><input id='clear_password' type='checkbox'> Remove saved password</label>"
 "<h2>Sender</h2><label>Sender name (optional)<input id='sender_name' maxlength='200' placeholder='iCube Development Timeclock'></label><label>From email address<input id='sender' type='email' autocomplete='email' placeholder='timeclock@example.com' required></label>"
 "<div class='actions'><button>Save email settings</button></div><p id='status' role='status'></p></form></section>"
 "<section><h2>Send a test email</h2><p class='muted'>Check <a href='/email-queue'>Email queue</a> for the result.</p>"
 "<form id='test'><label>Send to<input id='recipient' type='email' required></label><div class='actions'><button>Send test email</button></div><p id='result' role='status'></p></form></section>"
 "<script>const api=tc.api;"
 "const byId=id=>document.getElementById(id);let loading=false;"
 "function defaultPort(mode){return mode==='implicit'?'465':mode==='none'?'25':'587'}"
 "function newUrl(){const host=byId('host').value.trim(),port=Number(byId('port').value),mode=byId('tls_mode').value;"
 "if(!host||/[\\s\\/?#@]/.test(host)||host.includes(':')||!Number.isInteger(port)||port<1||port>65535)throw Error('Enter a valid server name or IPv4 address, and a port from 1 to 65535.');"
 "return (mode==='implicit'?'smtps://':'smtp://')+host+':'+port;}"
 "async function load(){let d=await api('/api/v1/admin/smtp');byId('tls_mode').value=d.tls_mode||'starttls';"
 "let host='',port=defaultPort(byId('tls_mode').value);if(d.url){try{let u=new URL(d.url);host=u.hostname;port=u.port||((u.protocol==='smtps:')?'465':'25');}catch(e){tc.err(byId('status'),'The saved server address is not valid. Enter it again.');}}"
 "byId('host').value=host;byId('port').value=port;byId('sender').value=d.sender||'';byId('sender_name').value=d.sender_name||'';byId('username').value=d.username||'';"
 "byId('stored').textContent=d.has_password?'Password saved. Leave blank to keep it.':'No password saved.';"
 "tc.banner(byId('smtpbanner'),'problem','Problem',d.url&&d.sender?'':'No mail server set. No email is sent.');}"
 "byId('tls_mode').onchange=()=>{const p=byId('port');if(['25','465','587'].includes(p.value))p.value=defaultPort(byId('tls_mode').value);};"
 "byId('settings').onsubmit=async e=>{e.preventDefault();const status=byId('status');try{let p=new URLSearchParams();"
 "p.set('url',newUrl());for(let f of ['tls_mode','sender','sender_name','username','password'])p.set(f,byId(f).value);p.set('clear_password',byId('clear_password').checked?'1':'0');"
 "status.textContent='Saving...';await api('/api/v1/admin/smtp',{method:'POST',headers:{'Content-Type':'application/x-www-form-urlencoded'},body:p});"
 "byId('password').value='';byId('clear_password').checked=false;tc.ok(status,'Saved. New messages use these settings.');await load();}catch(e){tc.err(status,e);}};"
 "byId('test').onsubmit=async e=>{e.preventDefault();try{await api('/api/v1/admin/smtp-test',{method:'POST',headers:{'Content-Type':'application/x-www-form-urlencoded'},body:new URLSearchParams({recipient:byId('recipient').value})});"
 "tc.ok(byId('result'),'Test queued. Check Email queue for the result.');}catch(e){tc.err(byId('result'),e);}};"
 "load().catch(e=>tc.err(byId('status'),e));</script>"UI_FOOT);
}

static int tls_stage_write(const char *name,const char *data){
 char path[180];snprintf(path,sizeof path,"/var/lib/timeclock/tls-stage/%s",name);
 int fd=open(path,O_WRONLY|O_CREAT|O_TRUNC|O_CLOEXEC|O_NOFOLLOW,0600);
 if(fd<0)return 0;
 size_t len=strlen(data);ssize_t n=write(fd,data,len);int ok=n==(ssize_t)len&&fsync(fd)==0;close(fd);return ok;
}
static void tls_upload(int fd,const char *body){
 char cert[9000],chain[9000],key[9000],hostname[260];
 if(!form_value_multiline(body,"cert",cert,sizeof cert)||!form_value_multiline(body,"chain",chain,sizeof chain)||!form_value_multiline(body,"key",key,sizeof key)||!form_value(body,"hostname",hostname,sizeof hostname)){
  send_response(fd,400,"application/json","{\"error\":\"Choose the certificate and key files (each under 9 KB).\"}");return;
 }
 if(strncmp(cert,"-----BEGIN CERTIFICATE-----",27)||strncmp(key,"-----BEGIN ",11)||(!strstr(key,"PRIVATE KEY-----"))||!valid_id(hostname,250)||strchr(hostname,':')){
  send_response(fd,400,"application/json","{\"error\":\"The certificate, key or hostname is not valid.\"}");return;
 }
 if(chain[0]&&strncmp(chain,"-----BEGIN CERTIFICATE-----",27)){
  send_response(fd,400,"application/json","{\"error\":\"The intermediate chain file is not valid.\"}");return;
 }
 if(mkdir("/var/lib/timeclock/tls-stage",0700)&&errno!=EEXIST){send_response(fd,500,"application/json","{\"error\":\"Could not start the check. Try again.\"}");return;}
 int ok=tls_stage_write("leaf.pem",cert)&&tls_stage_write("chain.pem",chain)&&tls_stage_write("key.pem",key)&&tls_stage_write("hostname",hostname);
 memset(key,0,sizeof key);
 if(ok)ok=tls_stage_write("request","apply\n");
 send_response(fd,ok?202:500,"application/json",ok?"{\"status\":\"staged\",\"message\":\"Checking certificate\"}":"{\"error\":\"Could not start the check. Try again.\"}");
}
static void tls_status(int fd){
 FILE*f=fopen("/var/lib/timeclock/tls-stage/status","r");char status[360]="Not configured";
 if(f){if(!fgets(status,sizeof status,f))status[0]=0;fclose(f);}
 size_t n=strlen(status);while(n&&(status[n-1]=='\n'||status[n-1]=='\r'))status[--n]=0;
 sqlite3_str*o=sqlite3_str_new(db);sqlite3_str_appendall(o,"{\"enabled\":");sqlite3_str_appendall(o,access("/etc/timeclock/tls/active",F_OK)==0?"true":"false");sqlite3_str_appendall(o,",\"status\":");json_text(o,status);sqlite3_str_appendf(o,",\"expires\":%lld,\"temporary\":%s}",tls_not_after(),tls_temporary()?"true":"false");send_str(fd,"application/json",o);
}
static void tls_page(int fd){send_response(fd,200,"text/html; charset=utf-8",
 UI_HEAD("HTTPS certificate","tls")"<h1>HTTPS certificate</h1><p>The clock checks that the key matches, the hostname is covered and the chain is trusted before it switches over. A failed check keeps the current certificate.</p><p id='tlsbanner' role='alert' hidden></p>"
 "<section><h2>Current certificate</h2><p id='tlsstate' role='status'>Loading...</p></section>"
 "<section><h2>Replace certificate</h2><form id='tlsform'><label>Certificate hostname<input id='hostname' required placeholder='clock.example.com'></label><label>Certificate (.pem)<input type='file' id='cert' accept='.pem,.crt,.cer' required></label><label>Intermediate chain (.pem, leave empty if signed directly by a root)<input type='file' id='chain' accept='.pem,.crt,.cer'></label><label>Private key (.pem)<input type='file' id='key' accept='.pem,.key' required></label><div class='actions'><button>Check and install</button></div><p id='tlsresult' role='status'></p></form></section>"
 "<section><h2>Employee email links</h2><p id='linkeffective' role='status'></p></section>"
 "<script>const out=document.getElementById('tlsresult'),state=document.getElementById('tlsstate'),banner=document.getElementById('tlsbanner');let poll=null;"
 "async function refresh(){try{let r=await tc.request('/api/v1/admin/tls/status',{cache:'no-store'});let j=await tc.json(r);if(!r.ok)throw Error(j.error||'Status unavailable');"
 "state.replaceChildren();let days=j.expires?Math.floor((j.expires*1000-Date.now())/86400000):null;"
 "if(!j.enabled){tc.banner(banner,'problem','Problem','HTTPS is not active. Install a certificate below.');}"
 "else if(j.temporary){tc.banner(banner,'problem','Problem','Temporary self-signed certificate. Browsers show a warning and employee links may not open. Install a trusted certificate below.');}"
 "else if(days!==null&&days<7){tc.banner(banner,'problem','Problem','Certificate expires in '+Math.max(days,0)+(days===1?' day':' days')+'. Replace it now.');}"
 "else if(days!==null&&days<30){tc.banner(banner,'check','Check','Certificate expires in '+days+' days.');}else tc.banner(banner,'','','');"
 "if(j.enabled)state.append(tc.flag('Active','ok'),' ');else state.append('None installed.');if(j.expires)state.append('Valid until '+new Date(j.expires*1000).toISOString().slice(0,10)+'. ');"
 "let last=String(j.status||'');if(/^Failed/.test(last))tc.err(out,'Last upload: '+last);else if(/^Validating/.test(last))out.textContent=last+'...';"
 "clearTimeout(poll);if(/^Validating/.test(last))poll=setTimeout(refresh,3000);}catch(e){tc.err(state,e)}}"
 "document.getElementById('tlsform').onsubmit=async e=>{e.preventDefault();let p=new URLSearchParams({hostname:document.getElementById('hostname').value});for(let id of ['cert','chain','key']){let file=document.getElementById(id).files[0];p.set(id,file?await file.text():'')}if(p.toString().length>24000){tc.err(out,'The files are larger than 24 KB. Check that each file holds only one certificate or key.');return}if(!await tc.ask({title:'Replace the HTTPS certificate?',ok:'Replace certificate'}))return;try{let r=await tc.request('/api/v1/admin/tls/upload',{method:'POST',headers:{'Content-Type':'application/x-www-form-urlencoded'},body:p});let j=await tc.json(r);if(!r.ok)throw Error(j.error||'Upload failed');out.textContent='Checking certificate...';setTimeout(refresh,2000)}catch(e){tc.err(out,e)}};refresh();"
 "async function loadLink(){let field=document.getElementById('linkeffective');try{let r=await tc.request('/api/v1/admin/note-link',{cache:'no-store'});let j=await tc.json(r);if(!r.ok)throw Error(j.error||'Unavailable');field.replaceChildren();"
 "if(!j.effective){field.append(tc.flag('Problem','problem'),' No hostname. Employee links cannot be sent.');return}"
 "field.append('Late-arrival and timesheet links use '+j.effective+' ');if(j.source!=='certificate')field.append(tc.flag('Check','check'),' Not the certificate hostname. Employees may see a certificate warning.')}catch(e){tc.err(field,e)}}loadLink();</script>"UI_FOOT);
}
static void email_retry(int fd,int who,const char *body){
 char id[30]="";if(!form_value(body,"id",id,sizeof id)){reply_incomplete(fd);return;}
 for(const char *c=id;*c;c++)if(*c<'0'||*c>'9'){reply_incomplete(fd);return;}
 if(!begin_change(fd))return;
 sqlite3_stmt*q=NULL;int ok=sqlite3_prepare_v2(db,"UPDATE email_queue SET status='pending',next_attempt=strftime('%Y-%m-%dT%H:%M:%fZ','now'),attempts=0,last_error='' WHERE id=?1 AND status='failed'",-1,&q,NULL)==SQLITE_OK;
 if(ok){sqlite3_bind_int64(q,1,atoll(id));ok=sqlite3_step(q)==SQLITE_DONE&&sqlite3_changes(db)==1;}
 sqlite3_finalize(q);q=NULL;
 if(ok&&sqlite3_prepare_v2(db,"INSERT INTO email_retry_audit(email_id,manager_id) VALUES(?1,?2)",-1,&q,NULL)==SQLITE_OK){sqlite3_bind_int64(q,1,atoll(id));sqlite3_bind_int(q,2,who);ok=sqlite3_step(q)==SQLITE_DONE;}else ok=0;sqlite3_finalize(q);
 if(ok)ok=sql("COMMIT");else sql("ROLLBACK");
 send_response(fd,ok?200:409,"application/json",ok?"{\"status\":\"queued\"}":"{\"error\":\"Could not retry. Reload the page; the email may already be queued.\"}");
}
/* Clock acknowledgements are durable: the agent deletes its local copy on HTTP 200.
   synchronous is connection-local and must be changed outside a transaction. */
static int clock_durability(int full){
 return sql(full ? "PRAGMA synchronous=FULL" : "PRAGMA synchronous=NORMAL");
}
static void rejected_upload_receive(int fd,const char *body){
 char event[45]="",clock[55]="",uid[32]="",swiped[48]="",rejected[48]="",status[8]="";
 if(!form_value(body,"event_id",event,sizeof event)||!form_value(body,"clock_id",clock,sizeof clock)||!form_value(body,"card_uid",uid,sizeof uid)||!form_value(body,"swiped_at",swiped,sizeof swiped)||!form_value(body,"rejected_at",rejected,sizeof rejected)||!form_value(body,"http_status",status,sizeof status)||strlen(event)!=32||!valid_id(clock,48)||!valid_id(uid,24)||strlen(swiped)<19||strlen(rejected)<19){send_response(fd,400,"application/json","{\"error\":\"invalid rejected event\"}");return;}
 for(int i=0;i<32;i++)if(!((event[i]>='a'&&event[i]<='f')||(event[i]>='0'&&event[i]<='9'))){send_response(fd,400,"application/json","{\"error\":\"invalid event id\"}");return;}
 for(const char*c=status;*c;c++)if(*c<'0'||*c>'9'){send_response(fd,400,"application/json","{\"error\":\"invalid status\"}");return;}
 int code=atoi(status);if(code!=400&&code!=409&&code!=422){send_response(fd,400,"application/json","{\"error\":\"invalid status\"}");return;}
 if(!clock_durability(1)){send_response(fd,503,"application/json","{\"error\":\"durability unavailable\"}");return;}
 sqlite3_stmt*q=NULL;int ok=sqlite3_prepare_v2(db,"INSERT INTO rejected_uploads(event_id,clock_id,card_uid,swiped_at,http_status,reason,rejected_at) VALUES(?1,?2,?3,?4,?5,'server rejected event',?6) ON CONFLICT(event_id) DO NOTHING",-1,&q,NULL)==SQLITE_OK;
 if(ok){sqlite3_bind_text(q,1,event,-1,SQLITE_TRANSIENT);sqlite3_bind_text(q,2,clock,-1,SQLITE_TRANSIENT);sqlite3_bind_text(q,3,uid,-1,SQLITE_TRANSIENT);sqlite3_bind_text(q,4,swiped,-1,SQLITE_TRANSIENT);sqlite3_bind_int(q,5,code);sqlite3_bind_text(q,6,rejected,-1,SQLITE_TRANSIENT);ok=sqlite3_step(q)==SQLITE_DONE;} sqlite3_finalize(q);
 if(!clock_durability(0))fprintf(stderr,"cannot restore normal synchronous mode after rejected event\n");
 send_response(fd,ok?200:500,"application/json",ok?"{\"status\":\"recorded\"}":"{\"error\":\"The clock could not complete this. Try again.\"}");
}
static void rejected_upload_list(int fd){
 sqlite3_stmt*q=NULL;if(sqlite3_prepare_v2(db,"SELECT event_id,clock_id,card_uid,swiped_at,http_status,reason,rejected_at FROM (SELECT event_id,clock_id,card_uid,swiped_at,http_status,reason,rejected_at,received_at FROM rejected_uploads UNION ALL SELECT s.event_id,s.clock_id,s.card_uid,s.swiped_at,200,'Out of order: retained but excluded from attendance; reconcile manually',s.received_at,s.received_at FROM swipes s JOIN attendance_events a ON a.event_id=s.event_id WHERE a.exception='out_of_order') ORDER BY received_at DESC LIMIT 200",-1,&q,NULL)!=SQLITE_OK){reply_failed(fd);return;}
 sqlite3_str*o=sqlite3_str_new(db);sqlite3_str_appendall(o,"{\"rejected_uploads\":[");int count=0,rc;
 while((rc=sqlite3_step(q))==SQLITE_ROW){if(count++)sqlite3_str_appendchar(o,1,',');sqlite3_str_appendall(o,"{");const char*names[]={"event_id","clock_id","card_uid","swiped_at","reason","rejected_at"};int cols[]={0,1,2,3,5,6};for(int i=0;i<6;i++){if(i)sqlite3_str_appendchar(o,1,',');json_text(o,names[i]);sqlite3_str_appendchar(o,1,':');json_text(o,(const char*)sqlite3_column_text(q,cols[i]));}sqlite3_str_appendf(o,",\"http_status\":%d}",sqlite3_column_int(q,4));}
 sqlite3_finalize(q);if(rc!=SQLITE_DONE){sqlite3_free(sqlite3_str_finish(o));reply_failed(fd);return;}sqlite3_str_appendall(o,"]}");send_str(fd,"application/json",o);
}
static void template_list(int fd){
 sqlite3_stmt*q=NULL;
 if(sqlite3_prepare_v2(db,"SELECT id,subject,body,enabled FROM email_templates ORDER BY id",-1,&q,NULL)!=SQLITE_OK){reply_failed(fd);return;}
 sqlite3_str *o=sqlite3_str_new(db);sqlite3_str_appendall(o,"{\"templates\":[");int first=1;
 while(sqlite3_step(q)==SQLITE_ROW){
  if(!find_template_default((const char*)sqlite3_column_text(q,0)))continue;
  if(!first)sqlite3_str_appendchar(o,1,',');
  first=0;
  sqlite3_str_appendall(o,"{\"id\":");json_text(o,(const char*)sqlite3_column_text(q,0));
  sqlite3_str_appendall(o,",\"subject\":");json_text(o,(const char*)sqlite3_column_text(q,1));
  sqlite3_str_appendall(o,",\"body\":");json_text(o,(const char*)sqlite3_column_text(q,2));
  sqlite3_str_appendf(o,",\"enabled\":%d}",sqlite3_column_int(q,3));
 }
 sqlite3_finalize(q);sqlite3_str_appendall(o,"]}");send_str(fd,"application/json",o);
}
static void template_default_get(int fd,const char *body){
 char id[80];
 if(!form_value(body,"id",id,sizeof id)){reply_incomplete(fd);return;}
 const email_template_default *t=find_template_default(id);
 if(!t){send_response(fd,404,"application/json","{\"error\":\"Request incomplete. Reload the page and try again.\"}");return;}
 sqlite3_str *o=sqlite3_str_new(db);
 sqlite3_str_appendall(o,"{\"id\":");json_text(o,t->id);
 sqlite3_str_appendall(o,",\"subject\":");json_text(o,t->subject);
 sqlite3_str_appendall(o,",\"body\":");json_text(o,t->body);
 sqlite3_str_appendall(o,",\"enabled\":true}");send_str(fd,"application/json",o);
}
static int authorization_pending(void);
static int approval_token_new(char out[33]);
static int approval_token_matches(const char *body);
/* Manager-card approval shared by every change that needs a card tap.
   approval_begin: open the transaction and refuse while another approval is open.
   Returns 1 inside the transaction; otherwise the error response has been sent. */
static int approval_begin(int fd){
 if(!begin_change(fd))return 0;
 if(authorization_pending()){
  sql("ROLLBACK");
  send_response(fd,409,"application/json","{\"error\":\"The card reader is waiting for another approval. Try again in 30 seconds.\"}");
  return 0;
 }
 return 1;
}
/* Save the pending change for a card-approved settings table (one row, id=1). */
static int approval_save(const char *table,int who,const char *change){
 char *q=sqlite3_mprintf("INSERT INTO %s(id,requested_by,change_body,armed_at) VALUES(1,?1,?2,CAST(strftime('%%s','now') AS INTEGER)) "
                         "ON CONFLICT(id) DO UPDATE SET requested_by=excluded.requested_by,change_body=excluded.change_body,armed_at=excluded.armed_at",table);
 int ok=q&&db_run(db,q,"it",who,change)>=0;
 sqlite3_free(q);return ok;
}
/* approval_finish: after the caller saved its pending request (ok=1), arm the
   reader for approval, issue the polling token, commit and reply. */
static void approval_finish(int fd,int ok){
 char token[33]="";
 if(ok)ok=sql("UPDATE manager_scan SET armed_at=CAST(strftime('%s','now') AS INTEGER),uid='',scanned_at=0,scan_mode='approval' WHERE id=1");
 if(ok)ok=approval_token_new(token);
 if(ok)ok=sql("COMMIT");else sql("ROLLBACK");
 if(!ok){reply_failed(fd);return;}
 char reply[96];snprintf(reply,sizeof reply,"{\"status\":\"waiting\",\"token\":\"%s\"}",token);
 send_response(fd,200,"application/json",reply);
}
static void template_restore_arm(int fd,int who,const char *body){
 char id[80];if(!form_value(body,"id",id,sizeof id)||!find_template_default(id)){reply_incomplete(fd);return;}
 if(!approval_begin(fd))return;
 char op[120];snprintf(op,sizeof op,"TEMPLATE_RESTORE:%s",id);
 approval_finish(fd,approval_save("manager_authorization",who,op));
}
static void template_restore_status(int fd,int who){
 sqlite3_stmt*q=NULL;char op[130]="",uid[32]="";sqlite3_int64 armed=0,scanned=0;int owner=0;
 if(sqlite3_prepare_v2(db,"SELECT a.requested_by,a.change_body,a.armed_at,s.uid,s.scanned_at FROM manager_authorization a JOIN manager_scan s ON s.id=1 WHERE a.id=1",-1,&q,NULL)==SQLITE_OK&&sqlite3_step(q)==SQLITE_ROW){
 owner=sqlite3_column_int(q,0);const char*v=(const char*)sqlite3_column_text(q,1);if(v)snprintf(op,sizeof op,"%s",v);armed=sqlite3_column_int64(q,2);const char*u=(const char*)sqlite3_column_text(q,3);if(u)snprintf(uid,sizeof uid,"%s",u);scanned=sqlite3_column_int64(q,4);
 }sqlite3_finalize(q);
 if(owner!=who||strncmp(op,"TEMPLATE_RESTORE:",17)||!armed){send_response(fd,409,"application/json","{\"error\":\"This approval is no longer valid. Start again.\"}");return;}
 if((sqlite3_int64)time(NULL)-armed>30){sql("DELETE FROM manager_authorization WHERE id=1");send_response(fd,200,"application/json","{\"status\":\"expired\"}");return;}
 if(!uid[0]||scanned<armed){send_response(fd,200,"application/json","{\"status\":\"waiting\"}");return;}
 int authorized=0;
 if(sqlite3_prepare_v2(db,"SELECT 1 FROM manager_cards mc JOIN employees e ON e.id=mc.manager_id JOIN user_accounts ua ON ua.employee_id=e.id JOIN employee_roles er ON er.employee_id=e.id AND er.role='manager' WHERE mc.uid=?1 COLLATE NOCASE AND mc.active=1 AND e.active=1 AND ua.disabled=0",-1,&q,NULL)==SQLITE_OK){sqlite3_bind_text(q,1,uid,-1,SQLITE_TRANSIENT);authorized=sqlite3_step(q)==SQLITE_ROW;}sqlite3_finalize(q);
 if(!authorized){sql("UPDATE manager_scan SET uid='',scanned_at=0 WHERE id=1");send_response(fd,200,"application/json","{\"status\":\"waiting\"}");return;}
 const email_template_default*t=find_template_default(op+17);int ok=t!=NULL;
 if(!begin_change(fd))return;
 if(ok&&sqlite3_prepare_v2(db,"UPDATE email_templates SET subject=?1,body=?2 WHERE id=?3",-1,&q,NULL)==SQLITE_OK){sqlite3_bind_text(q,1,t->subject,-1,SQLITE_STATIC);sqlite3_bind_text(q,2,t->body,-1,SQLITE_STATIC);sqlite3_bind_text(q,3,t->id,-1,SQLITE_STATIC);ok=sqlite3_step(q)==SQLITE_DONE&&sqlite3_changes(db)==1;}else ok=0;sqlite3_finalize(q);q=NULL;
 if(ok&&sqlite3_prepare_v2(db,"INSERT INTO template_restore_audit(template_id,manager_id,approved_uid) VALUES(?1,?2,?3)",-1,&q,NULL)==SQLITE_OK){sqlite3_bind_text(q,1,t->id,-1,SQLITE_STATIC);sqlite3_bind_int(q,2,who);sqlite3_bind_text(q,3,uid,-1,SQLITE_TRANSIENT);ok=sqlite3_step(q)==SQLITE_DONE;}else ok=0;sqlite3_finalize(q);
 if(ok)ok=sql("DELETE FROM manager_authorization WHERE id=1")&&sql("UPDATE manager_scan SET armed_at=0,uid='',scanned_at=0,request_token='' WHERE id=1");
 if(ok)ok=sql("COMMIT");else sql("ROLLBACK");send_response(fd,ok?200:500,"application/json",ok?"{\"status\":\"restored\"}":"{\"error\":\"Default not restored. Try again.\"}");
}
static void template_save(int fd,const char *body){
 char id[80],subject[260],content[2400],enabled[4];
 if(!form_value(body,"id",id,sizeof id)||!form_value(body,"subject",subject,sizeof subject)||!form_value_multiline(body,"body",content,sizeof content)||!form_value(body,"enabled",enabled,sizeof enabled)||
    !valid_id(id,64)||!find_template_default(id)||!subject[0]||!content[0]||(strcmp(enabled,"0")&&strcmp(enabled,"1"))){
  send_response(fd,400,"application/json","{\"error\":\"Template not saved. Try again.\"}");return;
 }
 for(const unsigned char*p=(const unsigned char*)subject;*p;p++)if(*p<32||*p==127){send_response(fd,400,"application/json","{\"error\":\"Enter a subject of up to 240 characters.\"}");return;}
 sqlite3_stmt*q=NULL;int ok=sqlite3_prepare_v2(db,"UPDATE email_templates SET subject=?1,body=?2,enabled=?3 WHERE id=?4",-1,&q,NULL)==SQLITE_OK;
 if(ok){sqlite3_bind_text(q,1,subject,-1,SQLITE_TRANSIENT);sqlite3_bind_text(q,2,content,-1,SQLITE_TRANSIENT);sqlite3_bind_int(q,3,enabled[0]=='1');sqlite3_bind_text(q,4,id,-1,SQLITE_TRANSIENT);ok=sqlite3_step(q)==SQLITE_DONE&&sqlite3_changes(db)==1;}
 sqlite3_finalize(q);send_response(fd,ok?200:400,"application/json",ok?"{\"status\":\"saved\"}":"{\"error\":\"Template not saved. Try again.\"}");
}
static void template_page(int fd){
 static const char html[]=
 UI_HEAD("Email templates","templates")"<h1>Email templates</h1><p>No IN and No OUT notices are sent after the scheduled start or finish plus the late grace.</p><section><label>Template<select id='picker'></select></label><form id='editor'><label>Subject<input id='subject' maxlength='240' required></label><label>Message body<textarea id='body' maxlength='2300' required></textarea></label><label><input type='checkbox' id='enabled'> Send this email</label><div class='actions'><button type='submit'>Save template</button><button class='secondary' type='button' id='previewDefault'>Show default</button><button class='secondary' type='button' id='restoreDefault'>Restore default</button></div><p id='status' role='status'></p></form></section>"
 "<section id='defaultPreview' hidden><h2>Default text</h2><label>Subject<input id='defaultSubject' readonly></label><label>Message body<textarea id='defaultBody' readonly></textarea></label></section><section><h2>Variables</h2><p id='variables' class='muted'></p></section>"
 "<script>const editor=document.getElementById('editor'),enabled=document.getElementById('enabled'),subject=document.getElementById('subject');let rows=[];let picker=document.getElementById('picker'),status=document.getElementById('status');"
 "const api=tc.api;"
 "const variables={clock_offline_manager:'{{clock_name}}, {{clock_id}}, {{last_contact}}, {{backlog}}',clock_recovered_manager:'{{clock_name}}, {{clock_id}}, {{last_contact}}, {{backlog}}',daily_attendance_employee:'{{employee_name}}, {{attendance_date}}, {{daily_summary}}, {{period_start}}, {{period_end}}, {{review_link}}',early_departure_employee:'{{employee_name}}, {{scheduled_end}}, {{actual_end}}, {{early_minutes}}, {{attendance_date}}, {{note_link}} (the employee adds a reason here)',early_departure_manager:'{{employee_name}}, {{scheduled_end}}, {{actual_end}}, {{early_minutes}}, {{attendance_date}}',late_arrival_employee:'{{employee_name}}, {{scheduled_start}}, {{actual_start}}, {{late_minutes}}, {{attendance_date}}, {{note_link}} (the employee adds a reason here)',late_arrival_manager:'{{employee_name}}, {{scheduled_start}}, {{actual_start}}, {{late_minutes}}, {{attendance_date}}',missing_in_employee:'{{employee_name}}, {{scheduled_start}}, {{attendance_date}}',missing_out_employee:'{{employee_name}}, {{scheduled_end}}, {{attendance_date}}',attendance_report:'{{payday}}, {{period_start}}, {{period_end}}, {{attendance_summary}}',welcome_employee:'{{employee_name}}, {{timeoff_link}}',auto_review_employee:'{{employee_name}}, {{period_start}}, {{period_end}}, {{review_link}}, {{missing_punch_note}}',review_dispatch_payroll:'{{period_start}}, {{period_end}}, {{sent_count}}',timeoff_received_employee:'{{employee_name}}, {{request_type}}, {{period_start}}, {{period_end}}, {{days}}, {{days_label}}, {{return_date}}',timeoff_received_manager:'{{employee_name}}, {{request_type}}, {{period_start}}, {{period_end}}, {{days}}, {{return_date}}, {{note}}',timeoff_decision_employee:'{{request_type}}, {{employee_name}}, {{period_start}}, {{period_end}}, {{decision}}, {{manager_name}}, {{note}}',timeoff_cancelled_employee:'{{request_type}}, {{employee_name}}, {{period_start}}, {{period_end}}, {{manager_name}}, {{note}}',email_failure_payroll:'{{recipient}}, {{failed_subject}}'};function show(){let t=rows.find(x=>x.id===picker.value);if(!t)return;document.getElementById('variables').textContent=variables[t.id]||'';subject.value=t.subject;document.getElementById('body').value=t.body;enabled.checked=!!t.enabled;document.getElementById('status').textContent='';}"
 "const labels={clock_offline_manager:'Clock not reporting (manager)',clock_recovered_manager:'Clock reconnected (manager)',daily_attendance_employee:'Daily attendance summary',early_departure_employee:'Early departure (employee)',early_departure_manager:'Early departure (manager)',late_arrival_employee:'Late arrival (employee)',late_arrival_manager:'Late arrival (manager)',missing_in_employee:'No IN punch (employee)',missing_out_employee:'No OUT punch (employee)',attendance_report:'Payroll report',welcome_employee:'Employee welcome',timeoff_received_employee:'Vacation request received (employee)',timeoff_received_manager:'Vacation request received (manager)',timeoff_decision_employee:'Vacation approved or denied',timeoff_cancelled_employee:'Vacation approval cancelled',auto_review_employee:'Timesheet link',review_dispatch_payroll:'Timesheet links queued (payroll)',email_failure_payroll:'Email delivery failure (payroll)'};"
 "async function load(keep){try{let j=await api('/api/v1/admin/templates');rows=j.templates;picker.replaceChildren();for(let t of rows){let o=document.createElement('option');o.value=t.id;o.textContent=(labels[t.id]||t.id.replaceAll('_',' '))+(!t.enabled?' (off)':'');picker.append(o);}if(keep)picker.value=keep;show();}catch(e){tc.err(document.getElementById('status'),e);}}"
 "picker.onchange=()=>{document.getElementById('defaultPreview').hidden=true;show();};"
 "document.getElementById('previewDefault').onclick=async()=>{let id=picker.value;try{let j=await api('/api/v1/admin/templates/default?id='+encodeURIComponent(id));if(picker.value!==id)return;document.getElementById('defaultSubject').value=j.subject;document.getElementById('defaultBody').value=j.body;document.getElementById('defaultPreview').hidden=false;status.textContent='Default shown below. Your template is unchanged.';}catch(e){tc.err(status,e);}};"
 "document.getElementById('restoreDefault').onclick=async()=>{let id=picker.value;if(!await tc.ask({title:'Restore the default subject and body?',text:'Your changes to this template will be lost.',ok:'Restore default'}))return;try{let armed=await api('/api/v1/admin/templates/restore/arm',{method:'POST',headers:{'Content-Type':'application/x-www-form-urlencoded'},body:new URLSearchParams({id}).toString()});status.textContent=tc.CARD;await tc.card('/api/v1/admin/templates/restore/status',armed.token);await load(id);document.getElementById('defaultPreview').hidden=true;tc.ok(status,'Default restored.');}catch(e){tc.err(status,e);}};"
 "editor.onsubmit=async e=>{e.preventDefault();let id=picker.value,p=new URLSearchParams({id,subject:subject.value,body:document.getElementById('body').value,enabled:enabled.checked?'1':'0'});try{await api('/api/v1/admin/templates',{method:'POST',headers:{'Content-Type':'application/x-www-form-urlencoded'},body:p.toString()});await load(id);tc.ok(document.getElementById('status'),'Template saved.');}catch(e){tc.err(document.getElementById('status'),e);}};load();</script>"UI_FOOT;
 send_response(fd,200,"text/html; charset=utf-8",html);
}
static void trim_spaces(char *s){size_t n=strlen(s),a=0;while(a<n&&s[a]==' ')a++;while(n>a&&s[n-1]==' ')n--;memmove(s,s+a,n-a);s[n-a]=0;}
/* First name, last name and position are required on every employee save. Checked when the
   change is armed (so a missing field never uses a manager card scan) and again when applied.
   Returns NULL when valid, otherwise a JSON error body. Limits are bytes (UTF-8). */
static const char *employee_identity_error(const char *body,char *first,size_t fc,char *last,size_t lc,char *position,size_t pc){
 if(!form_value(body,"first_name",first,fc)||!form_value(body,"last_name",last,lc)||!form_value(body,"position",position,pc))
  return "{\"error\":\"First name, last name and position are required. No card scan was requested.\"}";
 trim_spaces(first);trim_spaces(last);trim_spaces(position);
 if(!first[0])return "{\"error\":\"First name is required. No card scan was requested.\"}";
 if(!last[0])return "{\"error\":\"Last name is required. No card scan was requested.\"}";
 if(!position[0])return "{\"error\":\"Position is required. No card scan was requested.\"}";
 return NULL;
}
#include "employee_number.h"
static void management_list(int fd){
 sqlite3_stmt*q=NULL;
 const char *query="SELECT e.id,e.name,coalesce(e.email,''),e.active,coalesce((SELECT group_concat(uid,',') FROM cards WHERE employee_id=e.id AND active=1),''),coalesce((SELECT group_concat(uid,',') FROM manager_cards WHERE manager_id=e.id AND active=1),''),EXISTS(SELECT 1 FROM employee_roles WHERE employee_id=e.id AND role='manager'),e.late_email_enabled,e.first_name,e.last_name,e.position,(trim(e.first_name)='' OR trim(e.last_name)='' OR trim(e.position)=''),e.phone,EXISTS(SELECT 1 FROM schedule_profiles sp WHERE sp.employee_id=e.id),EXISTS(SELECT 1 FROM schedule_profiles sp WHERE sp.employee_id=e.id AND sp.schedule_mode='none'),e.auto_review_enabled,e.attendance_mode,e.vacation_days,e.employee_number FROM employees e ORDER BY e.last_name COLLATE NOCASE,e.first_name COLLATE NOCASE,e.id";
 if(sqlite3_prepare_v2(db,query,-1,&q,NULL)!=SQLITE_OK){reply_failed(fd);return;}
 sqlite3_str *o=sqlite3_str_new(db);sqlite3_str_appendall(o,"{\"employees\":[");int first=1;
 while(sqlite3_step(q)==SQLITE_ROW){
  if(!first)sqlite3_str_appendchar(o,1,',');
  first=0;
  sqlite3_str_appendf(o,"{\"id\":%d,\"name\":",sqlite3_column_int(q,0));json_text(o,(const char*)sqlite3_column_text(q,1));
  sqlite3_str_appendall(o,",\"email\":");json_text(o,(const char*)sqlite3_column_text(q,2));
  sqlite3_str_appendf(o,",\"active\":%d,\"cards\":",sqlite3_column_int(q,3));json_text(o,(const char*)sqlite3_column_text(q,4));
  sqlite3_str_appendall(o,",\"manager_cards\":");json_text(o,(const char*)sqlite3_column_text(q,5));
  sqlite3_str_appendf(o,",\"manager\":%d,\"late_email_enabled\":%d,\"first_name\":",sqlite3_column_int(q,6),sqlite3_column_int(q,7));json_text(o,(const char*)sqlite3_column_text(q,8));
  sqlite3_str_appendall(o,",\"last_name\":");json_text(o,(const char*)sqlite3_column_text(q,9));
  sqlite3_str_appendall(o,",\"position\":");json_text(o,(const char*)sqlite3_column_text(q,10));
  sqlite3_str_appendf(o,",\"incomplete\":%s,\"phone\":",sqlite3_column_int(q,11)?"true":"false");json_text(o,(const char*)sqlite3_column_text(q,12));sqlite3_str_appendf(o,",\"has_schedule\":%s,\"schedule_exempt\":%s,\"auto_review_enabled\":%s,\"attendance_mode\":\"%s\"",sqlite3_column_int(q,13)?"true":"false",sqlite3_column_int(q,14)?"true":"false",sqlite3_column_int(q,15)?"true":"false",sqlite3_column_text(q,16));
  char number[65];employee_number(db,sqlite3_column_int(q,0),number,sizeof number);sqlite3_str_appendall(o,",\"employee_number\":");json_text(o,(const char*)sqlite3_column_text(q,18));sqlite3_str_appendall(o,",\"display_id\":");json_text(o,number);
  if(sqlite3_column_type(q,17)==SQLITE_NULL)sqlite3_str_appendall(o,",\"vacation_days\":null}");else sqlite3_str_appendf(o,",\"vacation_days\":%g}",sqlite3_column_double(q,17));
 }
 sqlite3_finalize(q);sqlite3_str_appendall(o,"]}");send_str(fd,"application/json",o);
}
static int op_admin_change(int fd,const char *body,int who);
/* Every employee welcome message uses the same durable email_queue and SMTP mailer. */
/* Welcome email (template welcome_employee). {{timeoff_link}} becomes the HTTPS
   time-off page; with no hostname the standard sentence asks the employee to see
   their manager. Returns 1 when queued or not applicable, 0 on error (or, for a
   manual resend, when the template is off). */
static int welcome_enqueue_ex(long employee_id,int manual){
 char email[260]="",first[160]="",display[200]="";
 sqlite3_stmt *q=db_prepare(db,"SELECT coalesce(email,''),coalesce(first_name,''),name FROM employees WHERE id=?1 AND active=1 AND (?2=1 OR (welcomed_at IS NULL AND created_at IS NOT NULL AND julianday('now')-julianday(created_at) BETWEEN 0 AND 7))",
  "Ii",(long long)employee_id,manual);
 if(!q)return 0;
 int eligible=sqlite3_step(q)==SQLITE_ROW;
 if(eligible){
  snprintf(email,sizeof email,"%s",col_text(q,0));
  snprintf(first,sizeof first,"%s",col_text(q,1));
  snprintf(display,sizeof display,"%s",col_text(q,2));
 }
 sqlite3_finalize(q);
 if(!eligible||!email_address_ok(email))return 1;
 char base[270]="",link[300]="";note_link_base(base,sizeof base);
 if(base[0])snprintf(link,sizeof link,"%s/time-off",base);
 struct email_field fields[3];size_t n=0;
 if(!base[0])fields[n++]=(struct email_field){"To request vacation, visit {{timeoff_link}}.","Ask your manager to request vacation."};
 fields[n++]=(struct email_field){"{{employee_name}}",first[0]?first:display};
 fields[n++]=(struct email_field){"{{timeoff_link}}",base[0]?link:"your manager"};
 char subject[220]="",message[2400]="";
 int rendered=template_render(db,"welcome_employee",fields,n,subject,sizeof subject,message,sizeof message);
 if(rendered==0)return manual?0:1;
 if(rendered<0)return 0;
 char key[120];
 if(manual){char token[33];if(!random_hex(token,16))return 0;snprintf(key,sizeof key,"welcome:%ld:resend:%s",employee_id,token);}
 else snprintf(key,sizeof key,"welcome:%ld",employee_id);
 if(email_enqueue(db,email,subject,message,key,NULL)<0)return 0;
 if(manual)return 1;
 return db_run(db,"UPDATE employees SET welcomed_at=strftime('%Y-%m-%dT%H:%M:%fZ','now') WHERE id=?1 AND welcomed_at IS NULL","I",(long long)employee_id)==1;
}
static int welcome_enqueue(long employee_id){return welcome_enqueue_ex(employee_id,0);}
/* Manager-only resend; reuses the normal SMTP queue and records the requester. */
static void welcome_resend(int fd,int who,const char *body){
 if(who<=0){send_response(fd,401,"application/json","{\"error\":\"Sign in again.\"}");return;}
 char value[24]="";if(!form_value(body,"id",value,sizeof value)){send_response(fd,400,"application/json","{\"error\":\"Select an employee.\"}");return;}
 char *end=NULL;long id=strtol(value,&end,10);
 if(id<=0||!end||*end){send_response(fd,400,"application/json","{\"error\":\"Invalid employee.\"}");return;}
 sqlite3_stmt*q=NULL;int eligible=0,pending=0;
 if(sqlite3_prepare_v2(db,"SELECT 1 FROM employees WHERE id=?1 AND active=1 AND email LIKE '%@%' AND instr(email,' ')=0",-1,&q,NULL)==SQLITE_OK){sqlite3_bind_int64(q,1,id);eligible=sqlite3_step(q)==SQLITE_ROW;}sqlite3_finalize(q);
 if(!eligible){send_response(fd,409,"application/json","{\"error\":\"Employee must be active and have an email address.\"}");return;}
 if(sqlite3_prepare_v2(db,"SELECT 1 FROM email_queue WHERE (event_id=?1 OR event_id LIKE ?1 || ':%') AND status='pending' LIMIT 1",-1,&q,NULL)==SQLITE_OK){char pattern[80];snprintf(pattern,sizeof pattern,"welcome:%ld",id);sqlite3_bind_text(q,1,pattern,-1,SQLITE_TRANSIENT);pending=sqlite3_step(q)==SQLITE_ROW;}sqlite3_finalize(q);
 if(pending){send_response(fd,200,"application/json","{\"status\":\"already_pending\"}");return;}
 if(!sql("BEGIN IMMEDIATE")){send_response(fd,500,"application/json","{\"error\":\"Could not queue message.\"}");return;}
 int ok=1;
 q=NULL;if(sqlite3_prepare_v2(db,"SELECT 1 FROM email_queue WHERE (event_id=?1 OR event_id LIKE ?1 || ':%') AND status='pending' LIMIT 1",-1,&q,NULL)==SQLITE_OK){char pattern[80];snprintf(pattern,sizeof pattern,"welcome:%ld",id);sqlite3_bind_text(q,1,pattern,-1,SQLITE_TRANSIENT);if(sqlite3_step(q)==SQLITE_ROW)ok=0;}sqlite3_finalize(q);
 if(!ok){sql("ROLLBACK");send_response(fd,200,"application/json","{\"status\":\"already_pending\"}");return;}
 ok=welcome_enqueue_ex(id,1);
 if(ok){q=NULL;ok=sqlite3_prepare_v2(db,"INSERT INTO employee_change_audit(manager_id,employee_id,change_body) VALUES(?1,?2,'Resent welcome email')",-1,&q,NULL)==SQLITE_OK;if(ok){sqlite3_bind_int(q,1,who);sqlite3_bind_int64(q,2,id);ok=sqlite3_step(q)==SQLITE_DONE;}sqlite3_finalize(q);}
 if(ok)ok=sql("COMMIT");else sql("ROLLBACK");
 if(ok)send_response(fd,200,"application/json","{\"status\":\"queued\"}");else send_response(fd,500,"application/json","{\"error\":\"Welcome message could not be queued. Check the email template.\"}");
}
static void management_save(int fd,const char *body,int who,int direct){
 if(op_admin_change(fd,body,who))return;
 char id_s[20]="",first[130]="",last[130]="",position[170]="",name[264]="",email[220]="",active[8]="",manager[8]="",uid[80]="",late_email[8]="",auto_review[8]="1",phone[48]="",attendance_mode[24]="punch_required",vacation[24]="";
 char number[65]="";int number_present=form_has(body,"employee_number");
 if(number_present){
  if(!form_value(body,"employee_number",number,sizeof number)){send_response(fd,400,"application/json","{\"error\":\"Employee ID is too long.\"}");return;}
  size_t begin=0,end=strlen(number);while(begin<end&&isspace((unsigned char)number[begin]))begin++;while(end>begin&&isspace((unsigned char)number[end-1]))end--;memmove(number,number+begin,end-begin);number[end-begin]=0;
  for(size_t i=0;number[i];i++)if((unsigned char)number[i]<32||(unsigned char)number[i]==127){send_response(fd,400,"application/json","{\"error\":\"Employee ID cannot contain control characters.\"}");return;}
 }
 int vacation_present=form_has(body,"vacation_days");double vacation_days=0;
 if(vacation_present&&!form_value(body,"vacation_days",vacation,sizeof vacation)){send_response(fd,400,"application/json","{\"error\":\"Check the vacation allowance.\"}");return;}
 if(vacation_present&&*vacation){
  char *end=NULL;vacation_days=strtod(vacation,&end);
  if(!end||*end||strspn(vacation,"0123456789.")!=strlen(vacation)||!(vacation_days>=0&&vacation_days<=366)||vacation_days*2!=(int)(vacation_days*2)){
   send_response(fd,400,"application/json","{\"error\":\"Vacation allowance needs whole or half days from 0 to 366, or leave it blank.\"}");return;
  }
 }
 const char *identity=employee_identity_error(body,first,sizeof first,last,sizeof last,position,sizeof position);
 if(identity){send_response(fd,400,"application/json",identity);return;}
 snprintf(name,sizeof name,"%s %s",first,last);
 if(!form_value(body,"id",id_s,sizeof id_s)||!form_value(body,"email",email,sizeof email)||!form_value(body,"phone",phone,sizeof phone)||!form_value(body,"active",active,sizeof active)||!form_value(body,"manager",manager,sizeof manager)||!form_value(body,"uid",uid,sizeof uid)||!form_value(body,"late_email_enabled",late_email,sizeof late_email)){
  send_response(fd,400,"application/json","{\"error\":\"Check the entries and try again.\"}");return;
 }
 if(form_value(body,"attendance_mode",attendance_mode,sizeof attendance_mode) && strcmp(attendance_mode,"punch_required") && strcmp(attendance_mode,"vacation_only")){send_response(fd,400,"application/json","{\"error\":\"Invalid attendance mode.\"}");return;}
 if(!strcmp(attendance_mode,"vacation_only"))uid[0]=0;
 if(form_value(body,"auto_review_enabled",auto_review,sizeof auto_review) && strcmp(auto_review,"0") && strcmp(auto_review,"1")){send_response(fd,400,"application/json","{\"error\":\"Check the review email setting.\"}");return;}
 if(email[0]&&!email_address_ok(email)){
  send_response(fd,400,"application/json","{\"error\":\"Enter a valid email address.\"}");return;
 }
 /* Allow international phone formats; store as text to preserve + and extensions. */
 int digits=0;
 for(size_t i=0;phone[i];i++){
  unsigned char c=(unsigned char)phone[i];
  if(isdigit(c))digits++;
  else if(!(c=='+'||c=='-'||c=='('||c==')'||c==' '||c=='.'||c=='x'||c=='X')){
   send_response(fd,400,"application/json","{\"error\":\"Enter a valid phone number.\"}");return;
  }
 }
 if(phone[0]&&(digits<7||digits>15)){
  send_response(fd,400,"application/json","{\"error\":\"Phone numbers need 7 to 15 digits.\"}");return;
 }
 char *tail=NULL;long id=strtol(id_s,&tail,10);
 if(!*id_s||*tail||id<0||id>2147483647||(strcmp(active,"0")&&strcmp(active,"1"))||(strcmp(manager,"0")&&strcmp(manager,"1"))||(strcmp(late_email,"0")&&strcmp(late_email,"1"))){
  send_response(fd,400,"application/json","{\"error\":\"Check the entries and try again.\"}");return;
 }
 for(size_t i=0;uid[i];i++){if(!isxdigit((unsigned char)uid[i])){send_response(fd,400,"application/json","{\"error\":\"Enter a card UID of 8 to 20 hexadecimal characters.\"}");return;}uid[i]=(char)toupper((unsigned char)uid[i]);}
 if(uid[0]&&strlen(uid)!=8&&strlen(uid)!=14&&strlen(uid)!=20){send_response(fd,400,"application/json","{\"error\":\"Enter a card UID of 8 to 20 hexadecimal characters.\"}");return;}
 /* Validate card ownership before modifying any employee or role. */
 if(uid[0]){
  sqlite3_stmt *v=NULL;int rc=SQLITE_ERROR;
  if(sqlite3_prepare_v2(db,"SELECT manager_id FROM manager_cards WHERE uid=?1 COLLATE NOCASE",-1,&v,NULL)==SQLITE_OK){sqlite3_bind_text(v,1,uid,-1,SQLITE_TRANSIENT);rc=sqlite3_step(v);}sqlite3_finalize(v);
  if(rc==SQLITE_ROW){send_response(fd,409,"application/json","{\"error\":\"That card is a manager card. Use a different card.\"}");return;}
  if(rc!=SQLITE_DONE){send_response(fd,500,"application/json","{\"error\":\"Could not check the card. Try again.\"}");return;}
  v=NULL;rc=SQLITE_ERROR;long owner=0;int card_active=0;
  if(sqlite3_prepare_v2(db,"SELECT employee_id,active FROM cards WHERE uid=?1 COLLATE NOCASE",-1,&v,NULL)==SQLITE_OK){sqlite3_bind_text(v,1,uid,-1,SQLITE_TRANSIENT);rc=sqlite3_step(v);if(rc==SQLITE_ROW){owner=sqlite3_column_int64(v,0);card_active=sqlite3_column_int(v,1);}}sqlite3_finalize(v);
  if(rc==SQLITE_ROW&&owner!=id){send_response(fd,409,"application/json","{\"error\":\"That card belongs to another employee. Nothing was changed.\"}");return;}
  if(rc==SQLITE_ROW&&!card_active){send_response(fd,409,"application/json","{\"error\":\"Use Reactivate under Cards with your manager card. Nothing was changed.\"}");return;}
  if(rc!=SQLITE_ROW&&rc!=SQLITE_DONE){send_response(fd,500,"application/json","{\"error\":\"Could not check the card. Try again.\"}");return;}
 }
 if(!sql("BEGIN IMMEDIATE")){send_response(fd,500,"application/json","{\"error\":\"The clock is busy. Try again.\"}");return;}

 int ok=1;sqlite3_stmt *q=NULL;sqlite3_int64 allocated=0;
 if(id==0&&!*number){
  /* Walk sorted numeric reservations once; leading-zero company IDs remain
     distinct text and do not reserve a different numeric fallback. */
  ok=sqlite3_prepare_v2(db,"SELECT max(coalesce(max(id),0),0)+1 FROM employees",-1,&q,NULL)==SQLITE_OK;
  if(ok){ok=sqlite3_step(q)==SQLITE_ROW;}if(ok){allocated=sqlite3_column_int64(q,0);ok=allocated>0&&allocated<=2147483647;}sqlite3_finalize(q);q=NULL;
  if(ok)ok=sqlite3_prepare_v2(db,"SELECT cast(employee_number AS INTEGER) FROM employees WHERE cast(cast(employee_number AS INTEGER) AS TEXT)=employee_number AND cast(employee_number AS INTEGER)>=?1 ORDER BY cast(employee_number AS INTEGER)",-1,&q,NULL)==SQLITE_OK;
  if(ok){sqlite3_bind_int64(q,1,allocated);int rc;while((rc=sqlite3_step(q))==SQLITE_ROW){sqlite3_int64 reserved=sqlite3_column_int64(q,0);if(reserved>allocated)break;if(reserved==allocated)allocated++;}ok=(rc==SQLITE_ROW||rc==SQLITE_DONE)&&allocated>0&&allocated<=2147483647;}sqlite3_finalize(q);q=NULL;
  if(!ok){sql("ROLLBACK");send_response(fd,409,"application/json","{\"error\":\"No clock Employee ID is available. Enter a company Employee ID.\"}");return;}
 }
 if(id==0){ok=sqlite3_prepare_v2(db,"INSERT INTO employees(id,name,email,active,late_email_enabled,first_name,last_name,position,phone,attendance_mode,created_at) VALUES(?10,?1,?2,?3,?4,?6,?7,?8,?9,?11,strftime('%Y-%m-%dT%H:%M:%fZ','now'))",-1,&q,NULL)==SQLITE_OK;}
 else {ok=sqlite3_prepare_v2(db,"UPDATE employees SET name=?1,email=?2,active=?3,late_email_enabled=?4,first_name=?6,last_name=?7,position=?8,phone=?9 WHERE id=?5",-1,&q,NULL)==SQLITE_OK;}
 if(ok){sqlite3_bind_text(q,1,name,-1,SQLITE_TRANSIENT);sqlite3_bind_text(q,2,email,-1,SQLITE_TRANSIENT);sqlite3_bind_int(q,3,active[0]=='1');sqlite3_bind_int(q,4,late_email[0]=='1');if(id)sqlite3_bind_int(q,5,(int)id);sqlite3_bind_text(q,6,first,-1,SQLITE_TRANSIENT);sqlite3_bind_text(q,7,last,-1,SQLITE_TRANSIENT);sqlite3_bind_text(q,8,position,-1,SQLITE_TRANSIENT);sqlite3_bind_text(q,9,phone,-1,SQLITE_TRANSIENT);if(id==0){if(allocated)sqlite3_bind_int64(q,10,allocated);else sqlite3_bind_null(q,10);sqlite3_bind_text(q,11,attendance_mode,-1,SQLITE_TRANSIENT);}ok=sqlite3_step(q)==SQLITE_DONE&&(id==0||sqlite3_changes(db)==1);}
 sqlite3_finalize(q);if(id==0&&ok)id=sqlite3_last_insert_rowid(db);
 if(ok){sqlite3_stmt*mode=NULL;ok=sqlite3_prepare_v2(db,"UPDATE employees SET attendance_mode=?1 WHERE id=?2",-1,&mode,NULL)==SQLITE_OK;if(ok){sqlite3_bind_text(mode,1,attendance_mode,-1,SQLITE_TRANSIENT);sqlite3_bind_int64(mode,2,id);ok=sqlite3_step(mode)==SQLITE_DONE;}sqlite3_finalize(mode);}
 if(ok&&number_present){sqlite3_stmt *n=NULL;ok=sqlite3_prepare_v2(db,"UPDATE employees SET employee_number=?1 WHERE id=?2",-1,&n,NULL)==SQLITE_OK;if(ok){sqlite3_bind_text(n,1,number,-1,SQLITE_TRANSIENT);sqlite3_bind_int64(n,2,id);ok=sqlite3_step(n)==SQLITE_DONE;}sqlite3_finalize(n);}
 /* Reject collisions with either another company ID or an internal-ID fallback. */
 if(ok){sqlite3_stmt *n=NULL;int duplicate=0;ok=sqlite3_prepare_v2(db,"SELECT EXISTS(SELECT 1 FROM employees a JOIN employees b ON " EMPLOYEE_NUMBER_SQL("a") "=" EMPLOYEE_NUMBER_SQL("b") " COLLATE NOCASE WHERE a.id=?1 AND b.id<>a.id)",-1,&n,NULL)==SQLITE_OK;if(ok){sqlite3_bind_int64(n,1,id);ok=sqlite3_step(n)==SQLITE_ROW;if(ok)duplicate=sqlite3_column_int(n,0);}sqlite3_finalize(n);if(duplicate){sql("ROLLBACK");send_response(fd,409,"application/json","{\"error\":\"Employee ID is already used by another employee. Choose a different ID.\"}");return;}}
 if(ok&&vacation_present){sqlite3_stmt *allowance=NULL;ok=sqlite3_prepare_v2(db,"UPDATE employees SET vacation_days=?1 WHERE id=?2",-1,&allowance,NULL)==SQLITE_OK;if(ok){if(*vacation)sqlite3_bind_double(allowance,1,vacation_days);else sqlite3_bind_null(allowance,1);sqlite3_bind_int64(allowance,2,id);ok=sqlite3_step(allowance)==SQLITE_DONE;}sqlite3_finalize(allowance);}
 if(ok){sqlite3_stmt*pref=NULL;ok=sqlite3_prepare_v2(db,"UPDATE employees SET auto_review_enabled=?1 WHERE id=?2",-1,&pref,NULL)==SQLITE_OK;if(ok){sqlite3_bind_int(pref,1,auto_review[0]=='1');sqlite3_bind_int64(pref,2,id);ok=sqlite3_step(pref)==SQLITE_DONE;}sqlite3_finalize(pref);}
 if(ok){ok=sqlite3_prepare_v2(db,"DELETE FROM employee_roles WHERE employee_id=?1 AND role='manager'",-1,&q,NULL)==SQLITE_OK;if(ok){sqlite3_bind_int64(q,1,id);ok=sqlite3_step(q)==SQLITE_DONE;}sqlite3_finalize(q);}
 if(ok&&manager[0]=='1'){ok=sqlite3_prepare_v2(db,"INSERT INTO employee_roles(employee_id,role) VALUES(?1,'manager')",-1,&q,NULL)==SQLITE_OK;if(ok){sqlite3_bind_int64(q,1,id);ok=sqlite3_step(q)==SQLITE_DONE;}sqlite3_finalize(q);}
 /* Refuse manager cards and cards assigned to a different employee. */
 if(ok&&uid[0]){
  ok=sqlite3_prepare_v2(db,"SELECT 1 FROM manager_cards WHERE uid=?1 COLLATE NOCASE",-1,&q,NULL)==SQLITE_OK;
  if(ok){sqlite3_bind_text(q,1,uid,-1,SQLITE_TRANSIENT);ok=sqlite3_step(q)!=SQLITE_ROW;}sqlite3_finalize(q);q=NULL;
 }
 if(ok&&uid[0]){
  ok=sqlite3_prepare_v2(db,"SELECT employee_id FROM cards WHERE uid=?1 COLLATE NOCASE",-1,&q,NULL)==SQLITE_OK;
  if(ok){sqlite3_bind_text(q,1,uid,-1,SQLITE_TRANSIENT);int rc=sqlite3_step(q);if(rc==SQLITE_ROW)ok=sqlite3_column_int64(q,0)==id;else ok=rc==SQLITE_DONE;}sqlite3_finalize(q);q=NULL;
 }
 /* Additive card registration: preserve every other card assigned to this employee. */
 if(ok&&uid[0]){
  ok=sqlite3_prepare_v2(db,"INSERT INTO cards(uid,employee_id,active) VALUES(?1,?2,1) ON CONFLICT(uid) DO UPDATE SET employee_id=excluded.employee_id,active=1",-1,&q,NULL)==SQLITE_OK;
  if(ok){sqlite3_bind_text(q,1,uid,-1,SQLITE_TRANSIENT);sqlite3_bind_int64(q,2,id);ok=sqlite3_step(q)==SQLITE_DONE;}sqlite3_finalize(q);
  /* The card is now assigned; drop it from the unassigned-sightings list. */
  if(ok){ok=sqlite3_prepare_v2(db,"DELETE FROM unknown_cards WHERE uid=?1",-1,&q,NULL)==SQLITE_OK;if(ok){sqlite3_bind_text(q,1,uid,-1,SQLITE_TRANSIENT);ok=sqlite3_step(q)==SQLITE_DONE;}sqlite3_finalize(q);}
 }
 if(ok){
  /* All administrative edits must preserve at least one usable manager card. */
  int count=0;
  const char *guard="SELECT COUNT(*) FROM manager_cards mc JOIN employees e ON e.id=mc.manager_id JOIN employee_roles er ON er.employee_id=e.id AND er.role='manager' JOIN user_accounts ua ON ua.employee_id=e.id WHERE mc.active=1 AND e.active=1 AND ua.disabled=0";
  ok=sqlite3_prepare_v2(db,guard,-1,&q,NULL)==SQLITE_OK;
  if(ok){if(sqlite3_step(q)==SQLITE_ROW)count=sqlite3_column_int(q,0);else ok=0;}
  sqlite3_finalize(q);q=NULL;
  if(ok&&count<1)ok=0;
 }
 if(ok&&direct){
  sqlite3_stmt *audit=NULL;
  ok=sqlite3_prepare_v2(db,"INSERT INTO employee_change_audit(manager_id,employee_id,change_body) VALUES(?1,?2,?3)",-1,&audit,NULL)==SQLITE_OK;
  if(ok){sqlite3_bind_int(audit,1,who);sqlite3_bind_int64(audit,2,id);sqlite3_bind_text(audit,3,body,-1,SQLITE_TRANSIENT);ok=sqlite3_step(audit)==SQLITE_DONE;}
  sqlite3_finalize(audit);
 }
 if(ok)ok=welcome_enqueue(id);
 if(ok){if(!sql("COMMIT")){sql("ROLLBACK");ok=0;}}else sql("ROLLBACK");
 if(ok){char reply[64];snprintf(reply,sizeof reply,"{\"status\":\"saved\",\"id\":%ld}",id);send_response(fd,200,"application/json",reply);}
 else send_response(fd,409,"application/json","{\"error\":\"Not saved. The card may already be assigned.\"}");
}
/* A one-use authorization request carries the proposed employee change in SQLite.
   A known, active manager card must be scanned after the request is armed. */
/* Exclusive scanner lease: tested inside BEGIN IMMEDIATE for every workflow. */
/* Unique per-operation browser token, not an alternative to physical manager authorization. */
static int approval_token_new(char out[33]){
 if(!random_hex(out,16))return 0;
 sqlite3_stmt*q=NULL;int ok=sqlite3_prepare_v2(db,"UPDATE manager_scan SET request_token=?1 WHERE id=1",-1,&q,NULL)==SQLITE_OK;
 if(ok){sqlite3_bind_text(q,1,out,-1,SQLITE_TRANSIENT);ok=sqlite3_step(q)==SQLITE_DONE;}sqlite3_finalize(q);return ok;
}
static int approval_token_matches(const char *body){
 char token[64]="";if(!body||!form_value(body,"token",token,sizeof token)||strlen(token)!=32)return 0;
 sqlite3_stmt*q=NULL;int ok=0;
 if(sqlite3_prepare_v2(db,"SELECT 1 FROM manager_scan WHERE request_token=?1 AND armed_at>0",-1,&q,NULL)==SQLITE_OK){sqlite3_bind_text(q,1,token,-1,SQLITE_TRANSIENT);ok=sqlite3_step(q)==SQLITE_ROW;}sqlite3_finalize(q);return ok;
}
static int authorization_pending(void){
 sqlite3_stmt *q=NULL;int busy=1;
 const char *query="SELECT (SELECT count(*) FROM manager_authorization WHERE armed_at>=CAST(strftime('%s','now') AS INTEGER)-30)+(SELECT count(*) FROM schedule_authorization WHERE armed_at>=CAST(strftime('%s','now') AS INTEGER)-30)+(SELECT count(*) FROM payroll_authorization WHERE armed_at>=CAST(strftime('%s','now') AS INTEGER)-30)+(SELECT count(*) FROM system_actions WHERE armed_at>=CAST(strftime('%s','now') AS INTEGER)-30)+(SELECT count(*) FROM account_authorization WHERE armed_at>=CAST(strftime('%s','now') AS INTEGER)-30)";
 if(sqlite3_prepare_v2(db,query,-1,&q,NULL)==SQLITE_OK && sqlite3_step(q)==SQLITE_ROW)busy=sqlite3_column_int(q,0)>0;
 sqlite3_finalize(q);return busy;
}
/* Routine employee enrollment and edits: authenticated manager only.
   Role and activation changes are still handled by card-authorized workflow. */
static void employee_save_routine(int fd,int who,const char *body){
 if(who<=0){send_response(fd,401,"application/json","{\"error\":\"Sign in again.\"}");return;}
 if(!body||strlen(body)>3500){reply_incomplete(fd);return;}
 char forbidden_op[40]="";if(form_value(body,"op",forbidden_op,sizeof forbidden_op)){send_response(fd,403,"application/json","{\"error\":\"This change requires a manager card.\"}");return;}
 char idtext[24]="",newrole[8]="",newactive[8]="";
 if(!form_value(body,"id",idtext,sizeof idtext)||!form_value(body,"manager",newrole,sizeof newrole)||!form_value(body,"active",newactive,sizeof newactive)){
  send_response(fd,400,"application/json","{\"error\":\"Fill in all required fields.\"}");return;
 }
 char *end=NULL;long id=strtol(idtext,&end,10);
 if(!idtext[0]||*end||id<0||id>2147483647||(strcmp(newrole,"0")&&strcmp(newrole,"1"))||(strcmp(newactive,"0")&&strcmp(newactive,"1"))){
  send_response(fd,400,"application/json","{\"error\":\"Check the entries and try again.\"}");return;
 }
 int role=0,active=1;
 if(id){sqlite3_stmt*q=NULL;int found=0;
  if(sqlite3_prepare_v2(db,"SELECT e.active,EXISTS(SELECT 1 FROM employee_roles r WHERE r.employee_id=e.id AND r.role='manager') FROM employees e WHERE e.id=?1",-1,&q,NULL)==SQLITE_OK){sqlite3_bind_int(q,1,(int)id);if(sqlite3_step(q)==SQLITE_ROW){found=1;active=sqlite3_column_int(q,0);role=sqlite3_column_int(q,1);}}sqlite3_finalize(q);
  if(!found){send_response(fd,404,"application/json","{\"error\":\"Employee not found. Reload the page.\"}");return;}
 }
 if((newrole[0]=='1')!=role||(newactive[0]=='1')!=active){send_response(fd,403,"application/json","{\"error\":\"This change requires a manager card.\"}");return;}
 management_save(fd,body,who,1);
}
static void employee_change_arm(int fd,int who,const char *body){
 if(!body||strlen(body)>3500){send_response(fd,400,"application/json","{\"error\":\"Check the entries and try again.\"}");return;}
 {char op[32],f[130],l[130],p[170];
  /* card_status is the only non-employee operation (manager swipe notes were removed in v0.9.48). */
  if(form_value(body,"op",op,sizeof op)&&strcmp(op,"card_status")){reply_incomplete(fd);return;}
  if(!form_value(body,"op",op,sizeof op)){const char *identity=employee_identity_error(body,f,sizeof f,l,sizeof l,p,sizeof p);if(identity){send_response(fd,400,"application/json",identity);return;}}}
 if(!approval_begin(fd))return;
 approval_finish(fd,approval_save("manager_authorization",who,body));
}
static void employee_change_status(int fd,int who){
 sqlite3_stmt*q=NULL;char body[4096]="";long long armed=0,scanned=0;char uid[40]="";int owner=0;
 const char *query="SELECT a.requested_by,a.change_body,a.armed_at,s.uid,s.scanned_at FROM manager_authorization a JOIN manager_scan s ON s.id=1 WHERE a.id=1";
 if(sqlite3_prepare_v2(db,query,-1,&q,NULL)==SQLITE_OK&&sqlite3_step(q)==SQLITE_ROW){
 owner=sqlite3_column_int(q,0);const char*b=(const char*)sqlite3_column_text(q,1);if(b)snprintf(body,sizeof body,"%s",b);
 armed=sqlite3_column_int64(q,2);const char*u=(const char*)sqlite3_column_text(q,3);if(u)snprintf(uid,sizeof uid,"%s",u);scanned=sqlite3_column_int64(q,4);
 }sqlite3_finalize(q);
 if(owner!=who||!armed){send_response(fd,409,"application/json","{\"error\":\"This approval is no longer valid. Start again.\"}");return;}
 if((long long)time(NULL)-armed>30){sql("DELETE FROM manager_authorization WHERE id=1");send_response(fd,200,"application/json","{\"status\":\"expired\"}");return;}
 if(!uid[0]||scanned<armed){send_response(fd,200,"application/json","{\"status\":\"waiting\"}");return;}
 int authorized=0;
 const char *check="SELECT 1 FROM manager_cards mc JOIN employees e ON e.id=mc.manager_id JOIN employee_roles r ON r.employee_id=e.id AND r.role='manager' JOIN user_accounts ua ON ua.employee_id=e.id WHERE mc.uid=?1 COLLATE NOCASE AND mc.active=1 AND e.active=1 AND ua.disabled=0";
 if(sqlite3_prepare_v2(db,check,-1,&q,NULL)==SQLITE_OK){sqlite3_bind_text(q,1,uid,-1,SQLITE_TRANSIENT);authorized=sqlite3_step(q)==SQLITE_ROW;}sqlite3_finalize(q);
 if(!authorized){sql("UPDATE manager_scan SET uid='',scanned_at=0 WHERE id=1");send_response(fd,200,"application/json","{\"status\":\"waiting\",\"message\":\"registered manager card required\"}");return;}
 /* Consume scan before performing the write, preventing re-use of this scan. */
 if(!sql("DELETE FROM manager_authorization WHERE id=1")||!sql("UPDATE manager_scan SET armed_at=0,uid='',scanned_at=0 WHERE id=1")){
 reply_failed(fd);return;}
 snprintf(approval_card_uid,sizeof approval_card_uid,"%s",uid);
 management_save(fd,body,who,0);
 approval_card_uid[0]=0;
}
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
