mkinderwater/mk-timeclock/src/oled_bitmap.c

#include "oled_bitmap.h"
#include <stddef.h>
#include <stdint.h>
#include <string.h>
struct glyph5 { unsigned char ch; uint8_t rows[7]; };
static const struct glyph5 bitmap_font[] = {
    { 32, {0x00,0x00,0x00,0x00,0x00,0x00,0x00} },
    { 65, {0x0e,0x11,0x11,0x1f,0x11,0x11,0x11} },
    { 66, {0x1e,0x11,0x11,0x1e,0x11,0x11,0x1e} },
    { 67, {0x0f,0x10,0x10,0x10,0x10,0x10,0x0f} },
    { 68, {0x1e,0x11,0x11,0x11,0x11,0x11,0x1e} },
    { 69, {0x1f,0x10,0x10,0x1e,0x10,0x10,0x1f} },
    { 70, {0x1f,0x10,0x10,0x1e,0x10,0x10,0x10} },
    { 71, {0x0f,0x10,0x10,0x17,0x11,0x11,0x0e} },
    { 72, {0x11,0x11,0x11,0x1f,0x11,0x11,0x11} },
    { 73, {0x0e,0x04,0x04,0x04,0x04,0x04,0x0e} },
    { 74, {0x07,0x02,0x02,0x02,0x12,0x12,0x0c} },
    { 75, {0x11,0x12,0x14,0x18,0x14,0x12,0x11} },
    { 76, {0x10,0x10,0x10,0x10,0x10,0x10,0x1f} },
    { 77, {0x11,0x1b,0x15,0x15,0x11,0x11,0x11} },
    { 78, {0x11,0x19,0x15,0x13,0x11,0x11,0x11} },
    { 79, {0x0e,0x11,0x11,0x11,0x11,0x11,0x0e} },
    { 80, {0x1e,0x11,0x11,0x1e,0x10,0x10,0x10} },
    { 81, {0x0e,0x11,0x11,0x11,0x15,0x12,0x0d} },
    { 82, {0x1e,0x11,0x11,0x1e,0x14,0x12,0x11} },
    { 83, {0x0f,0x10,0x10,0x0e,0x01,0x01,0x1e} },
    { 84, {0x1f,0x04,0x04,0x04,0x04,0x04,0x04} },
    { 85, {0x11,0x11,0x11,0x11,0x11,0x11,0x0e} },
    { 86, {0x11,0x11,0x11,0x11,0x11,0x0a,0x04} },
    { 87, {0x11,0x11,0x11,0x15,0x15,0x15,0x0a} },
    { 88, {0x11,0x11,0x0a,0x04,0x0a,0x11,0x11} },
    { 89, {0x11,0x11,0x0a,0x04,0x04,0x04,0x04} },
    { 90, {0x1f,0x01,0x02,0x04,0x08,0x10,0x1f} },
    { 48, {0x0e,0x11,0x13,0x15,0x19,0x11,0x0e} },
    { 49, {0x04,0x0c,0x04,0x04,0x04,0x04,0x0e} },
    { 50, {0x0e,0x11,0x01,0x02,0x04,0x08,0x1f} },
    { 51, {0x1e,0x01,0x01,0x0e,0x01,0x01,0x1e} },
    { 52, {0x02,0x06,0x0a,0x12,0x1f,0x02,0x02} },
    { 53, {0x1f,0x10,0x10,0x1e,0x01,0x01,0x1e} },
    { 54, {0x0e,0x10,0x10,0x1e,0x11,0x11,0x0e} },
    { 55, {0x1f,0x01,0x02,0x04,0x08,0x08,0x08} },
    { 56, {0x0e,0x11,0x11,0x0e,0x11,0x11,0x0e} },
    { 57, {0x0e,0x11,0x11,0x0f,0x01,0x01,0x0e} },
    { 44, {0x00,0x00,0x00,0x00,0x04,0x04,0x08} },
    { 45, {0x00,0x00,0x00,0x1f,0x00,0x00,0x00} },
    { 58, {0x00,0x04,0x04,0x00,0x04,0x04,0x00} },
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
};
static const uint8_t *bitmap_rows(char c){
    if(c>='a'&&c<='z') c=(char)(c-'a'+'A');
    for(size_t i=0;i<sizeof(bitmap_font)/sizeof(bitmap_font[0]);i++){
        if(bitmap_font[i].ch==(unsigned char)c)return bitmap_font[i].rows;
    }
    return bitmap_font[0].rows;
}
int oled_bitmap_width(const char *s){return (int)strlen(s)*6-1;}
void oled_bitmap_text_on(oled_t *o,const char *s,int x,int y,int on){
    for(;*s;s++,x+=6){
        const uint8_t *rows=bitmap_rows(*s);
        for(int r=0;r<7;r++)for(int col=0;col<5;col++){
            if(rows[r] & (1U << (4-col))) oled_pixel(o,x+col,y+r,on);
        }
    }
}
void oled_bitmap_text(oled_t *o,const char *s,int x,int y){oled_bitmap_text_on(o,s,x,y,1);}
