mkinderwater/mk-timeclock/src/clock_preview.h

#ifndef CLOCK_PREVIEW_H
#define CLOCK_PREVIEW_H
#define CLOCK_PREVIEW_HTML "<section class='today-preview'><div><canvas id='oled' width='128' height='64' aria-label='Current clock display'></canvas></div><div class='today-preview-meta'><span id='previewStatus' class='muted'>Loading...</span></div></section>"
#define CLOCK_PREVIEW_JS "<script>const sel=document.getElementById('clock_id'),ps=document.getElementById('previewStatus');" \
 "async function refresh(){let id=sel.value;if(!id)return;try{let r=await tc.request('/api/v1/preview?clock_id='+encodeURIComponent(id),{cache:'no-store'});if(!r.ok){document.getElementById('oled').parentElement.hidden=true;ps.replaceChildren(tc.flag('Offline','problem'));hasPreview=false;return}document.getElementById('oled').parentElement.hidden=false;let o=await tc.json(r);let c=document.getElementById('oled').getContext('2d'),d=c.createImageData(128,64);for(let y=0;y<64;y++)for(let x=0;x<128;x++){let z=(y>>3)*128+x,b=parseInt(o.frame.substr(z*2,2),16),on=(b>>(y&7))&1,i=(y*128+x)*4;d.data[i]=d.data[i+1]=d.data[i+2]=on?255:0;d.data[i+3]=255;}c.putImageData(d,0,0);" \
 "let when=new Date(o.updated_at),age=(Date.now()-when.getTime())/1000;ps.replaceChildren();if(age>=180)ps.append(tc.flag('Offline','problem'),' ');ps.append('Updated '+tc.time(when)+(age>=180?' ('+tc.ago(age)+' ago)':''));}catch(e){tc.err(ps,e);}}" \
 "let previewBusy=false,hasPreview=true;async function refreshPreview(){if(document.hidden||previewBusy||!hasPreview)return;previewBusy=true;try{await refresh()}finally{previewBusy=false}}sel.addEventListener('change',()=>{hasPreview=true;refreshPreview()});refreshPreview();setInterval(refreshPreview,4000);document.addEventListener('visibilitychange',()=>{if(!document.hidden)refreshPreview()});</script>"
#endif
